MrLordLeon/TNCMCU/README.md

# Project 2: TNCMCU

**Project Members:**
- David C.
- Kobe K.
- Kaleb L.

**Project Mentors:**
- Nolan E.
- Rizwan M.
- Nick P.
- James P.

## Project Description
Current implementations of the Terminal Node Controller use a telephone FSK modem to transmit binary  data via the APRS system. These FSK modems are outdated, unavailable, and obsolete. The signals are transmitted at 1200 baud using audio signals of 1200 and 2200 Hz.

## Project Challenge
Design, implement, build, and test aTNCwith an STM32 or similar microcontroller. The system must accept a string via UART or a similar interface and generate the necessary APRS and HDLC headers/packet data and then produce the correct audio waveform. This audio waveform will then be fed to a speaker, handheld radio, HAM radio set, or dedicated FM modulator (design team not responsible for this portion, only the audio waveform generation).The system must also accept an audio waveform input from a microphone, handheld radio, HAM radio set, or dedicated FM receiver (design team not responsible for this portion, only the audio waveform interpretation) and be able to translate this audio into APRS/HDLC, and transmit a fully translated message to the controlling device via UART or a similar interface.The  initial implementation should use COTS development kits as a proof of concept. Once the software and design have been verified and validated, the hardware shall be implemented into a standalone PCB with connections for a PC, Raspberry PI, Arduino, and standard handheld radio.

###### The team will have to familiarize themselves with the following:
- microcontroller C programming and hardware including:
	- timers
	- interrupts
	- ADC 
	- DAC
	- various comms interfaces
	
- schematic design and PCB layout
- analog circuitry design
- APRS, HDLC, and other packet radio standards
- responsible software development using thorough verification/validation techniques including:
	- flowcharting
	- failure analysis
	- unit testing
	- etc.

Ideally, this team would be composed of 2 students able to put at least 8 hours per week on this project. I have already done some proof of concept work on the frequency detection and sine waveform generation, and both features work to my satisfaction.

## Repo notes
*Not a permanent structures, very flexible!*

**Design Deliverables -** Generally anything we need for assignments or papers can be put here

**Hardware Specs -** Documentation for any hardware used in the project. Renaming the file to something interpretable is preferred, I.E. don't download from mouser and have the file named file001.pdf.

**Presentations -** This is where we'll keep presentations for mentors or Dr. Darby. Please preceed file name with date of presentation.

**Protocol Documentation -** This is where any relevant information about AX.25/KISS/HDLC/etc... can go. Same process with the hardware specs, useful naming means useful people.

**Schematics -** This is where we put our schematics for our external circuits.

**Software -** This is where all of our main code and testing software is stored.

**Subsystem Documentation -** This is where we store our information on CRC calculation.
