MrLordLeon/TNCMCU/Presentations/11_2_20 EECE-443-Design-I-Team2- TNC-MCU-Design-Deliverable 5 Presentation.pptx

## MCU TNC Deliverable 5

David Cain, Kobe Keopraseuth, and Kaleb Leon

## Testing Tree Progress

## Hardware

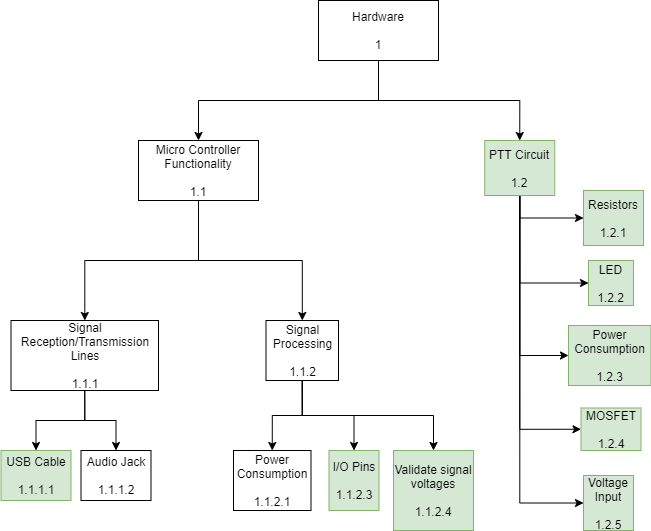
[picture p1: figure]

## Software

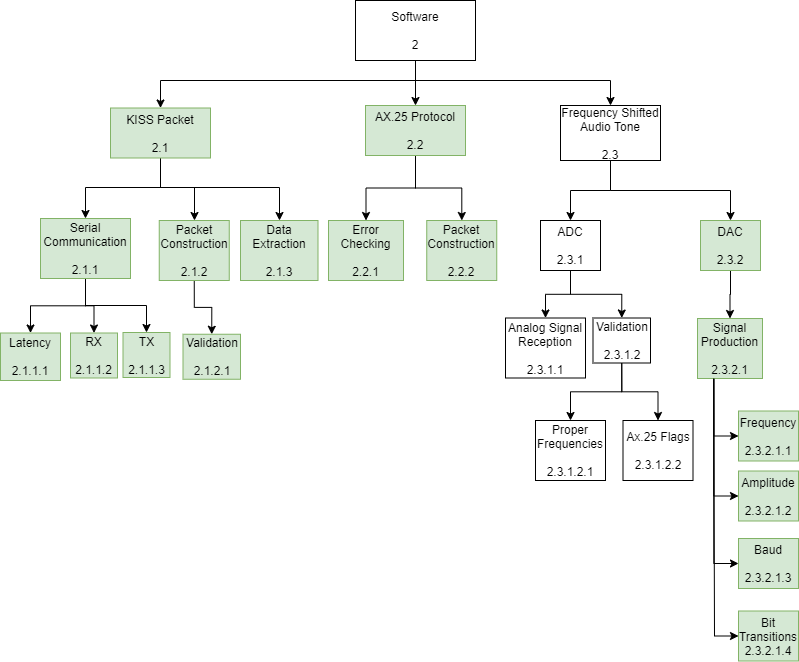
[picture p2: figure]

## Testing Forms

## Slide 6

## Slide 7

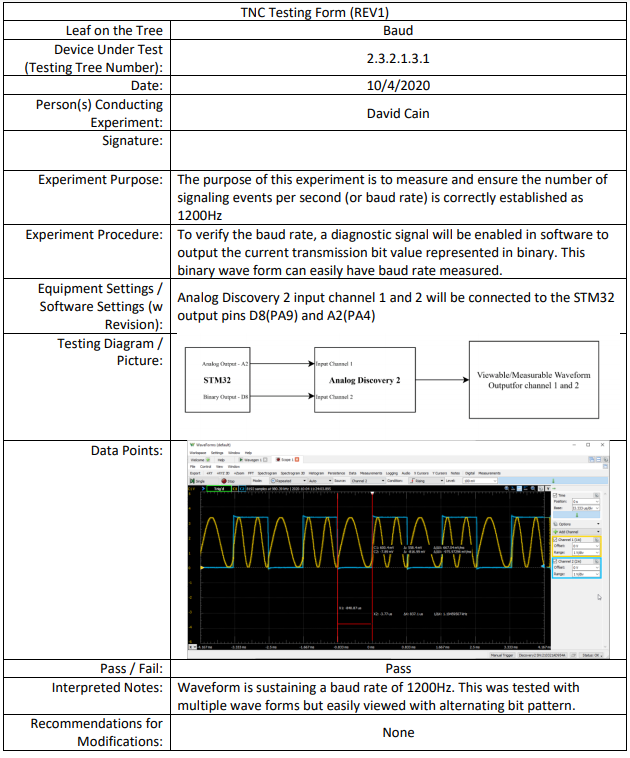
[picture p3: figure]

## Slide 8

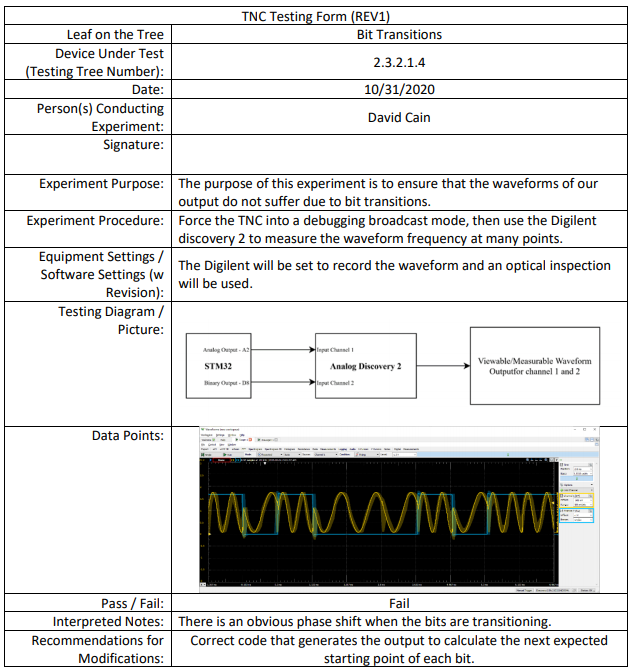
[picture p4: figure]

## Slide 9

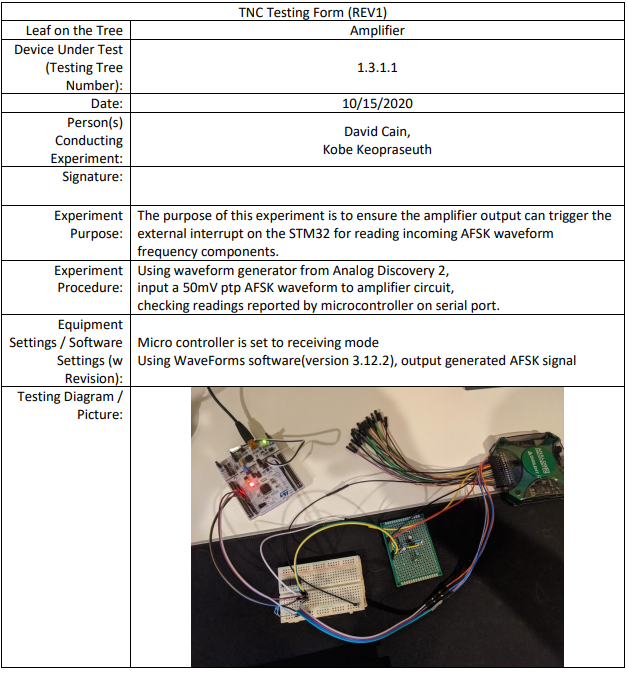
[picture p5: figure]
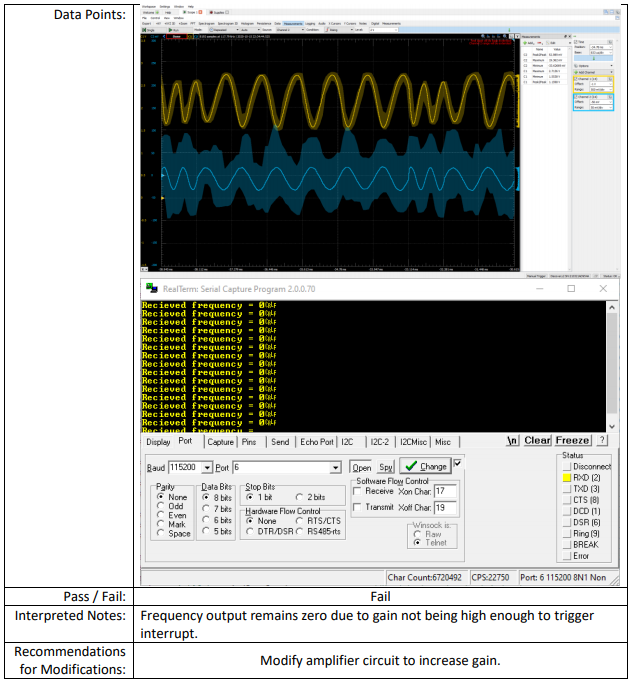
[picture p6: figure]

## Slide 10

## Changes Made to Testing Plan

- Removing Audio Input Circuit (1.3)
  - Amplifier (1.3.1) also removed
  - LP Filter (1.3.2) also removed
- Testing clock recovery and data decoding with new board provided by the mentors
- Removed RS232 Jack (1.1.1.3)
- Removed Validation (2.2.2.1) under packet construction because it was redundant

## Change Order Forms

## Slide 13

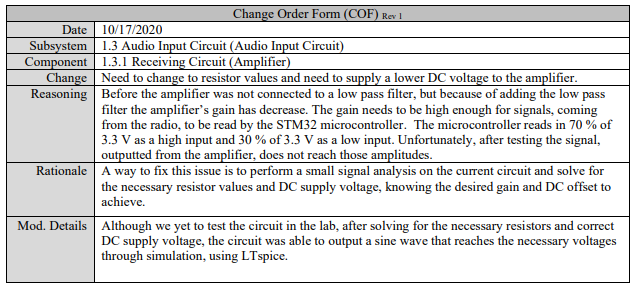
[picture p7: figure]

## Slide 14

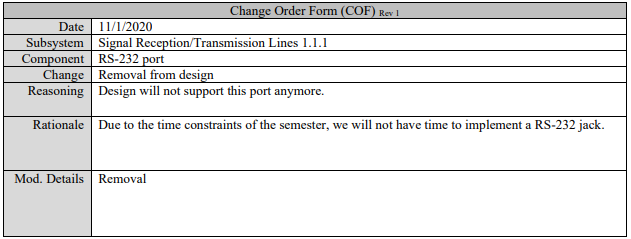
[picture p8: figure]

## Slide 15

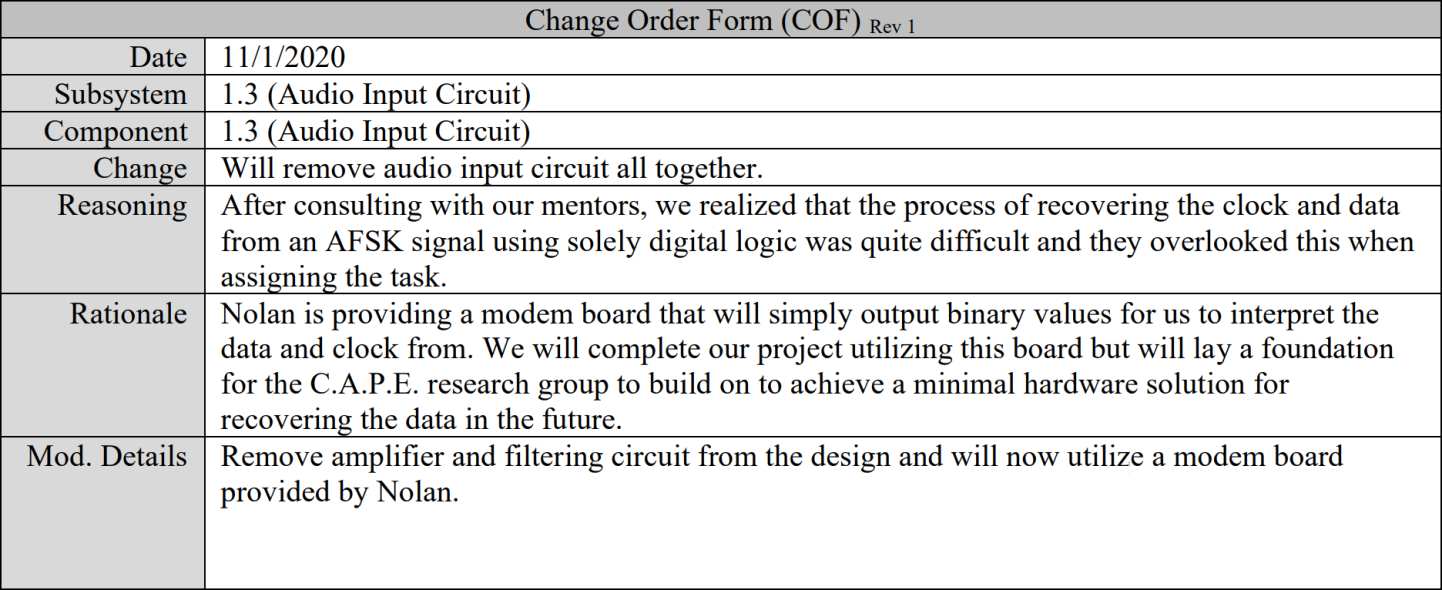
[picture p9: figure]

## Tests to be done by Project End

- Analog to Digital Conversion aka Receiving
  - Needs additional tweaking to have initial functionality
- Audio tone RX and TX full subsystem test
- Full software test
- Micro Controller functionality testing
  - Power Consumption (1.1.2.1) in Signal Processing
  - Audio Jack (1.1.1.2) in transmission lines
- Full Final Design Testing Coming soon

## Questions?
