MrLordLeon/TNCMCU/Design Deliverables (Paper Revisions)/Deliverable 5/11_2_20 EECE-443-Design2-Team2- TNC-MCU-Design-Deliverable 5 Presentation.pptx

## MCU TNC Deliverable 5

David Cain, Kobe Keopraseuth, and Kaleb Leon

## Testing Tree Progress

## Hardware


## Software


## Testing Forms

## Slide 6

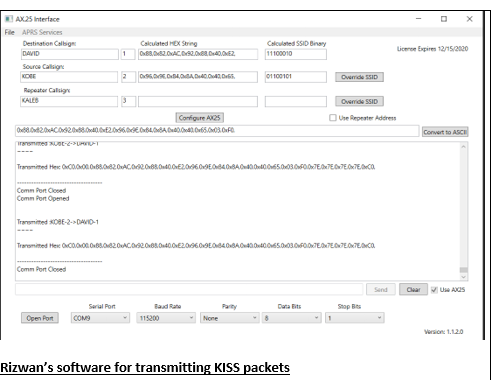
[picture p10: figure]
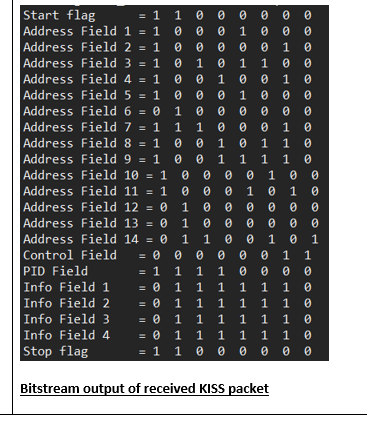
[picture p11: figure]

## Slide 7

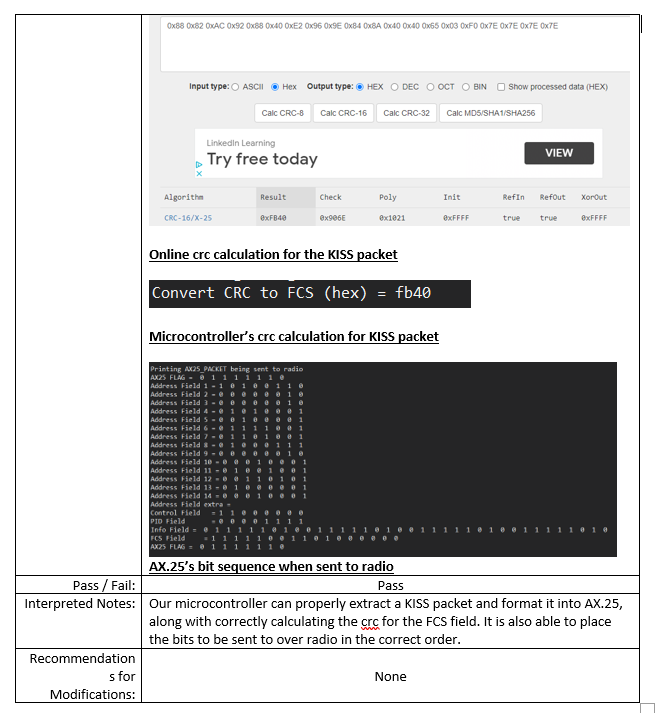
[picture p12: figure]

## Slide 8


## Slide 9


## Slide 10


## Slide 11

## Changes Made to Testing Plan

- Removing Audio Input Circuit (1.3)
  - Amplifier (1.3.1) also removed
  - LP Filter (1.3.2) also removed
- Testing clock recovery and data decoding with new board provided by the mentors
- Removed RS232 Jack (1.1.1.3)
- Removed Validation (2.2.2.1) under packet construction because it was redundant

## Change Order Forms

## Slide 14


## Slide 15


## Slide 16


## Tests to be done by Project End

- Analog to Digital Conversion aka Receiving
  - Needs additional tweaking to have initial functionality
- Audio tone RX and TX full subsystem test
- Full software test
- Micro Controller functionality testing
  - Power Consumption (1.1.2.1) in Signal Processing
  - Audio Jack (1.1.1.2) in transmission lines
- Full Final Design Testing Coming soon

## Questions?
