MrLordLeon/TNCMCU/Design Deliverables (Paper Revisions)/Weekly Status Report/Kobe/Design 1 Status Report 2.docx

Weekly Status Report

Report 1

TNC MCU Project Design

Kobe Keopraseuth

C00092349

Tuesday, March 3, 2020

Work and accomplishments this week

- Research Digipeaters and Bit stuffing for AX.25 protocol.
- Make flow chart of design to give to mentors for confirmation
- Make poster of project
- Peer Review of Group 1

Planned Activities for Next Week

- Make edits to our Assignment 1
- Meet with mentors

Time Sheet

Item | Date/Time | Description | Hours
1 | 2/20/2020 5:00pm-7pm | Make Poster of project | 2
2 | 2/26/2020 1:00pm-7pm | Flow Chart for Mentors | 6
3 | 2/25/2020 11am-3pm | Research Digipeaters and Bit stuffing for AX.25 protocol. | 4
4 | 3/1/2020 5:00pm-7pm | Peer Review Team 1
| | Total:

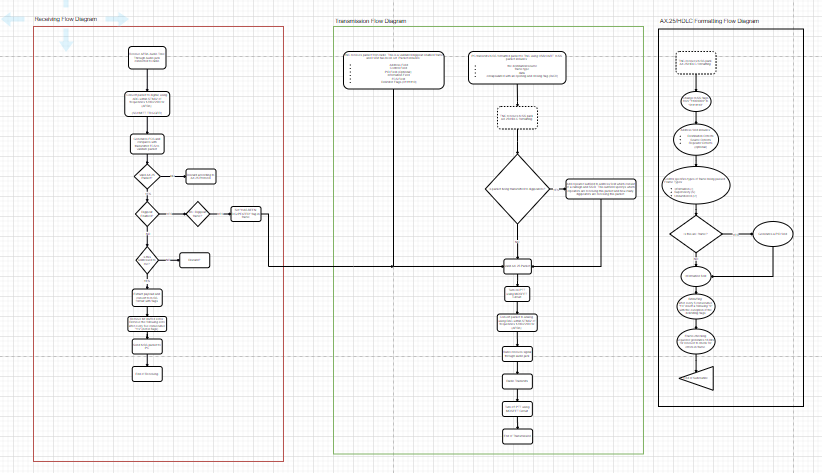
[picture p34: figure]
