MrLordLeon/TNCMCU/Design Deliverables (Paper Revisions)/Weekly Status Report/Kobe/Design 1 Status Report 3.docx

Weekly Status Report

Report 3

EECE 444

TNC MCU Project Design

Kobe Keopraseuth

C00092349

Tuesday, March 10, 2020

Work and accomplishments this week

- Assignment 1B
- Assignment 1C
- Meet with mentors
- Mandatory Cape Meeting
- Start using stm32 microcontroller

Planned Activities for Next Week

- Make edits to our Assignment 2
- Meet with mentors
- Getting more used to using the stm32 microcontroller

Time Sheet

Item | Date/Time | Description | Hours
1 | 3/3/2020 4:00pm-5pm | Meet with Mentors | 1
2 | 3/3/2020 6pm-7pm | Mandatory Cape Meeting | 1
3 | 3/7/2020 11am-6pm | Start using stm32 microcontroller | 7
4 | 3/9/2020 7:pm-10pm | Assignment 1B | 2.5
5 | 3/9/2020 10:pm-12pm | Assignment 1C | 2.5
| | Total: | 14

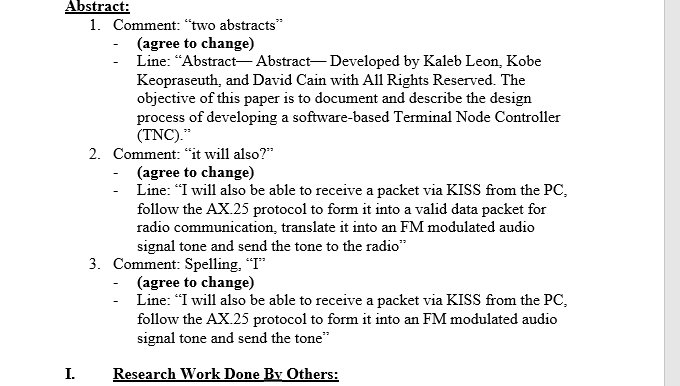
[picture p35: figure]
