MrLordLeon/TNCMCU/Design Deliverables (Paper Revisions)/Weekly Status Report/Kobe/Design 2 Status Report 1.docx

Weekly Status Report

Report 1

EECE 460

TNC MCU Project

Kobe Keopraseuth

C00092349

Monday, September 20, 2020

Work and accomplishments this week

- Deliverable 3:
- Diagram and Explanation of the tree
- Testing Tree
- CRC generation code:
- Value created based on input bit values
- Ltspice schematic of receiving circuit:
- Low Pass Filer
- Amplifier circuit

Planned Activities for Next Week

- Appendix F
- Test receiving circuit

Time Sheet

Item | Date/Time | Description | Hours
1 | 9/20/2020 5pm-9:30pm | Deliverable 3 | 4.5
2 | 9/19/2020 2pm-7pm | CRC code | 5
3 | 9/17/2020 | Rx circuit schematic | 4.5
| | Total: | 14

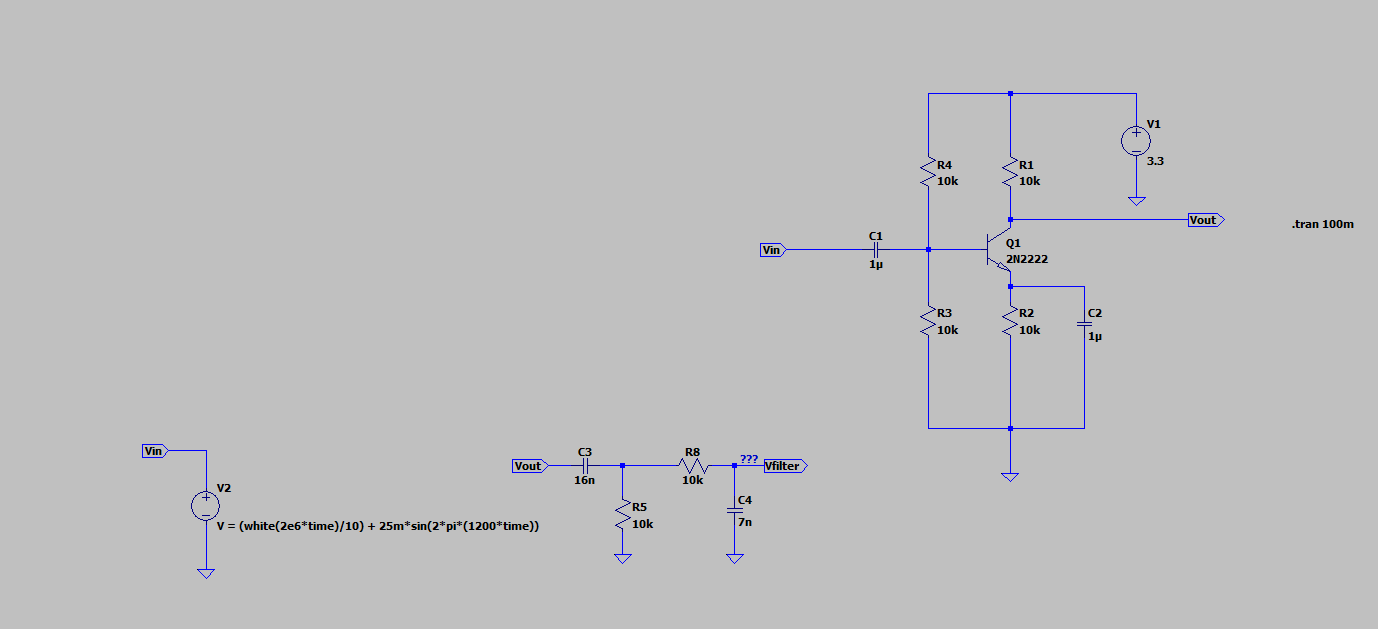
[picture p36: figure]
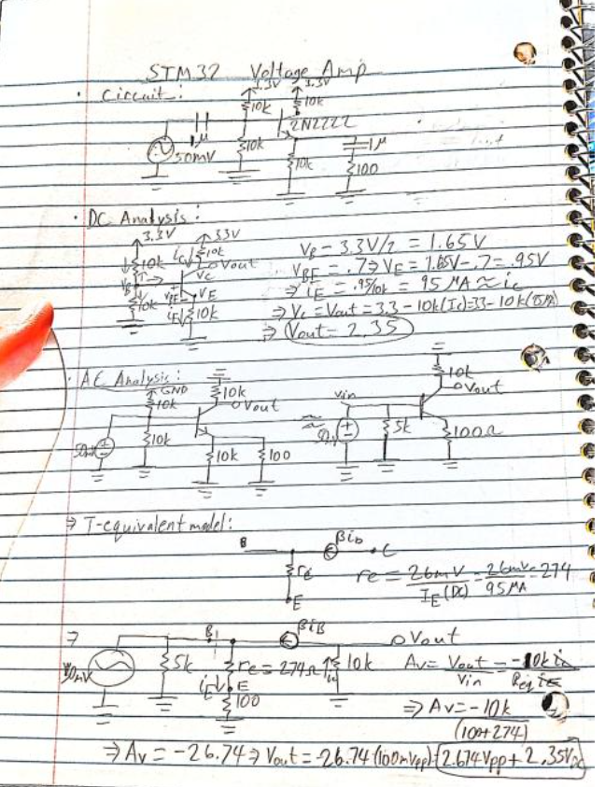
[picture p37: figure]
