MrLordLeon/TNCMCU/Design Deliverables (Paper Revisions)/Weekly Status Report/Kobe/Design 2 Status Report 3.docx

Weekly Status Report

Report 3

EECE 460

TNC MCU Project

Kobe Keopraseuth

C00092349

Monday, October 5, 2020

Work and accomplishments this week

- Code for comparing FCS field with crc generation:
- Created a function to generate a crc value with the incoming packet and compare with the packet’s FCS field to compare if they are equal, then it is a good packet.
- Solder PTT circuit

Planned Activities for Next Week

- Appendix F
- Test noisy signals received
- Prepare midterm

Time Sheet

Item | Date/Time | Description | Hours
1 | 10/3/2020 5pm-10pm | Code for CRC generatio | 5
2 | 10/4/2020 1pm – 6pm | Solder PTT | 5
| | Total: | 10

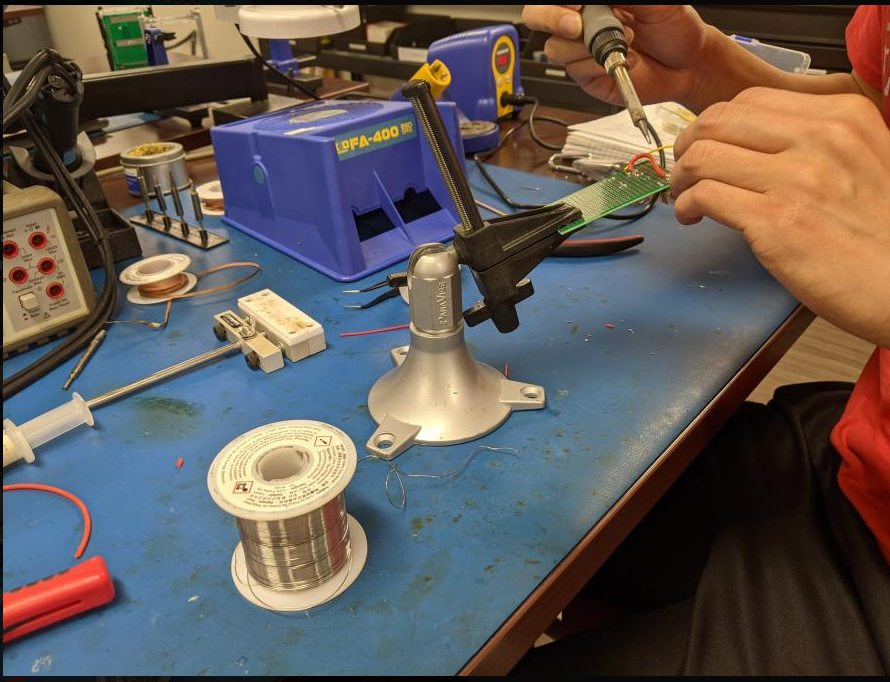
[picture p39: figure]
