MrLordLeon/TNCMCU/Design Deliverables (Paper Revisions)/Testing Documents/Complete Tests/Hardware/1.1.2.4.docx

TNC Testing Form (REV1)
Leaf on the Tree | Validate Signal Voltages
Device Under Test (Testing Tree Number): | 1.1.2.4
Date: | 11/1/20
Person(s) Conducting Experiment: | Kobe Keopraseuth, Kaleb Leon, David Cain
Signature:
Experiment Purpose: | The purpose of this experiment is to test to make sure the voltages are accurate for our analog signal on the microcontroller.
Experiment Procedure: | We will send a square wave analog signal from the Nucleo, that is generated by waiting a number of milliseconds and change the GPIO pin to output a 0 or 1. We set the amplitude to a specific value to be measured in our scope analog discovery.
Equipment Settings / Software Settings (w Revision): | We use the nucleo board with the code shown below to produce the signal. Then we read the signal using our analog discovery shown on channel 2 in the data points.

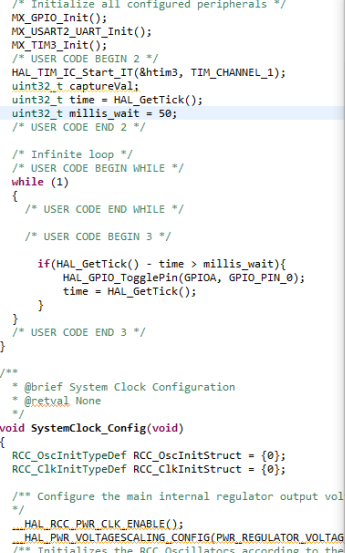
[picture p43: figure]

Testing Diagram / Picture:

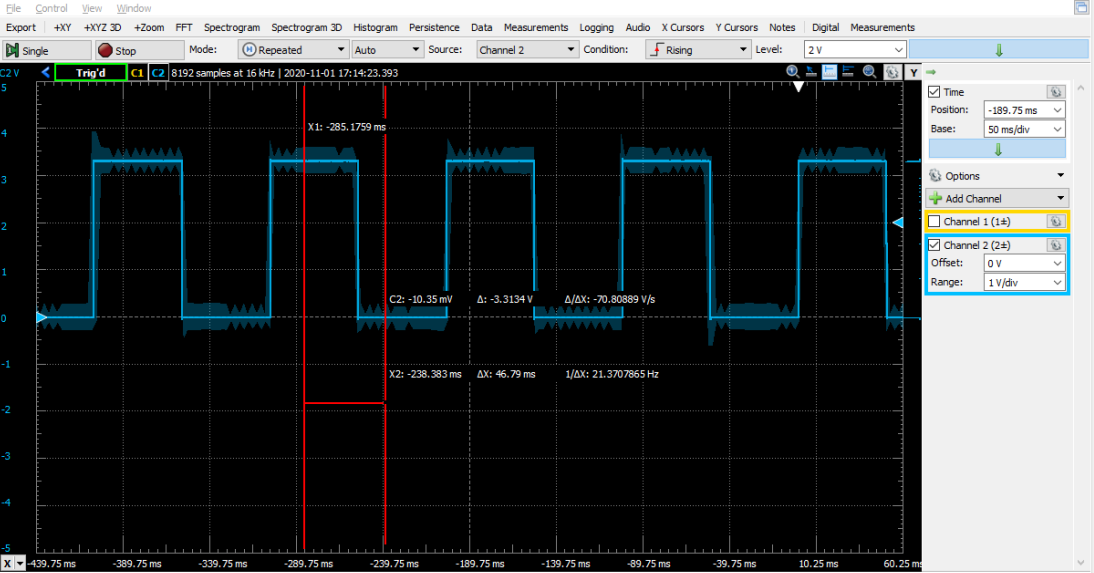
[picture p44: figure]

Data Points:
Pass / Fail: | Pass
Interpreted Notes: | The signal being displayed is correct because the amplitude of the wave meets the input set in the Nucleo code.
Recommendations for Modifications: | N/A
