MrLordLeon/TNCMCU/Presentations/10_19_20 Deliverable 4 Presentation.pptx

## MCU TNC Deliverable 4

David Cain, Kobe Keopraseuth, and Kaleb Leon

## Project Introduction

What is a TNC
A modem for connecting a computer with a HAM radio
KISS
AX.25
Why are we designing a TNC
Our design is a starting point for further development to be completed by the C.A.P.E. program
Thorough documentation

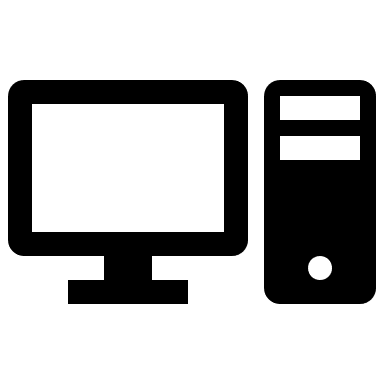
[picture p70: figure]
Computer

TNC

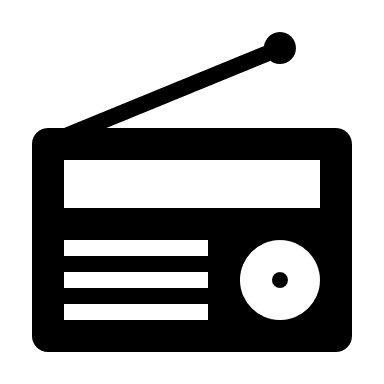
[picture p71: figure]
Radio

TNC

Diagram of TNC use

## Technical Details

KISS
Packet structure used to get information from computer into TNC
AX.25
Packet structure used when output audio waveform for radio to transmit
AFSK
Frequency encoding scheme used to represent data bitstream
Bi-modal frequency representation

AX.25 Packet Structure

## Current Progress

Code
Transmission
    - Using onboard DAC, an AFSK waveform is output
    - Baud rate is controlled by a timer interrupt for high precision
Receiving
    - Default mode until signaled to transmit
    - Count frequencies coming from radio by using external interrupt
Hardware
Transmission
    - MOSFET controls PTT line from radio
    - LED indicate transmission status
Receiving
    - BJT voltage amplifier circuit tuned to trigger hardware interrupt on controller
    - Output is filter with Low-Pass Filter
    - LED indicates Receiving status

## Remaining Effort

• Finish receiving logic
  - CRC calculation
  - Add more packet fault detection
  - NRZI Encoding detection
• Finish transmission logic
  - AFSK waveform currently has voltage blips from software
  - Add hardware for scaling down a 3.3V ptp AFSK signal
  - NRZI Encoding
