MrLordLeon/TNCMCU/Presentations/4_2_20 Assignment 2C Presentation.pptx

## Assignment 2C Presentation EECE 443 Team 2: MCU TNC Design Kaleb Leon – C00094357 Kobe Keopraseuth – C00092349 David Cain – C00043561 April 2nd, 2020

## MCU TNC Assignment 2C

David Cain, Kobe Keopraseuth, and Kaleb Leon

## Adjustments

Added Safety requirements to Preliminary Design. Considered specified needs with consideration of public health, safety, and welfare, as well as global, cultural, social, environmental, and economic factors.
Made and Added OSI layered communication model to Appendix D
Made flowchart easier to read as well as fixed some connections
Corrected any Grammatical and Formatting Errors needed

## Receiving Flowchart

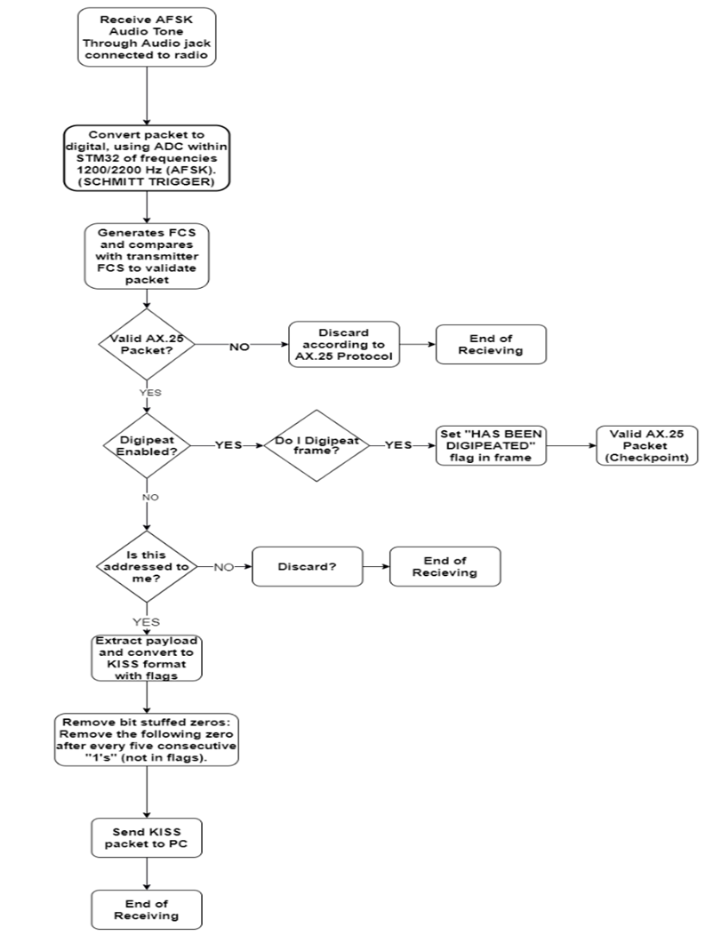
[picture p77: figure]

## Transmitting Flowchart

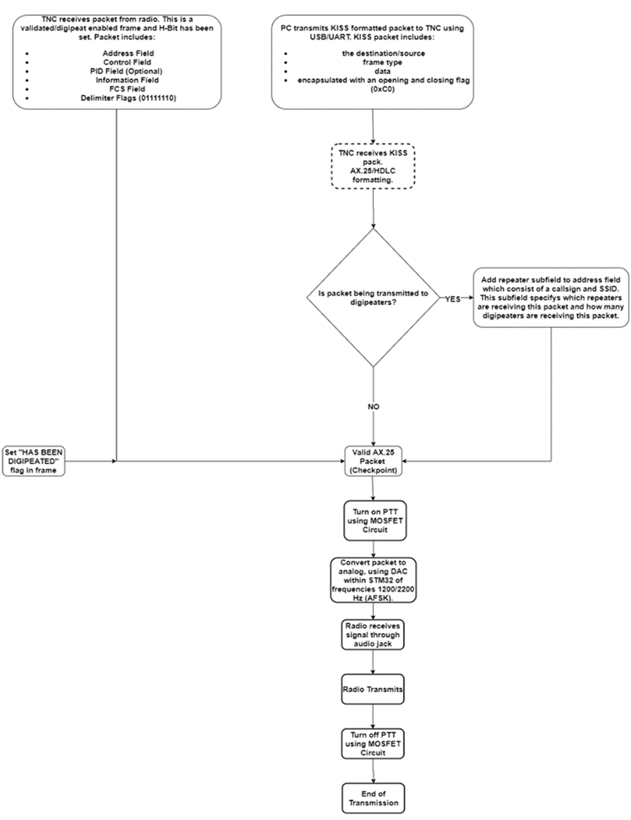
[picture p78: figure]

## Formatting Flowchart

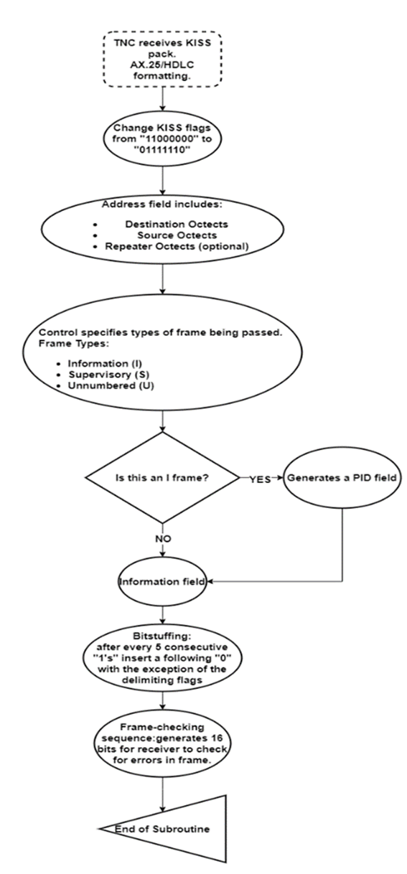
[picture p79: figure]

## OSI Layer Communications Model

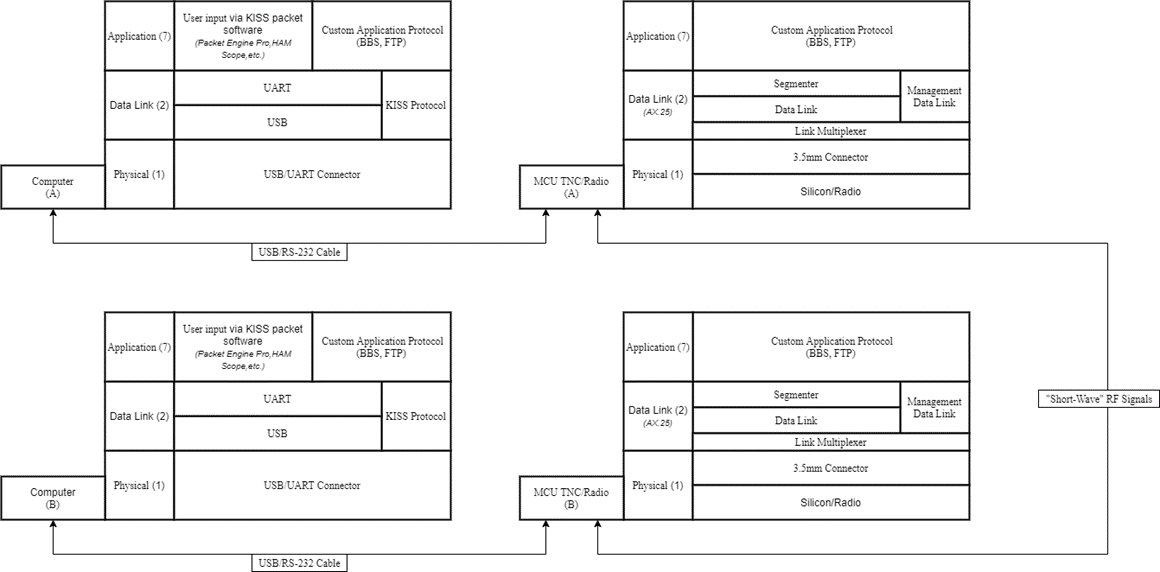
[picture p80: figure]
