MrLordLeon/TNCMCU/Presentations/3_20_20 Assignment 2 Presentation.pptx

## Assignment 2 Presentation EECE 443 Team 2: MCU TNC Design Kaleb Leon – C00094357 Kobe Keopraseuth – C00092349 David Cain – C00043561 March 20th, 2020

## MCU TNC Assignment 2

David Cain, Kobe Keopraseuth, and Kaleb Leon

## Preliminary Design

Simulations
BJT PNP Circuit - http://tinyurl.com/uvuus54
Voltage Divider - http://tinyurl.com/tjcqvlk
Calculations
Drawings
Bill of Materials
Instructions of Assembly
Failure Mode Effects Analysis
Level 0/Level 1 Diagram

## Calculations

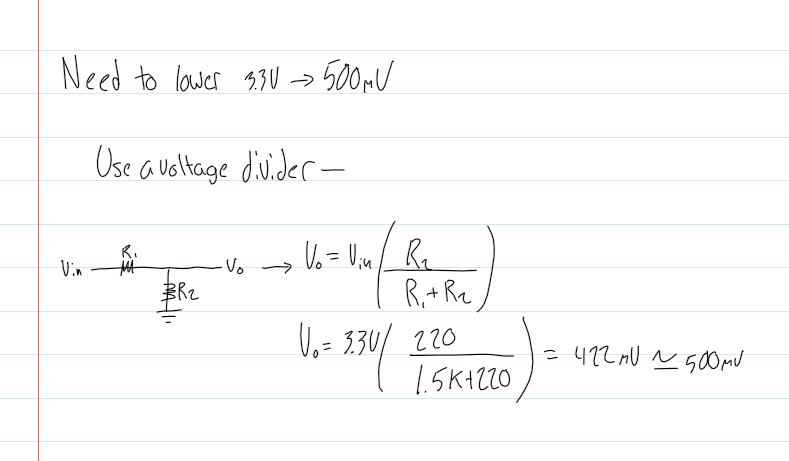
[picture p81: figure]

Voltage Divider Calculations

## Drawings

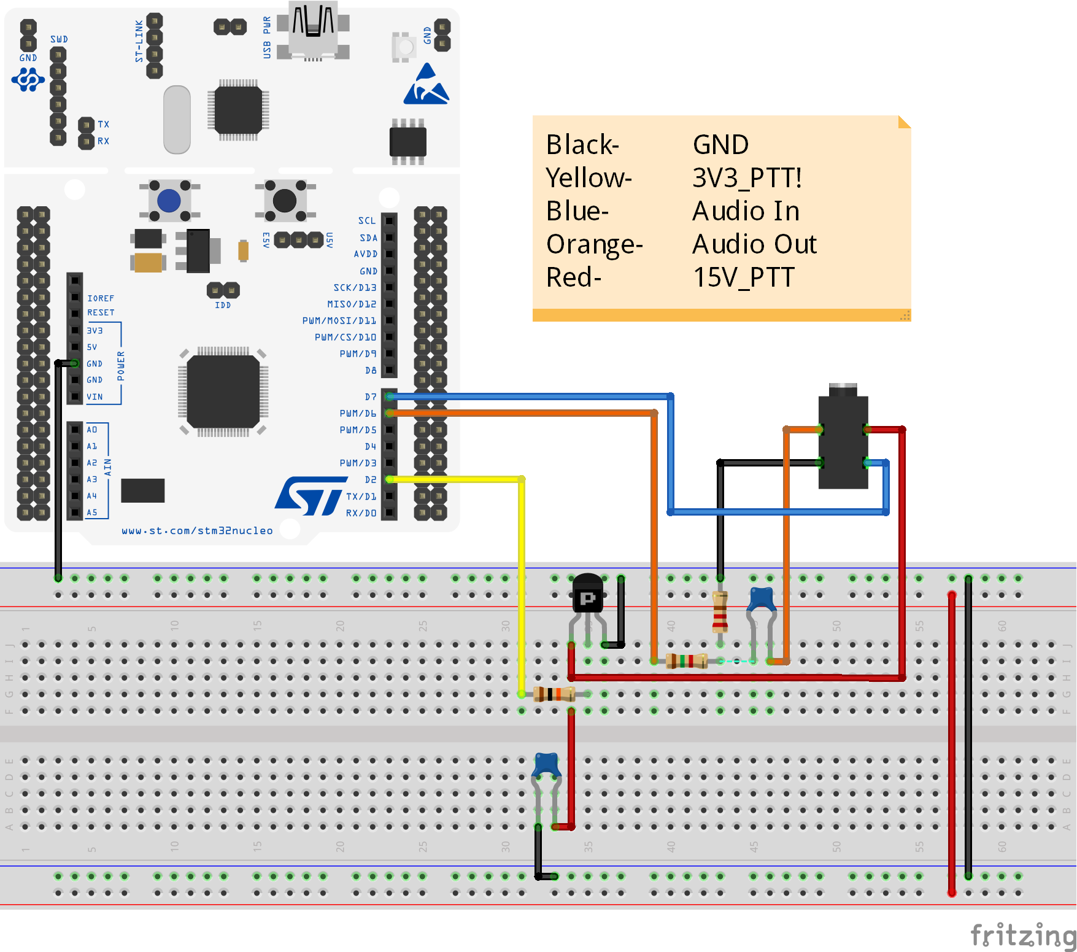
[picture p82: figure]
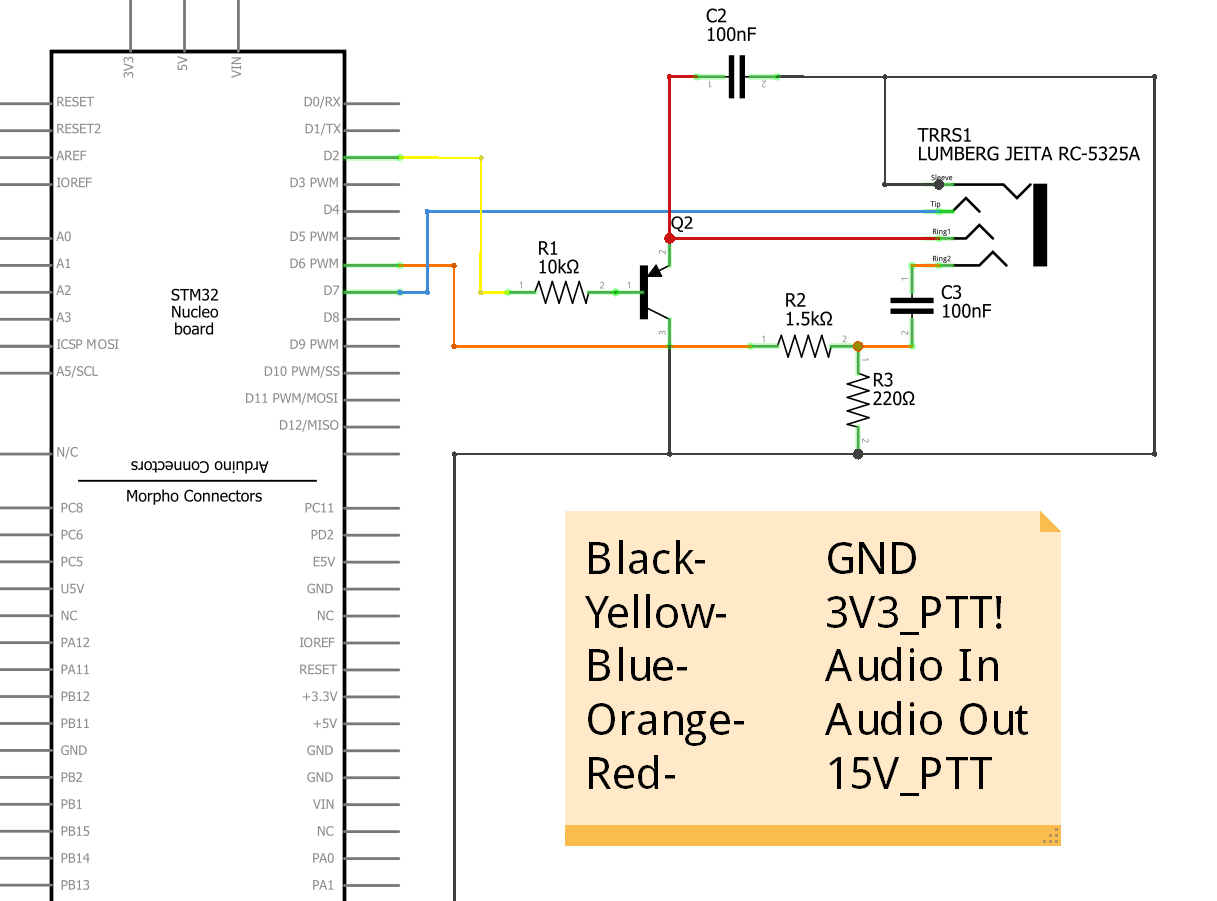
[picture p83: figure]

Breadboard Layout

Schematic Layout

## Bill of Materials

Bill of Materials Sent to Mentors

## Failure Mode Effects Analysis

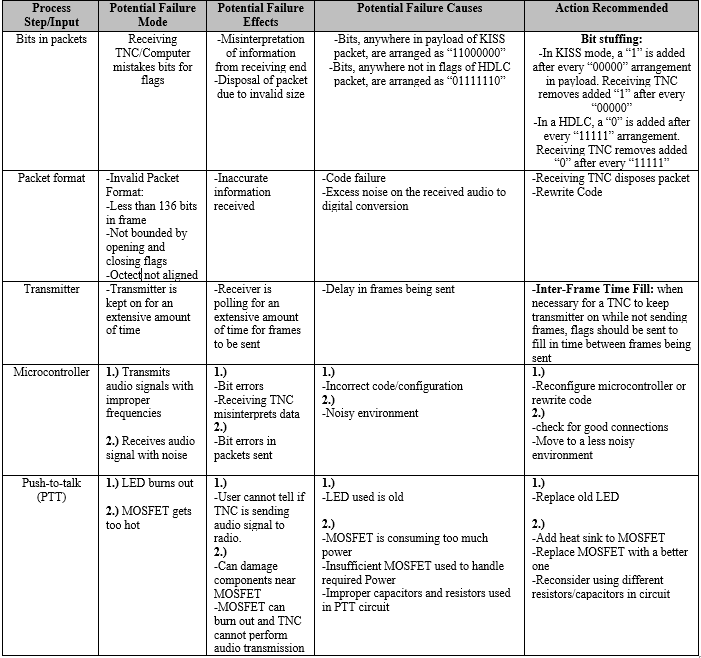
[picture p84: figure]

Failure Mode Effects Analysis

## Level 0/Level 1 Diagrams

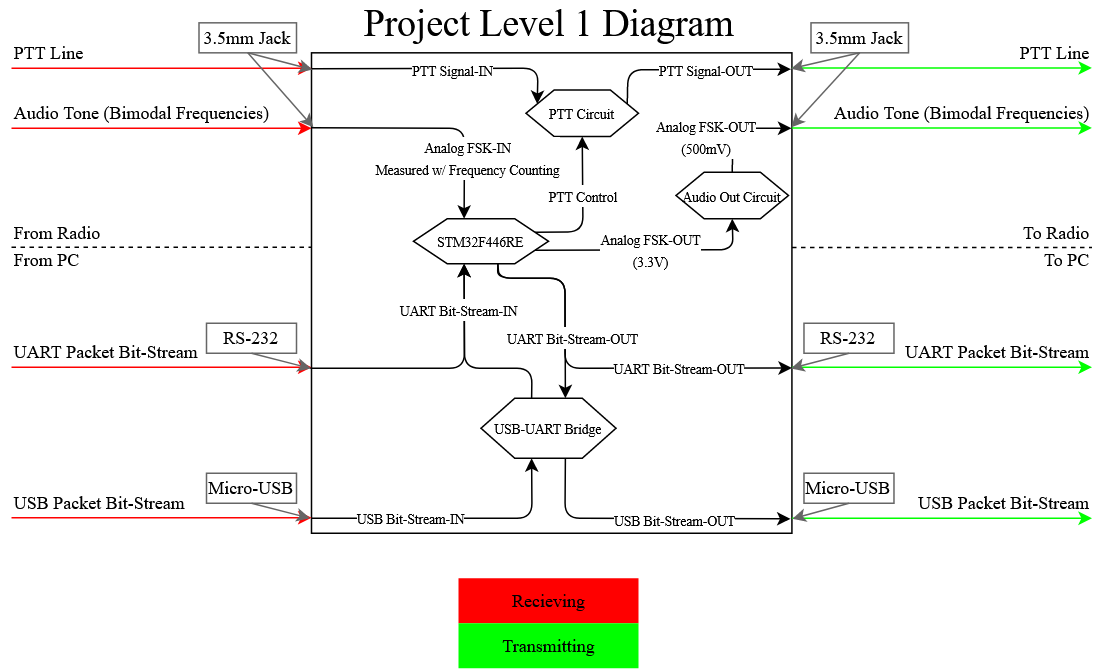
[picture p85: figure]
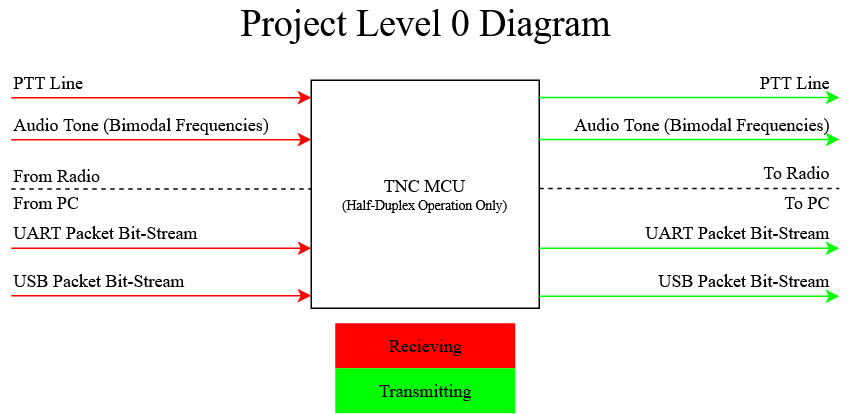
[picture p86: figure]

Level 0 Diagram

Level 1 Diagram
