MrLordLeon/TNCMCU/Hardware Specs/graph.pdf

Date/Time run: 02/14/20 00:00:46

* C:\Users\Kaleb\Desktop\Schematic1.sch Temperature: 27.0

Date: February 14, 2020 | Page 1 | Time: 00:34:12
(A) Schematic1.dat (active)

Time

0s | 2ns | 4ns | 6ns | 8ns | 10ns | 12ns
V2(R2)

-2.0V

0V

2.0V

4.0V

6.0V
