MrLordLeon/TNCMCU/Design Deliverables (Paper Revisions)/Assignment 3/EECE443 Design 1 Final Presentation - Team 2 MCU TNC Design.pdf

# MCU TNC Design

Kaleb Leon, Kobe Keopraseuth, David Cain Design 1
FINAL PRESENTATION

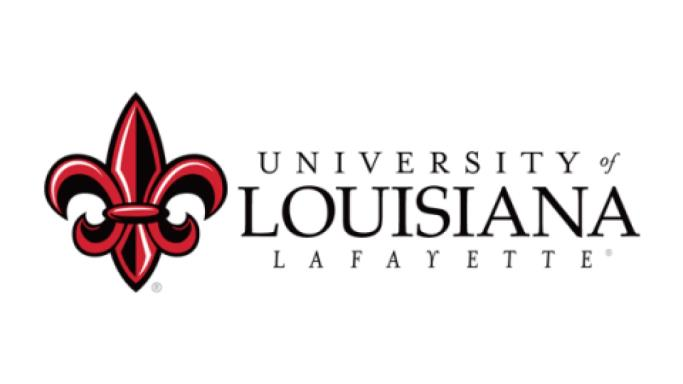
[picture p129: figure]

## Project Overview

Design a compact efficient Terminal Node Controller using the STM32 platform

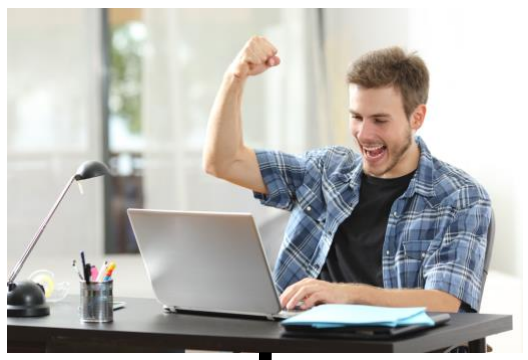
[picture p130: figure]
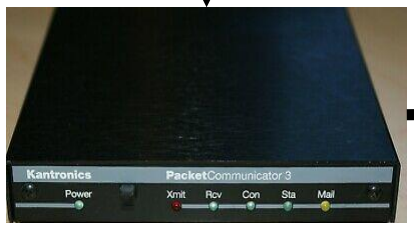
[picture p131: figure]

Radio | Radio

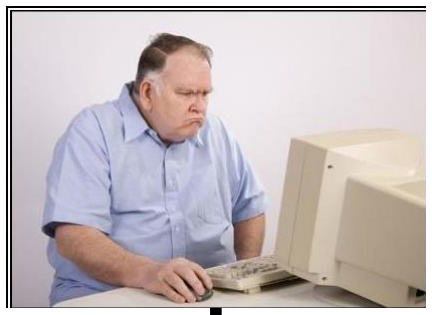
[picture p132: figure]

STM32 TNC | TAPR TNC-1

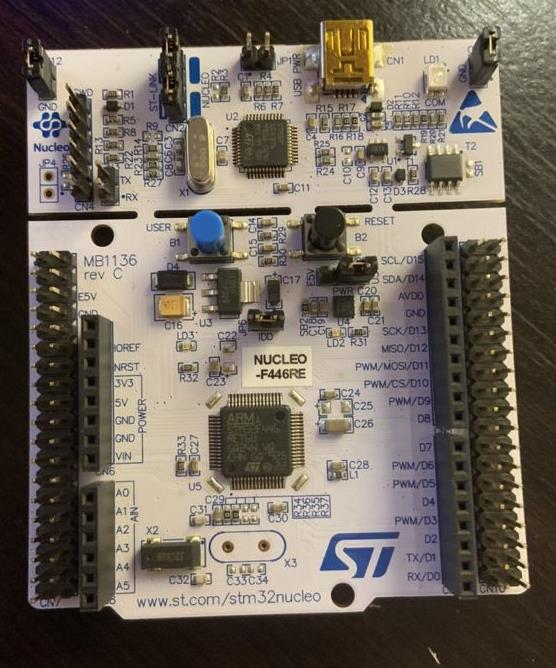
[picture p133: figure]

Size: 2’’x2’’
Logic:
Coded in C without much external hardware of chips
Hardware:
Nucleo STM32 Board
Documentation:
- Easier to document code ( also easier to find and reuse)
- Nucleo Board is proprietary hardware and well documented and tested

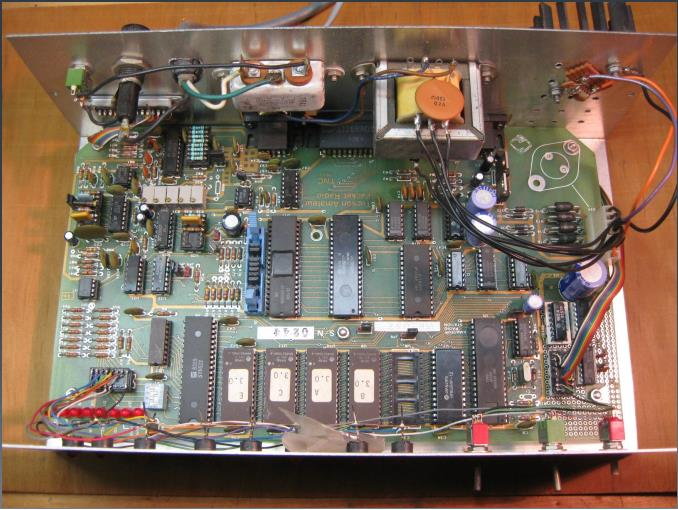
[picture p134: figure]

Size: 1’x6’’
Logic:
Data formatted mostly by analog logic chips Hardware:
Many circuits in addition to many integrated chips Documentation:
- Not well documented
- hard to find info to repair if something is wrong
- many different designs so only people who make these know how to fix them

VS.

Full Setup:
$53

Full Setup:
~ $140

# Design Process

## Scope of Work & Functional Block Diagram

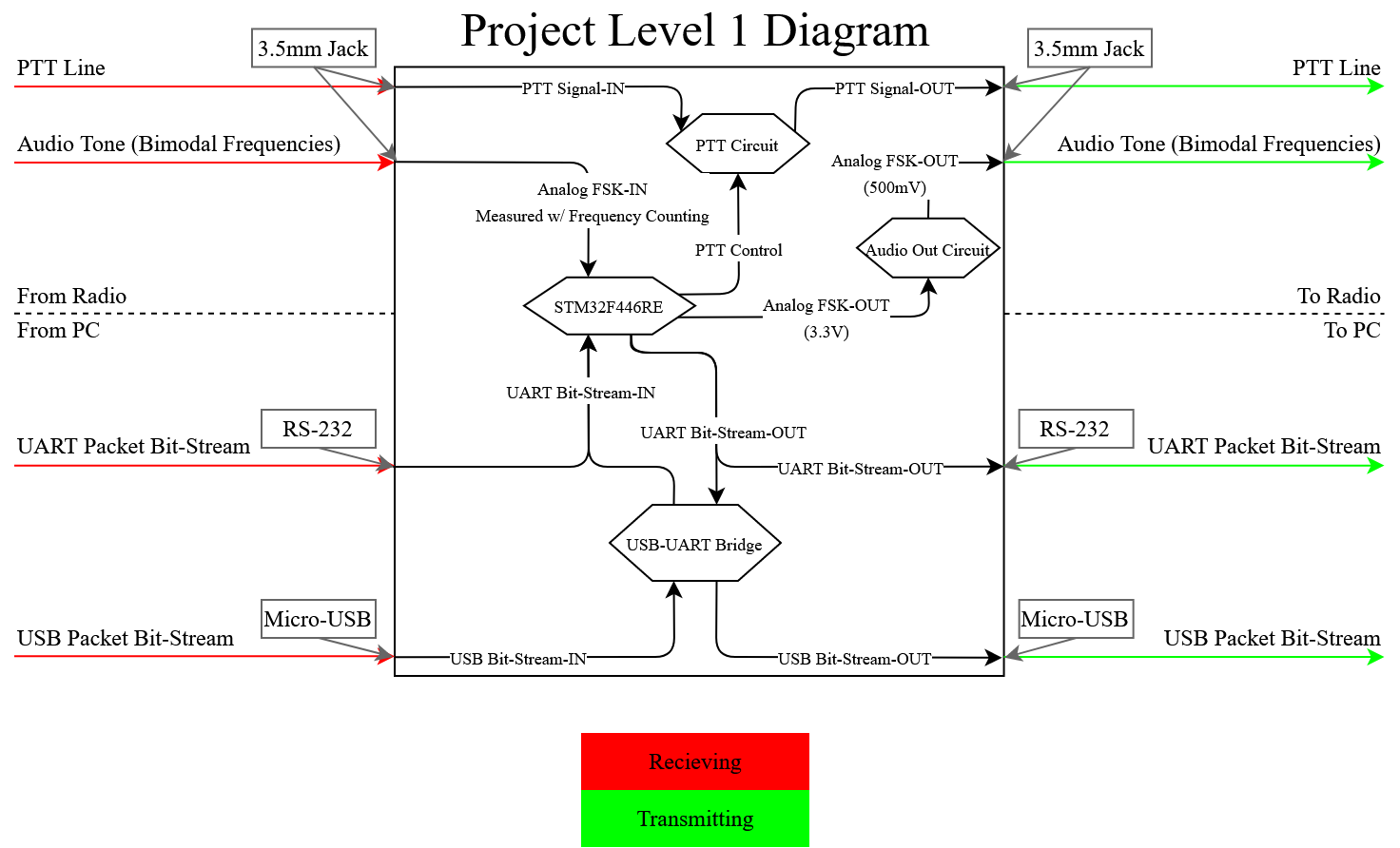
[picture p135: figure]

To Implement and
design a Terminal node
Controller using the
STM32 platform that is
capable receiving and
transmitting data
packets, serving as a
modem between a PC
and a radio.

## Alternatives and Tradeoffs

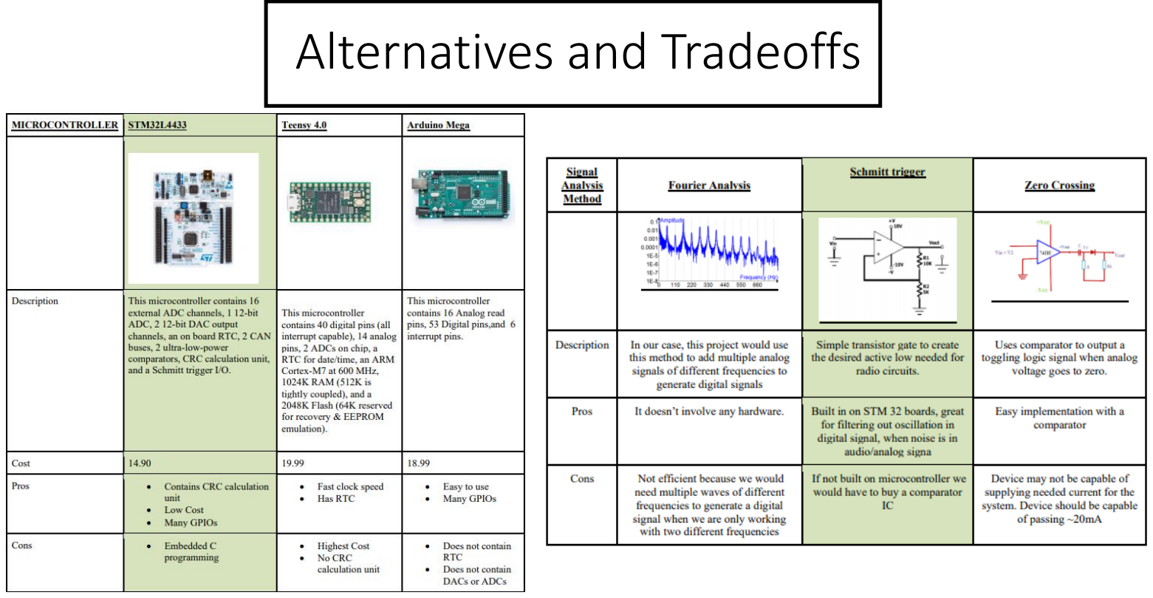
[picture p136: page 6]

## Alternatives and Tradeoffs

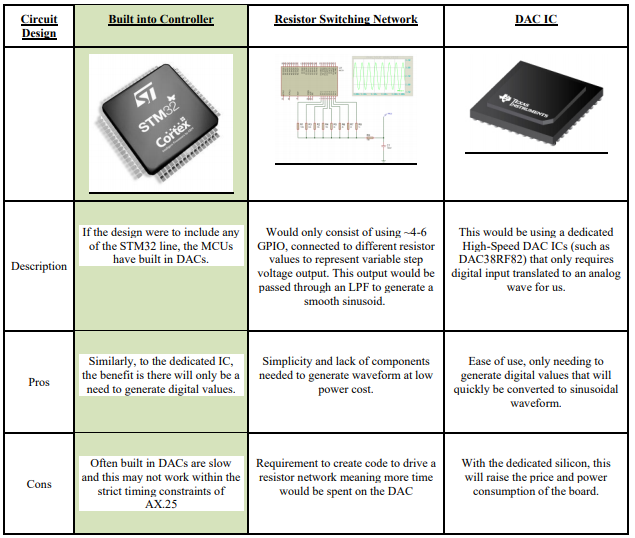
[picture p137: figure]

## Feasibility Analysis

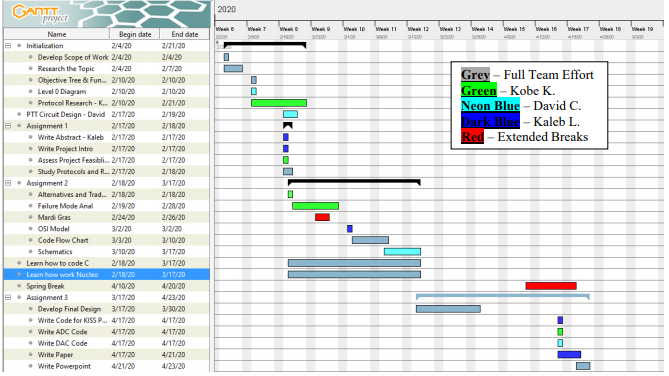
[picture p138: figure]

## Feasibility Analysis

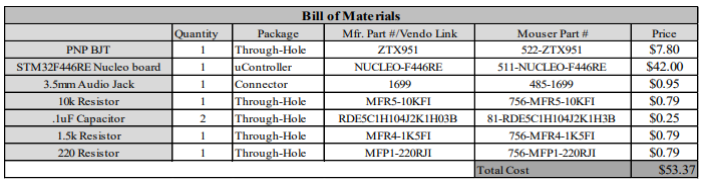
[picture p139: figure]

## Software Flow Breakdown

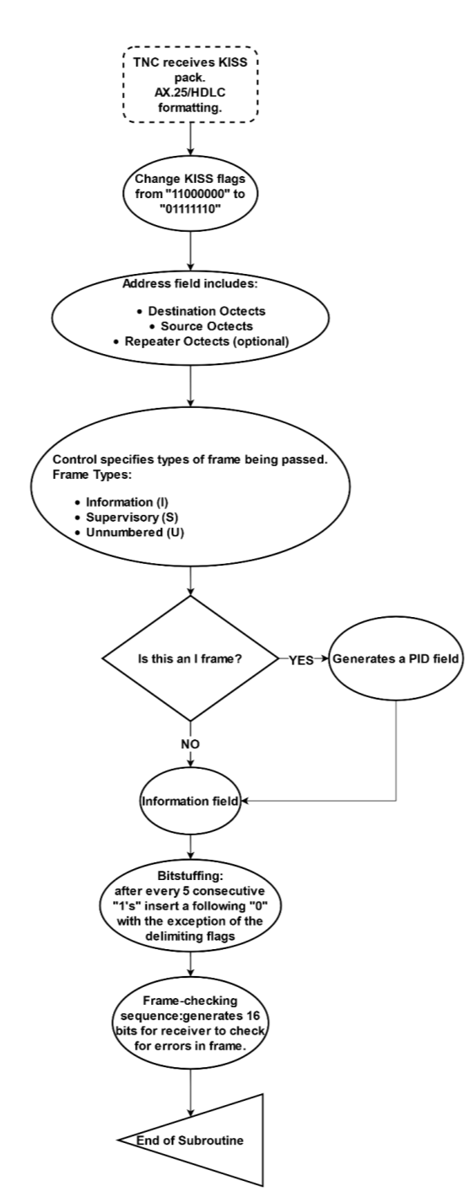
[picture p140: figure]

VALIDATION/TESTING:
Create our own packets of which we know what the data section says (example in HEX “Hello world”). This HEX packet is sent to the TNC over the USB. It is then picked apart for its data section. This data section is then translated back into HEX then Ascii and outputted to serial. We monitor this serial to see if it is outputting the correct data.

## KISS Packet to AX.25

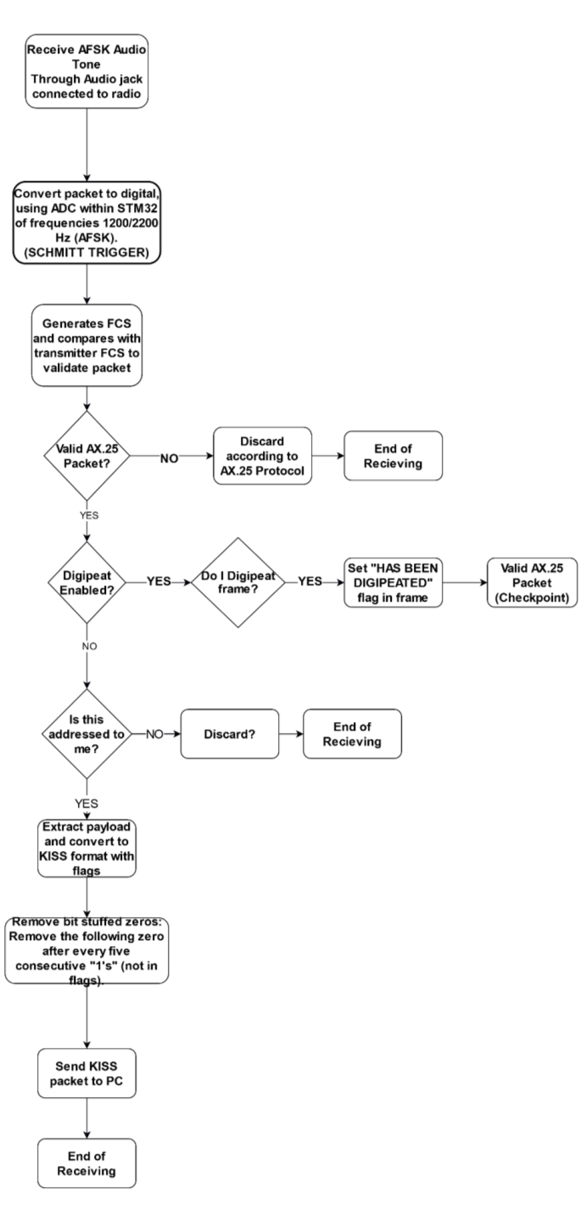
[picture p141: figure]

- In this mode the TNC will be receiving and measuring the frequency of the audio tones from the radio.
- If a tone matches 2200/1200 Hz (5% tolerance) then a 1/0 will be stored in an array, respectively.
- Once the conversion is finished, the STM32 will generate a CRC value to compare with FCS section of packet. If it does not match, then discard packet.
- If it does match, check if digipeat is enabled. If so, turn on PTT and got into transmitting mode.
- If digipeat is not enabled, then check if packet’s address matches the TNC’s address, if not discard.
- Convert packet stored in array to KISS format.
- Transmit packet to PC through USB or UART.

## Receiving Mode

Analog to Digital

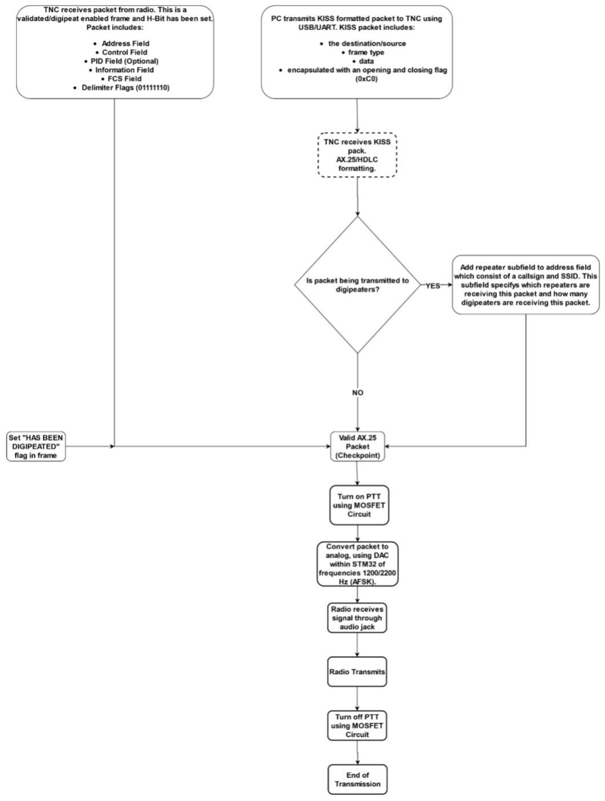
[picture p142: figure]

## Transmitting Mode

Digital to Analog

- In this mode the TNC will be producing audio tones to be received by the radio.
- The audio output will be a binary AFSK representation of the packet being sent
- The waveform values for 1200Hz/2200Hz are stored as an array to be converted using the onboard DAC.
- Before audio is being produced, the TNC will pull the PTT line low, indicating to the radio to begin receiving.
- Once the AFSK waveform has been sent to the radio, the PTT line will be released, putting the TNC back in to receiving mode.

## Modulation and Demodulation Validation

1. A short binary bitstream is hardcoded to be sent to the DAC
2. The microcontroller saves this bit stream to a memory location that is reference and then parsed through as it is sent to the DAC
3. The DAC creates an audio signal that is sent over wire back into the TNC where it is demodulated at the ADC code block
4. If the data returns the same as what was sent out the process is valid.

## OSI Layered Communication Model

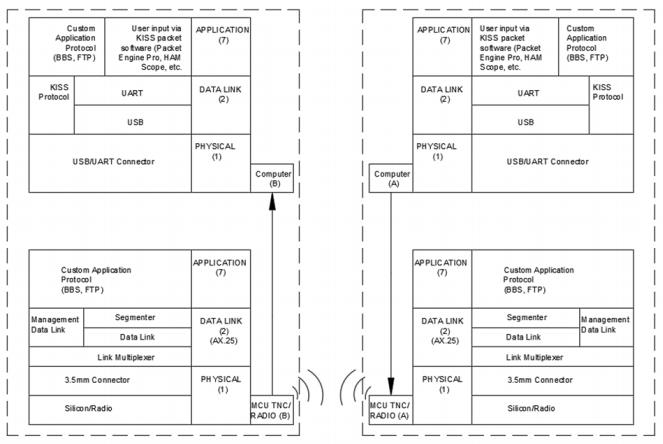
[picture p143: figure]

## Hardware Validation and Simulation

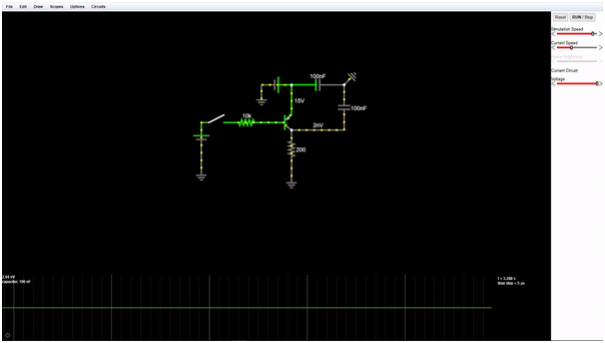
[picture p144: figure]

BJT Push to Talk Circuit

## Hardware Validation and Simulation

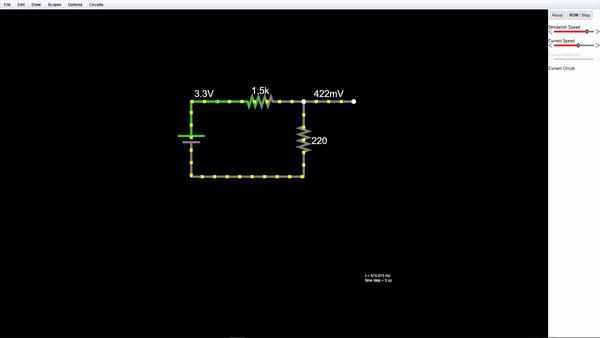
[picture p145: figure]

Voltage Divider to Control Voltage Output

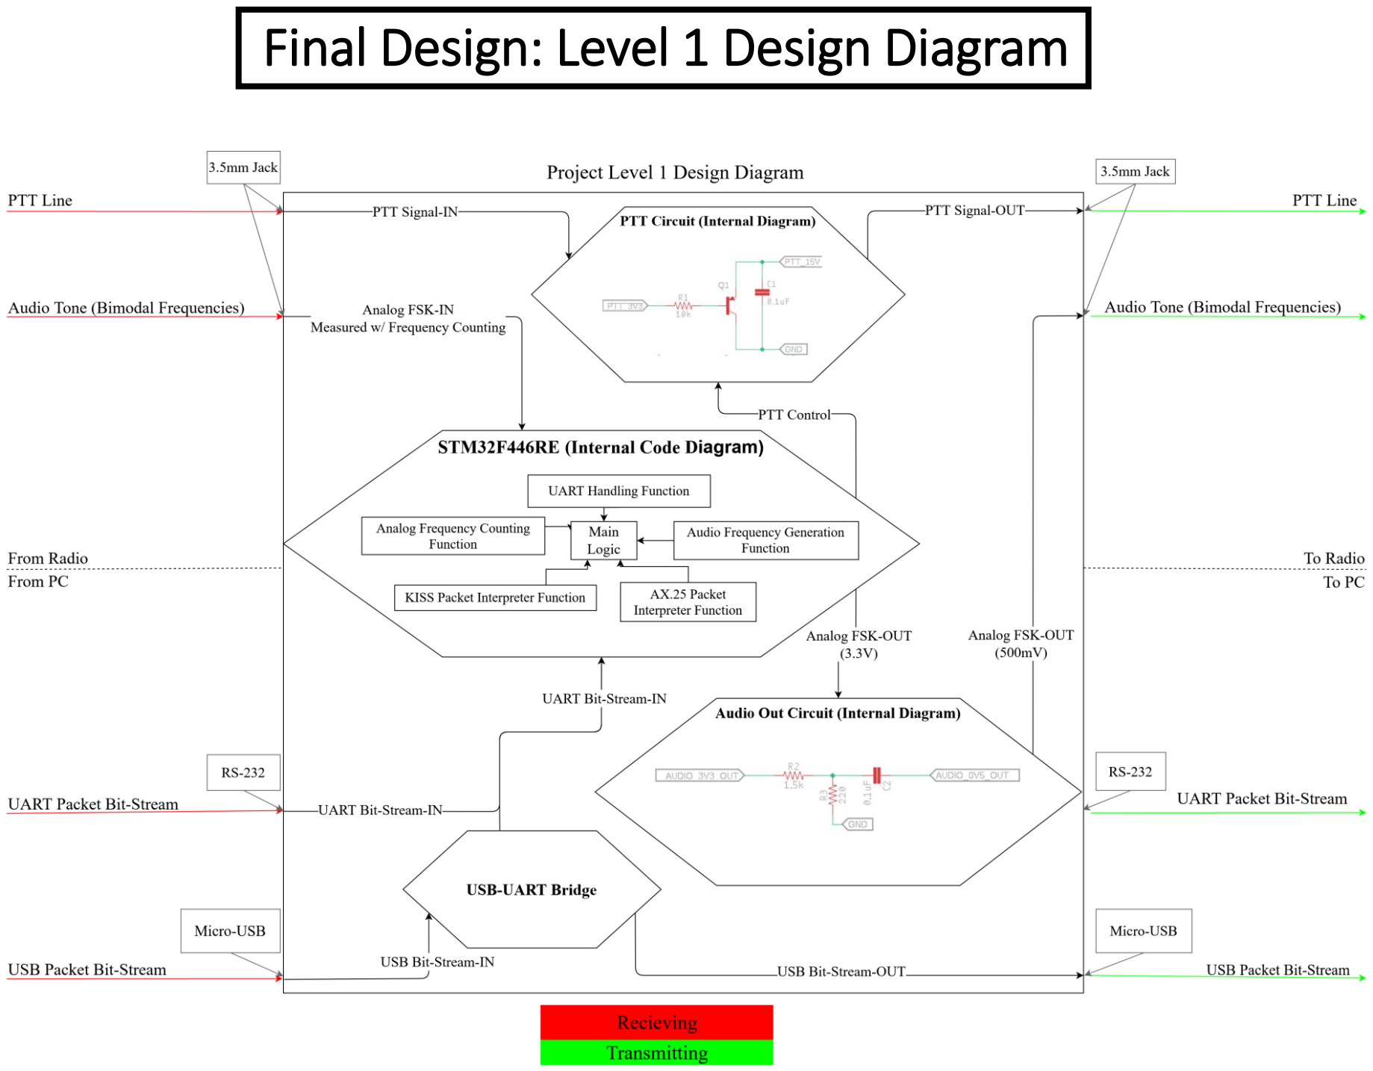
[picture p146: page 18]

Final Design: Level 1 Design Diagram

## Modular Wring Schematic

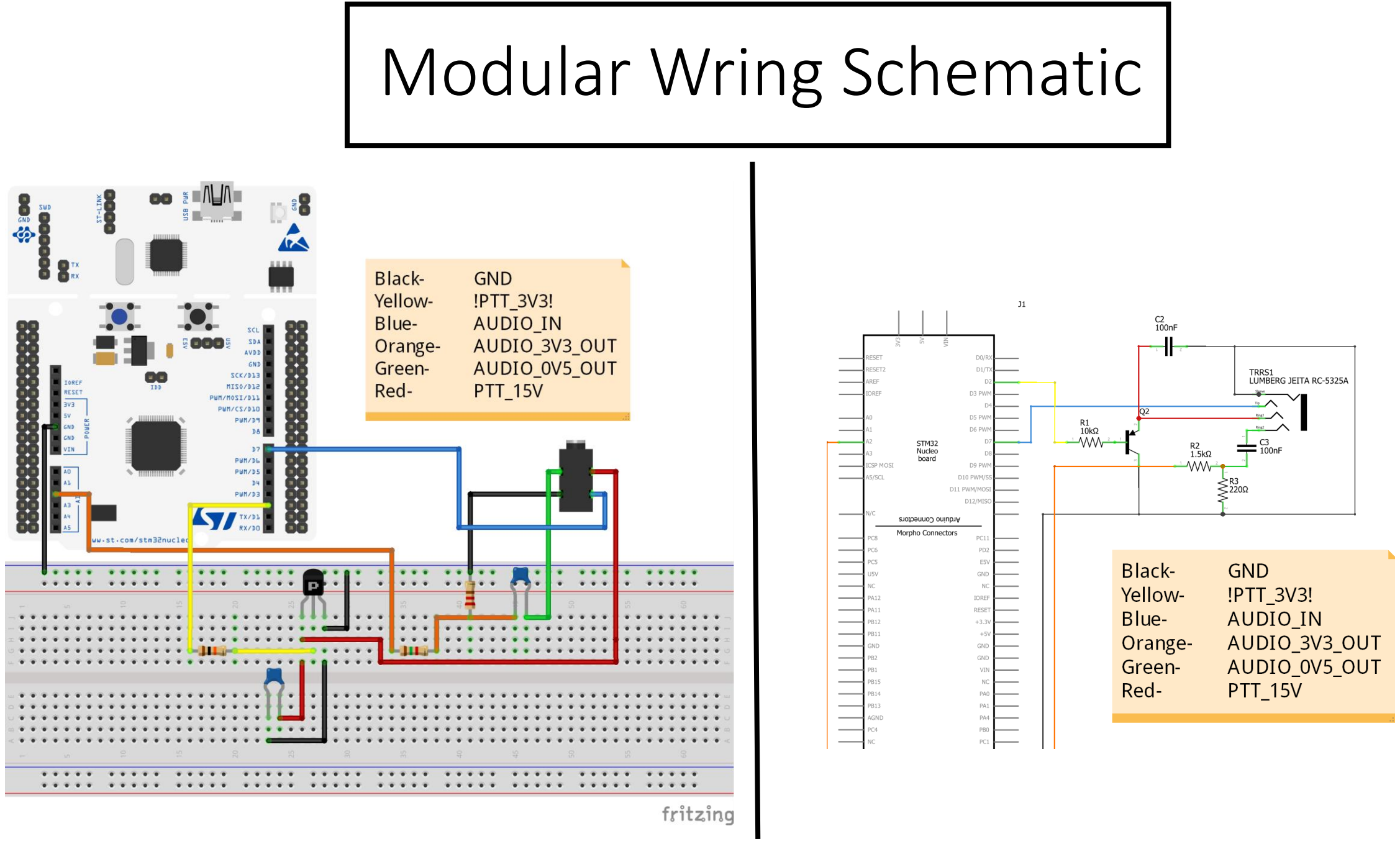
[picture p147: page 19]

## Acknowledgements

Project Mentors:
Mr. Nolan Edwards
Mr. Rizwan Merchant
Mr. Nick Pugh
Mr. James Palmer

Special Thanks:
CAPE Team
Pelican Engineering

## Future Plans

- Design PCB board for layout, for efficiency in space and power distribution.
- Possibly wireless communication to other radios.
- Design higher level software structures, such as APRS.
- Design casing to protect components.

## Lessons Learned

- How to write a scholarly paper.
- How to write in an embedded C environment.
- A successful design requires considerations of extreme operation conditions.

## Questions?
