MrLordLeon/TNCMCU/Design Deliverables (Paper Revisions)/Weekly Status Report/Kobe/EECE 443 Weekly Status Report-Week-6-Kobe Keopraseuth C00092349.pdf

Weekly Status Report
Report 6

EECE 444
TNC MCU Project Design

Kobe Keopraseuth
C00092349

Thursday, April 2, 2020

Work and accomplishments this week

- Assignment 2B
- Assignment 2C
- Fixing Flowchart
- Programming STM32 to read frequency inputs

Planned Activities for Next Week

- Assignment 3
- Meet with mentors
- Getting more used to using the stm32 microcontroller

Time Sheet

Item | Date/Time | Description | Hours
1 3/29/2020 | 1:00pm-5pm | Programming STM32 to read frequency inputs | 4
2 3/31/2020 | 6pm-7pm | Fixing Flowchart | 1
3 3/31/2020 | 3pm-6pm 4/1/2020 5pm-7pm | Assignment 2B | 5
4 3/31/2020 | 7:pm-10pm 4/1/2020 7pm-10pm | Assignment 2C | 6
Total: | | | 16

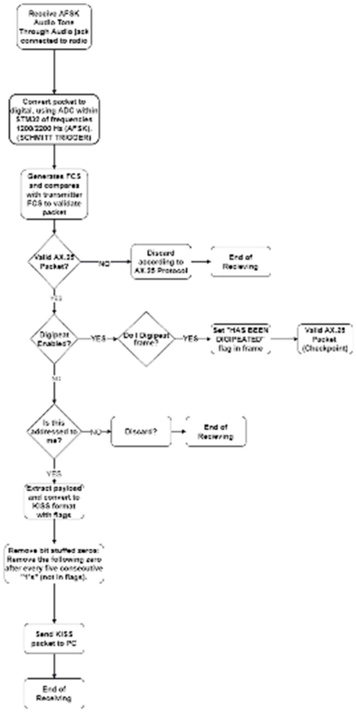
[picture p166: figure]
