MrLordLeon/TNCMCU/Design Deliverables (Paper Revisions)/Weekly Status Report/David/Design 1/Weekly Status Report 2.pdf

# Weekly Status Report

# Week 2

### EECE 443

### MCU TNC Design

### David Cain

C00043561

### Submittal Date: March 3

rd
, 2020

Accomplished tasks for this week:
- Review information about the AX.25 Protocol
- Review information about the KISS Protocol
- Create BOM of parts needed to submit to mentors
- Create PowerPoint for Assignment 1A
- Aid team in creating flow diagram for transmission and receiving of packets using the AX.25 protocol

Planned tasks for next week:
- Since the mentors have our BOM we should receive the dev boards to begin coding
- Review the flow chart with mentors to ensure we are accurately describing the flow of data for XMSN
- Review STM32 tutorials available on CAPE4 GitHub repo

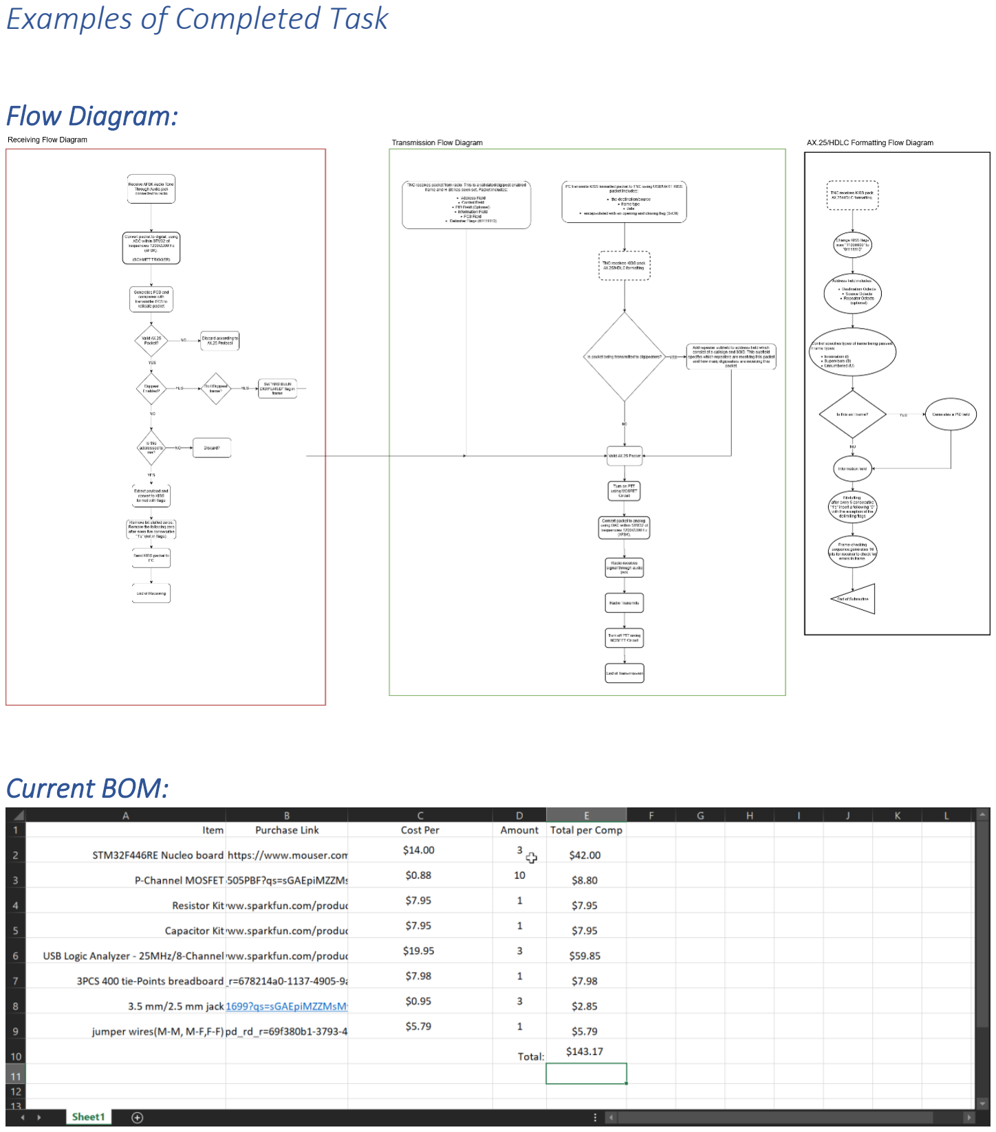
[picture p170: page 3]

Examples of Completed Task

Flow Diagram:

Current BOM:

Time Sheet

Item | Date/Time | Description | Hours
1 | 2/24/2020 10am-1:30pm | Beginning to put together a data flow chart for the AX.25/KISS protocol | 3.5
2 | 2/26/2020 8pm-9:30pm | Finish flow chart with Kaleb | 1.5
3 | 3/3/2020 6am-7am | Create BOM to present to mentors to get ahold of components | 1
Total: | | | 6
