MrLordLeon/TNCMCU/Design Deliverables (Paper Revisions)/Weekly Status Report/David/Design 1/Weekly Status Report 8.pdf

# Weekly Status Report

# Week 8

### EECE 443

### MCU TNC Design

### David Cain

C00043561

### Submittal Date: April 23rd

, 2020

Accomplished tasks for this week:
- Corrected Appendix F for schematic issues.
- Created Level 1 Design Diagram to further display the internal schematics for out design.
- Got DAC code to generate 2 audio frequencies.
- Structured GitHub for more software development moving forward.

Planned tasks for next week:
- Get fully functioning code to read a bitstream array and generate the corresponding audio.
- Begin working on code to interpret KISS packets and setting associated flags for transmission.

Examples of Completed Task

Sample of DAC Code:

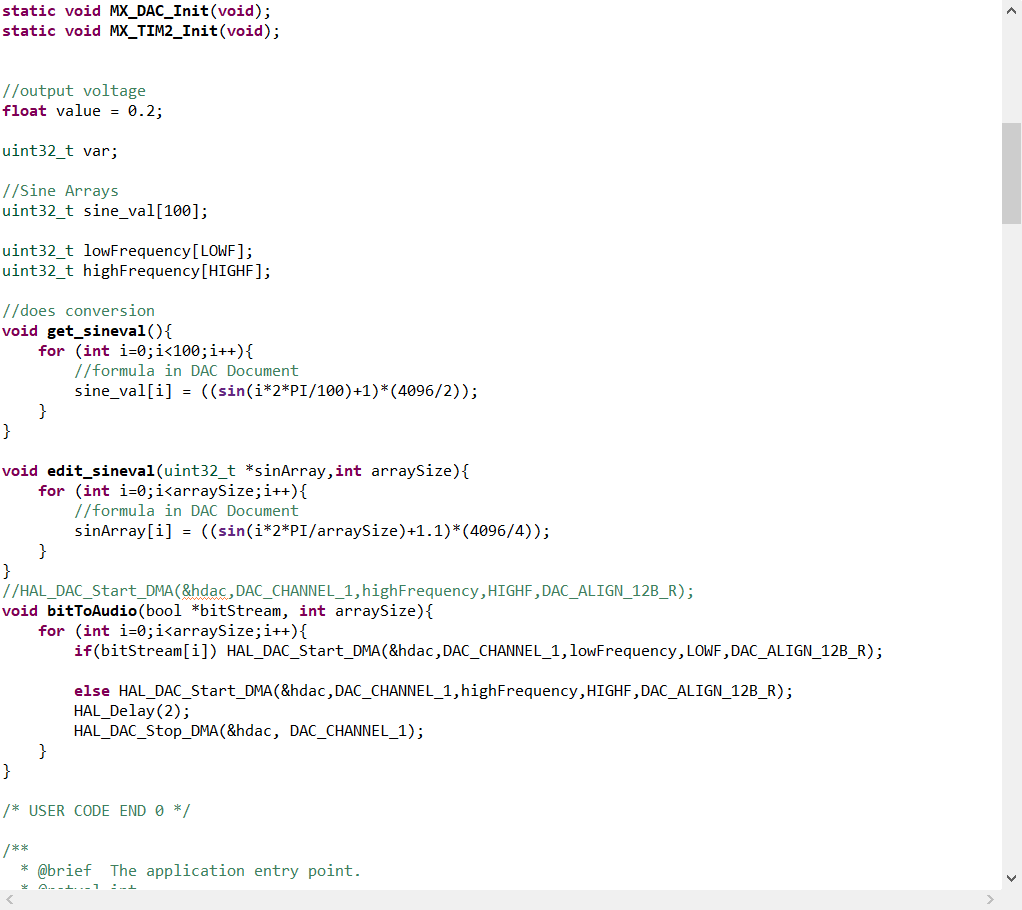
[picture p175: figure]

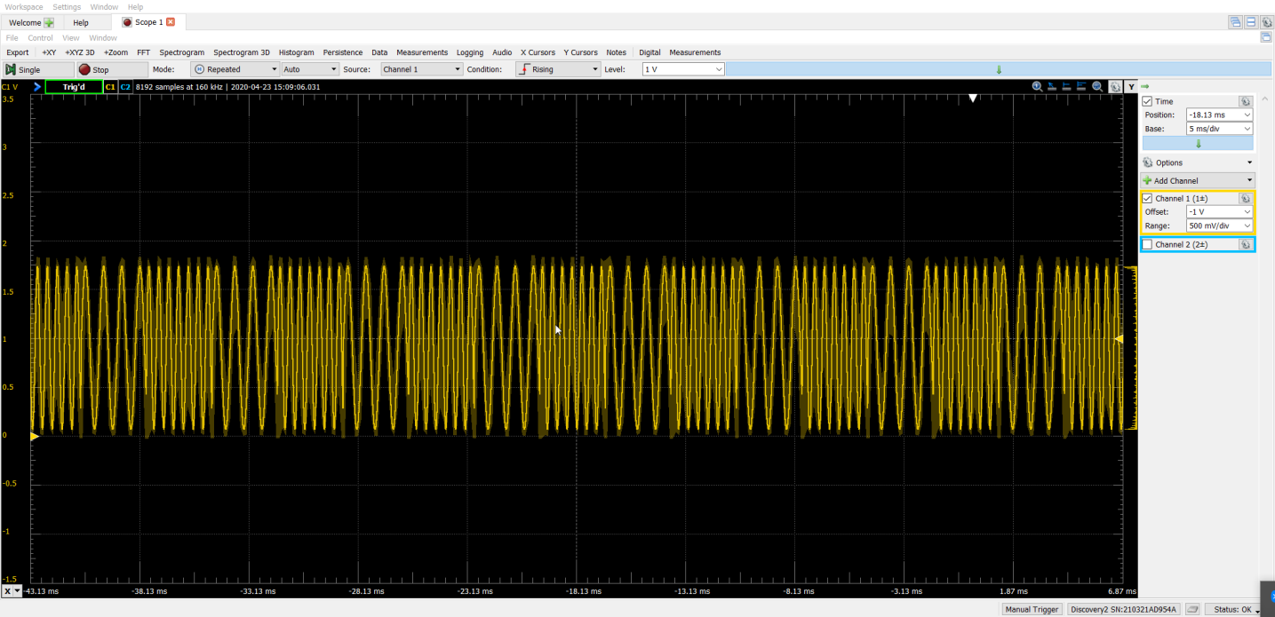
[picture p176: figure]

AFSK Output of {1,0,1,0….1,0}:

Time Sheet

Item | Date/Time | Description | Hours
1 | 4/18/2020 6:16pm-12:44am | Spent a while getting the DAC code written. Was struggling with pointer arrays within C. Created a formula for generating a sine wave based on variable sample rates. | 5.88
2 | 4/19/2020 10:50 pm-12:32am | Wrote appendix sections for assignment 3 and created the design 1 diagram. | 1.70
3 | 4/21/2020 6:10pm-11:32pm | Worked on assignment 3 with team member then began the presentations to be submitted on Sunday. | 5.36
Total: | | | 12.94
