MrLordLeon/TNCMCU/Design Deliverables (Paper Revisions)/Weekly Status Report/David/Design 2/Weekly Status Report 1.pdf

# Weekly Status Report

# Week 1

### EECE 443

### MCU TNC Design

### David Cain

C00043561

### Submittal Date: September 21st

, 2020

Accomplished tasks for this week:
- Create reference experiment document
- Create code to read bits from incoming bitstream of data
- Create code to receive packets of AX.25 and store them into a buffer
- Create code to generate and output an AFSK signal by incrementing through a Boolean array
- Ordered prototyping boards for creating our circuits to connect to the TNC

Planned tasks for next week:
- Fix the AFSK generation code due to phase errors in wave shape
- Run thorough testing on code subsystems and record results with the newly created experimenting sheet
- Flesh out more of the AX.25 protocol interpretation
- Pass Kobe some of the perfboards so he can build the input circuit and PTT circuit

Examples of Completed Task
Example of some code to read in bitstreams:

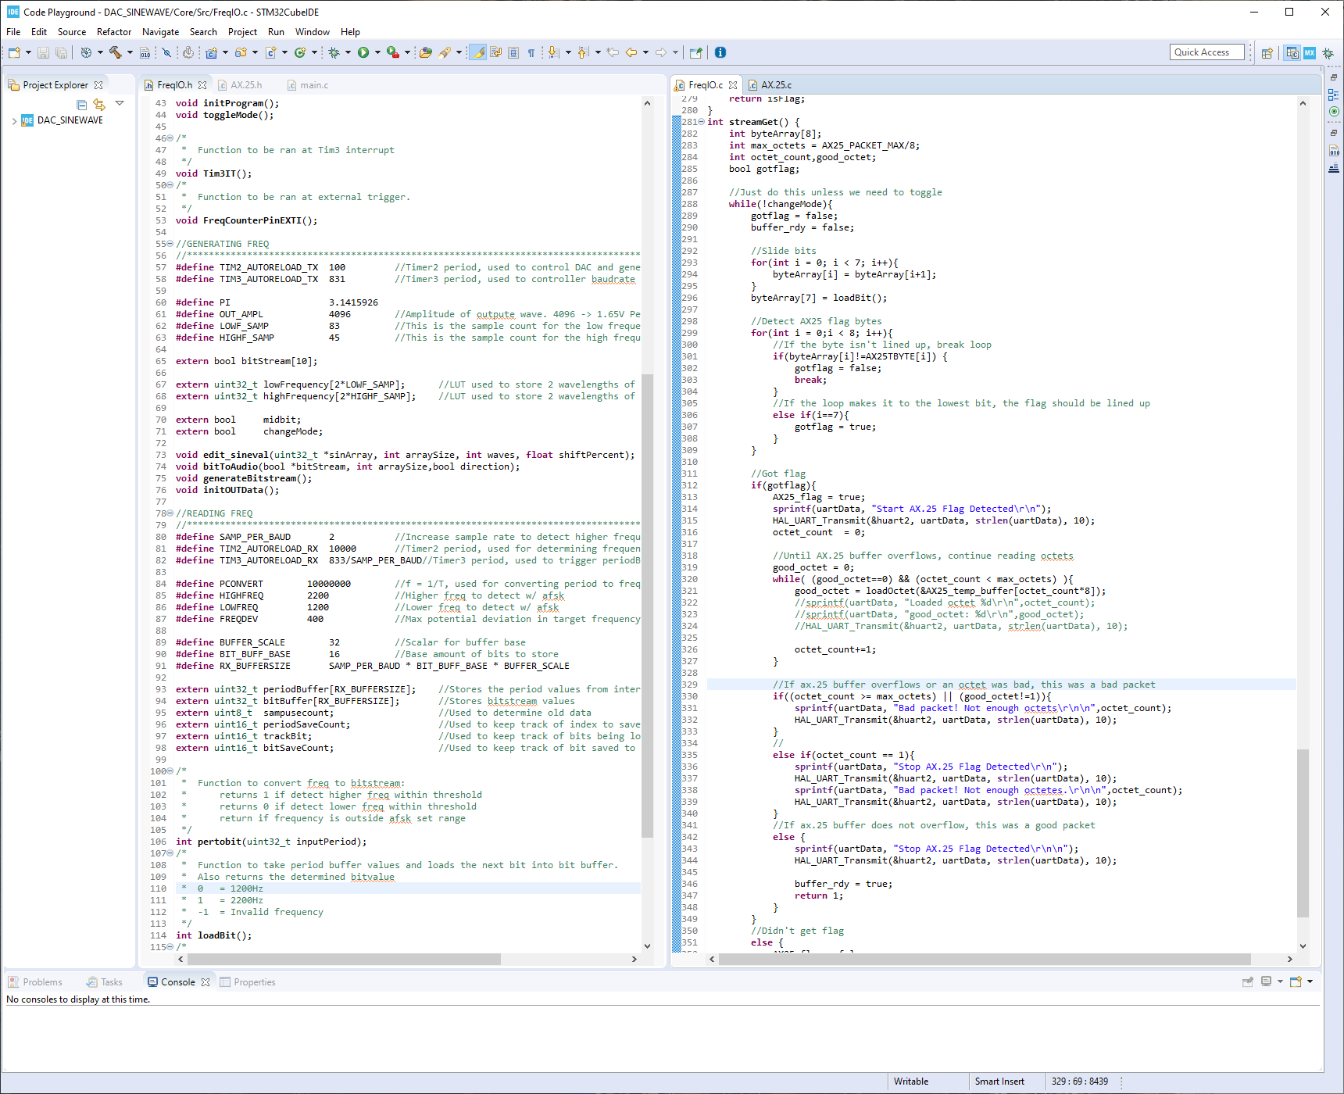
[picture p177: figure]

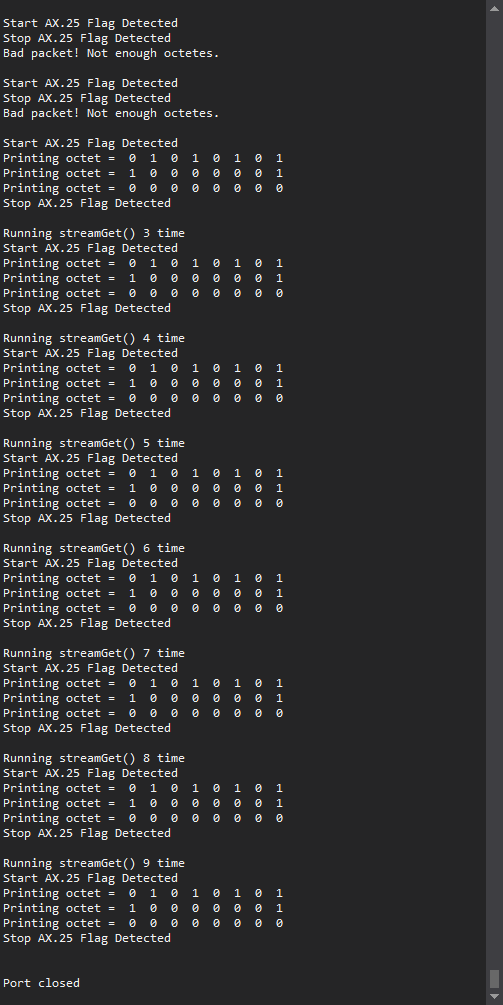
[picture p178: figure]

Serial Output from controller reading an incoming bitstream:

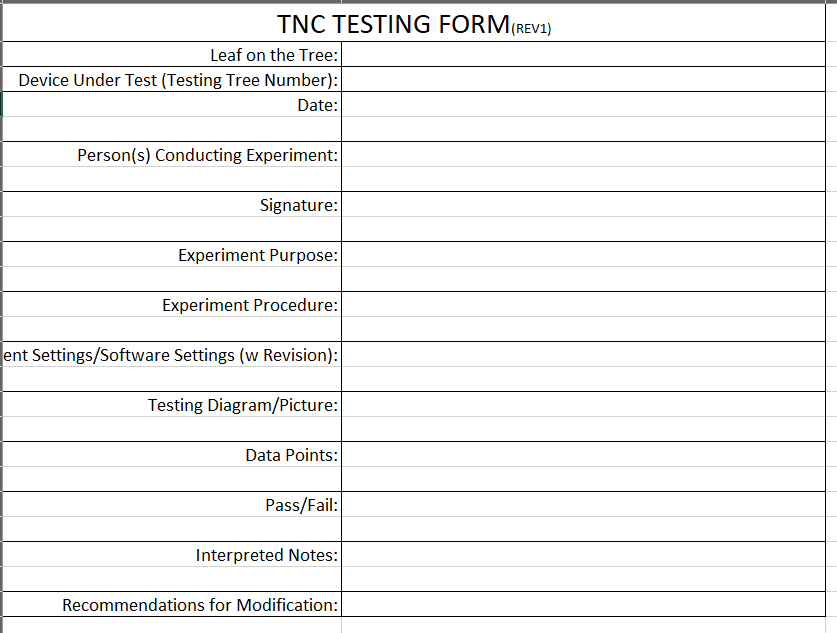
[picture p179: figure]

Experiment Sheet:

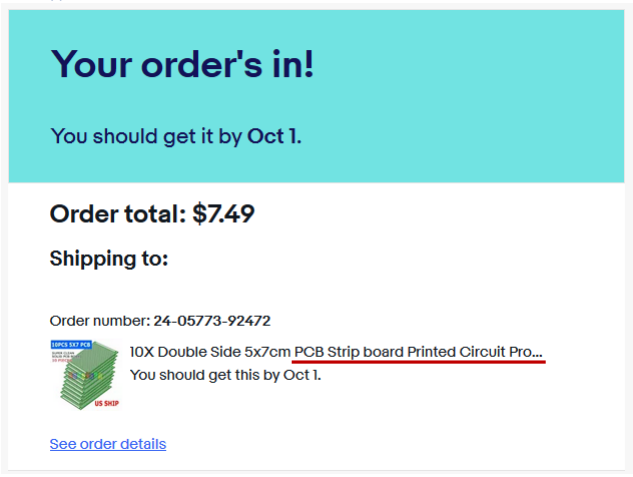
[picture p180: figure]

Prototype Board Order Form:

Time Sheet

Item | Date/Time | Description | Hours
1 | 9/14/2020 5:30pm-7pm | Begin creating experiment sheet by overlooking sheet provided by Dr. Darby. | 1.5
2 | 9/14/2020 3:30pm-6pm | Use pre-written bitLoading operation to create function for converting an AFSK digital bitstream based on AX.25 flag detection. | 2.5
3 | 9/16/2020 5:30-7pm | Using the previous digital bitstream conversion software, implement functional logic to create an AX.25 packet. | 1.5
4 | 2/16/2020 12pm-3pm | Create software to output an AFSK bitstream. This was done by storing the bitstream as an array of Booleans and instruct the DAC to output a sine. | 3
5 | 2/17/2020 12pm-1pm | Spend a bit of time looking for good prototyping boards to assemble the circuits on and connect to our microcontroller. | 1
Total: | | | 8.5
