MrLordLeon/TNCMCU/Design Deliverables (Paper Revisions)/Weekly Status Report/David/Design 2/Weekly Status Report 2.pdf

# Weekly Status Report

# Week 2

### EECE 460

### MCU TNC Design

### David Cain

C00043561

### Submittal Date: September 28

th
, 2020

Accomplished tasks for this week:
- Sent BOM to mentors for parts needed to complete prototype board
- Received perfboards
- Scheduled time to pick up components from mentors
- Created more AX.25 handling functions in the code base
- Specifically spent some time removing global variables and implementing structs to hold data that we need to access

Planned tasks for next week:
- Fix the AFSK generation code due to phase errors in wave shape
- Flesh out more of the AX.25 protocol interpretation
- Run experimentation on lower level code to help with documentation
- Flesh out more of the AX.25 protocol interpretation

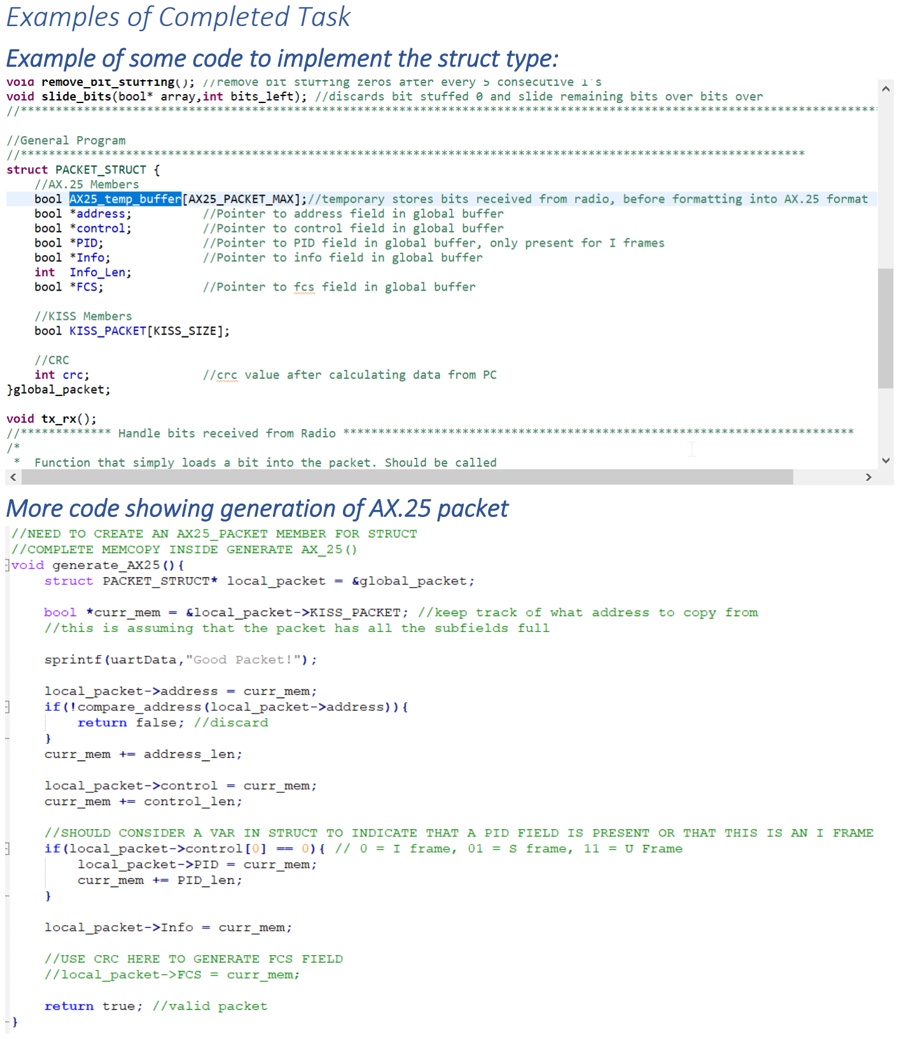
[picture p181: page 3]

Examples of Completed Task
Example of some code to implement the struct type:

More code showing generation of AX.25 packet

Experiment Sheet:

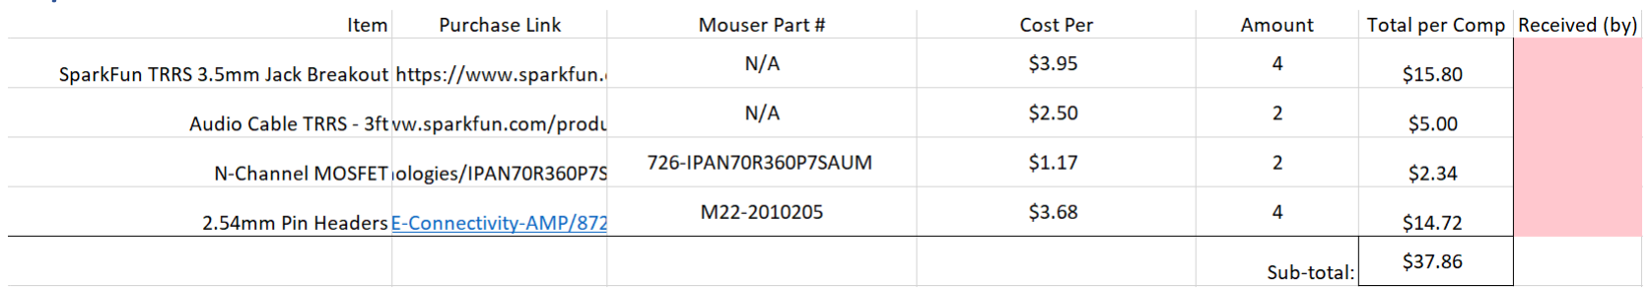
[picture p182: figure]

Prototype Board Order Form:

Time Sheet

Item | Date/Time | Description | Hours
1 | 9/21/2020 5:30pm-7pm | Create BOM for prototyping components with Kobe and then send to Nolan | 1.5
2 | 9/22/2020 3:30pm-6pm | Worked on AX.25 handling code, implementing struct | 2.5
3 | 9/23/2020 5:30-7pm | Worked on AX.25 handling code, added some packet logic based on frame received types | 1.5
5 | 2/25/2020 12pm-12:30pm | Retrieved perfboard from campus | 0.5
Total: | | | 6
