MrLordLeon/TNCMCU/Design Deliverables (Paper Revisions)/Weekly Status Report/David/Design 2/Weekly Status Report 3.pdf

# Weekly Status Report

# Week 3

## EECE 460

## MCU TNC Design

## David Cain

C00043561

## Submittal Date: October 5th

, 2020

## Accomplished tasks for this week:

### - Completed testing of baud rate on the testing tree - Completed testing of amplitude on the testing tree - Helped Kobe with assembling the prototyping boards

## Planned tasks for next week:

### - Finish the rest of the prototyping board - Add more packet functionality to the code - Complete more of the testing tree - Analyze waveform output of the newly assembled prototype boards

## Examples of Completed Task

### Testing tree form for amplitude:

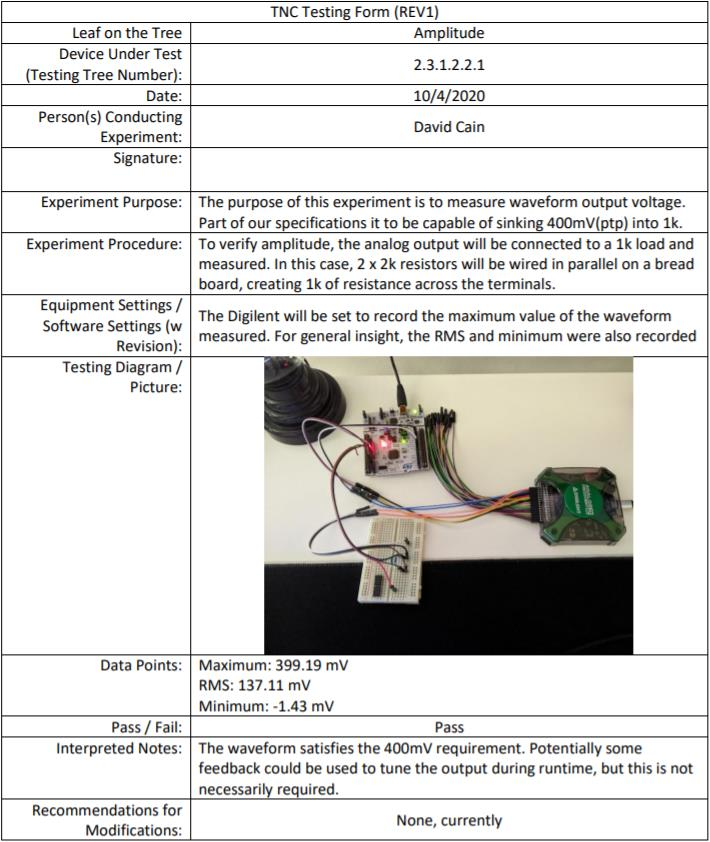
[picture p183: figure]

### Testing Tree for baud rate:

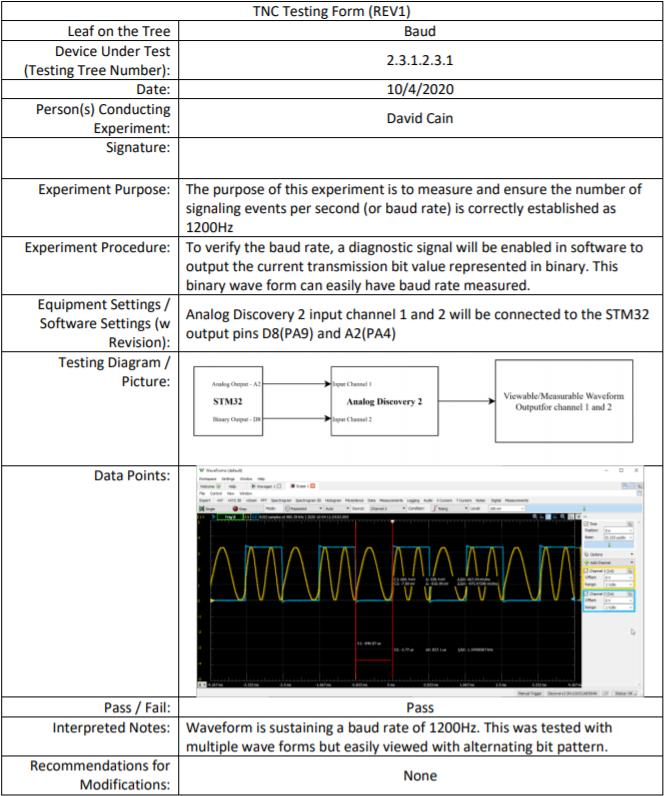
[picture p184: figure]

### Example code with more pointer structure:

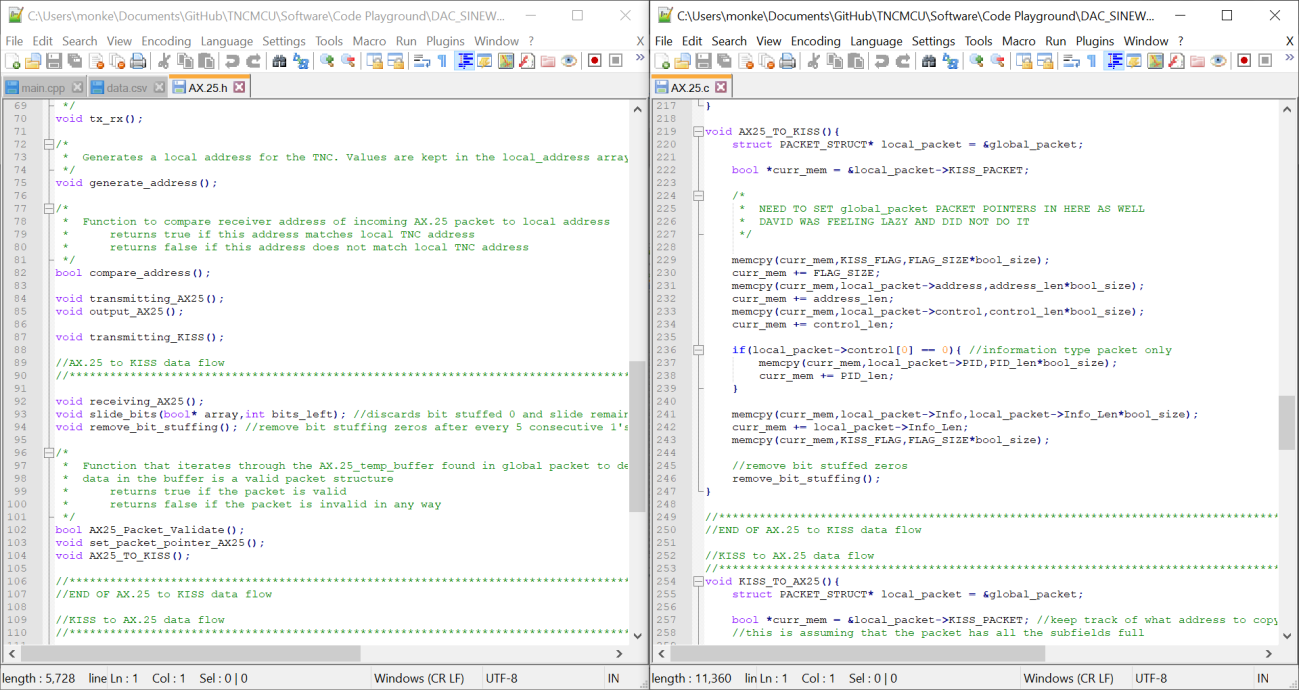
[picture p185: figure]

### Prototype Assembly with Kobe:

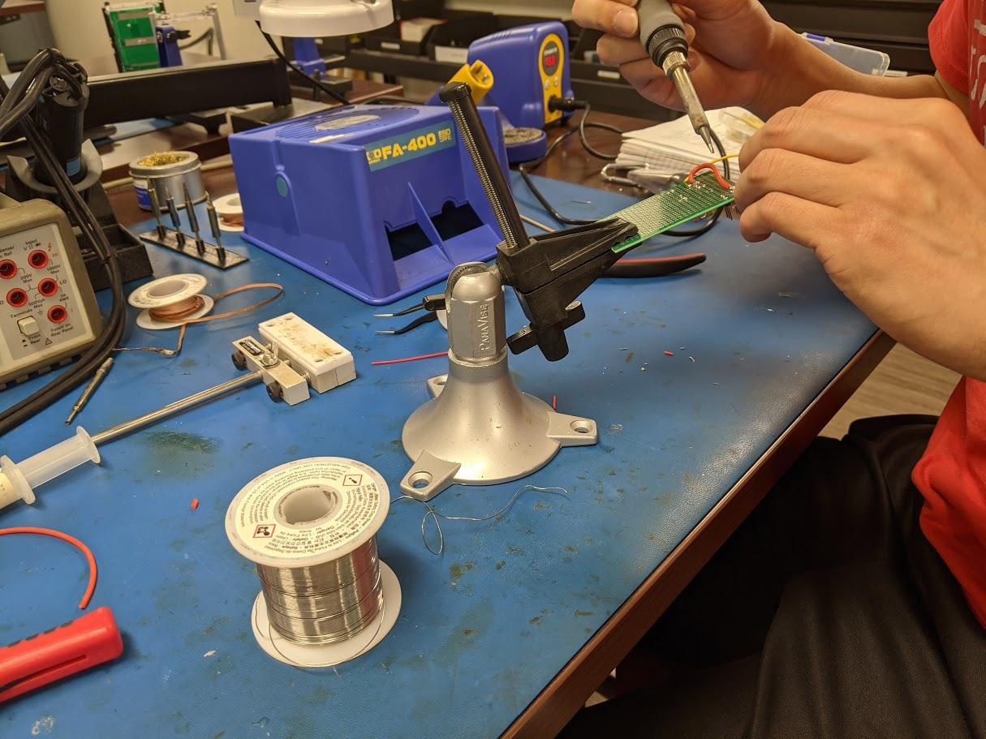
[picture p186: figure]

## Time Sheet

Item | Date/Time | Description | Hours
1 | 9/28/2020 5:30pm-6pm | Edited our old testing sheet to new be in word format. The previous version was okay but did not integrate into papers well. | 0.5
2 | 9/30/2020 3:30pm-6pm | Completed testing for amplitude output of TNC. Needed to test the output with a load of 1k so I needed a simple resistor circuit. | 2.5
3 | 10/1/2020 5:30-7pm | Completed testing for the baud rate output of TNC. Used the Digilent to measure waveform. | 1.5
5 | 10/3/2020 12pm-6:30pm | Worked on packet structure code. | 6.5
Total: | | | 11
