MrLordLeon/TNCMCU/Design Deliverables (Paper Revisions)/Weekly Status Report/Kobe/Design 1 Status Report 7.docx

Weekly Status Report

Report 7

EECE 444

TNC MCU Project Design

Kobe Keopraseuth

C00092349

Thursday, April 9, 2020

Work and accomplishments this week

- Assignment 3
- Timeslots for presentation

Planned Activities for Next Week

- Assignment 3

Time Sheet

Item | Date/Time | Description | Hours
1 | 4/6/2020 3pm-8pm | Assignment 3 | 5
2 | 4/8/2020 2pm-2:30pm | Timeslots for presentations | .5
| | Total: | 5.5

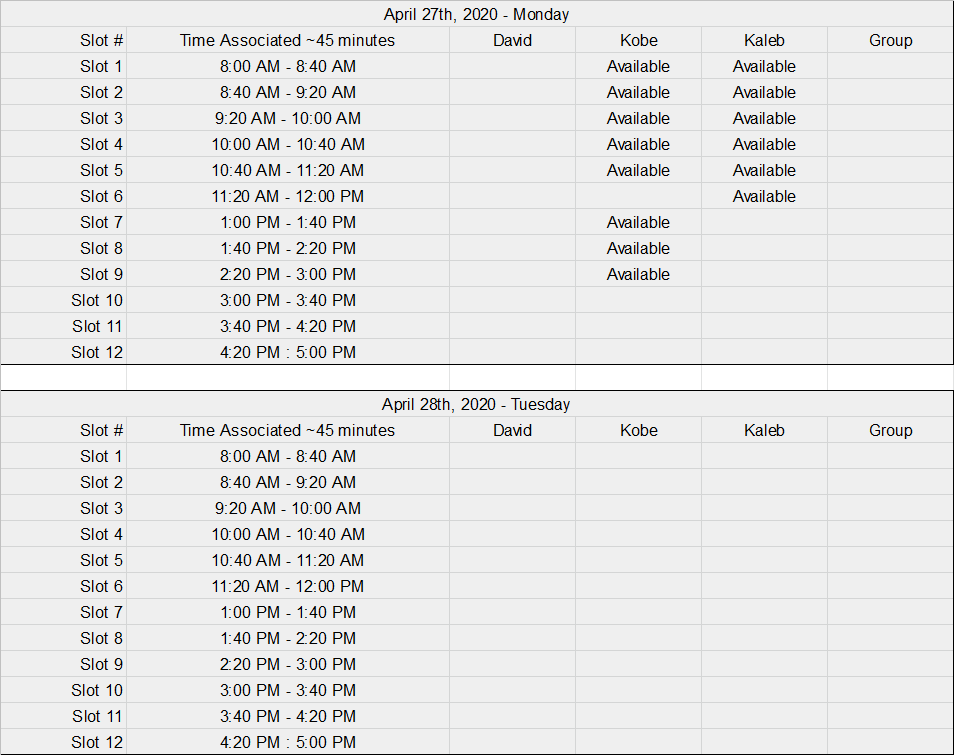
[picture p201: figure]
