MrLordLeon/TNCMCU/Presentations/9_28_20 Deliverable 3 Presentation.pptx

## MCU TNC Deliverable 3

David Cain, Kobe Keopraseuth, and Kaleb Leon

## Testing Tree at High Level

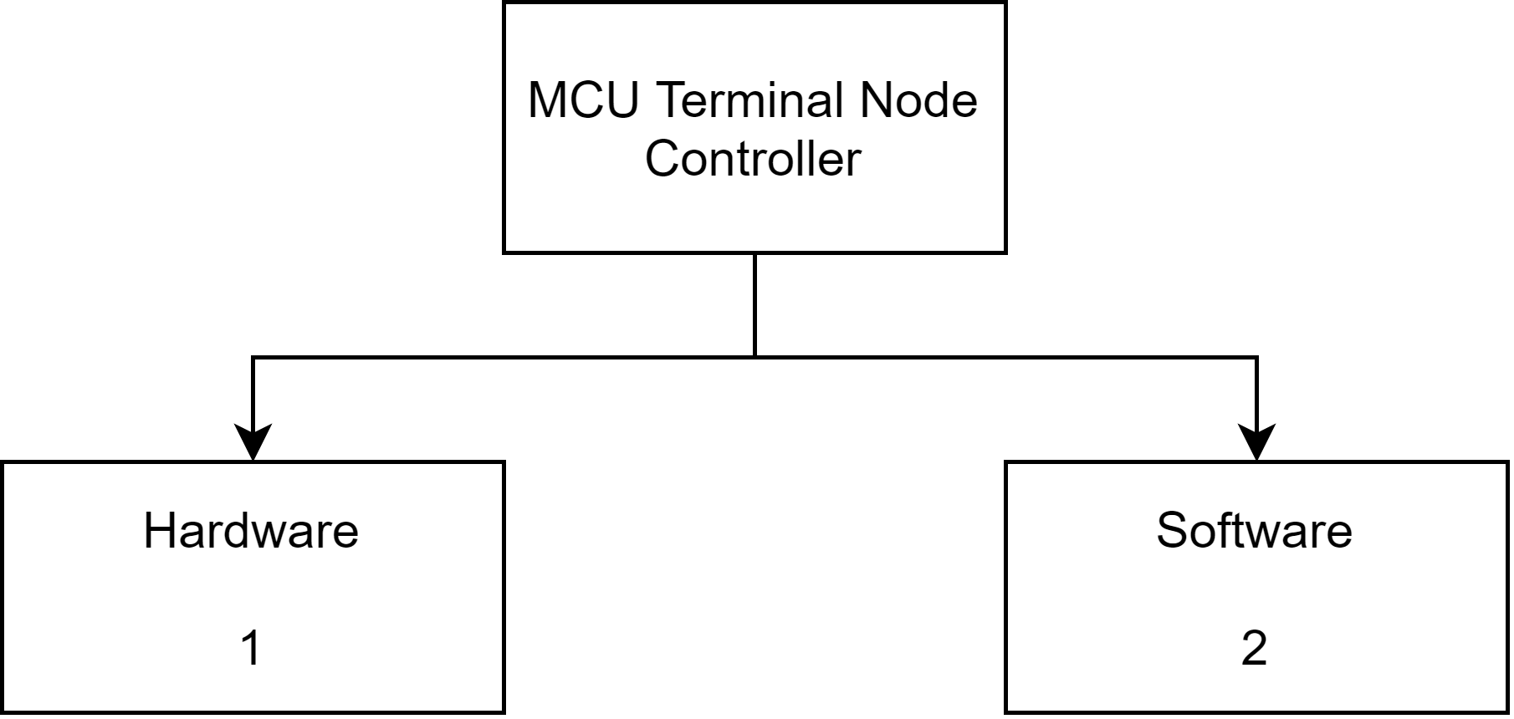
[picture p204: figure]

## Hardware Testing Tree

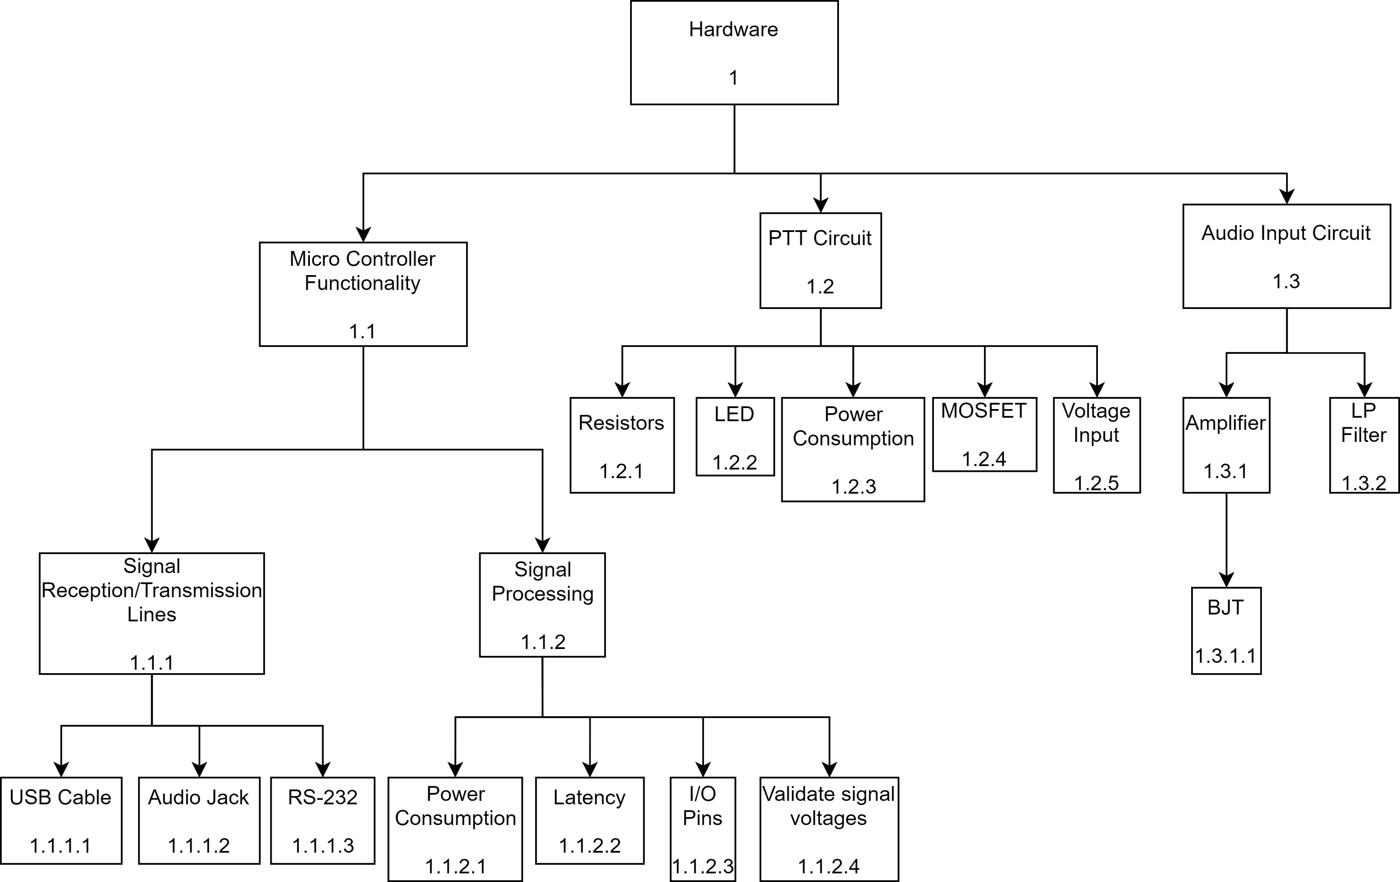
[picture p205: figure]

## Software Testing Tree

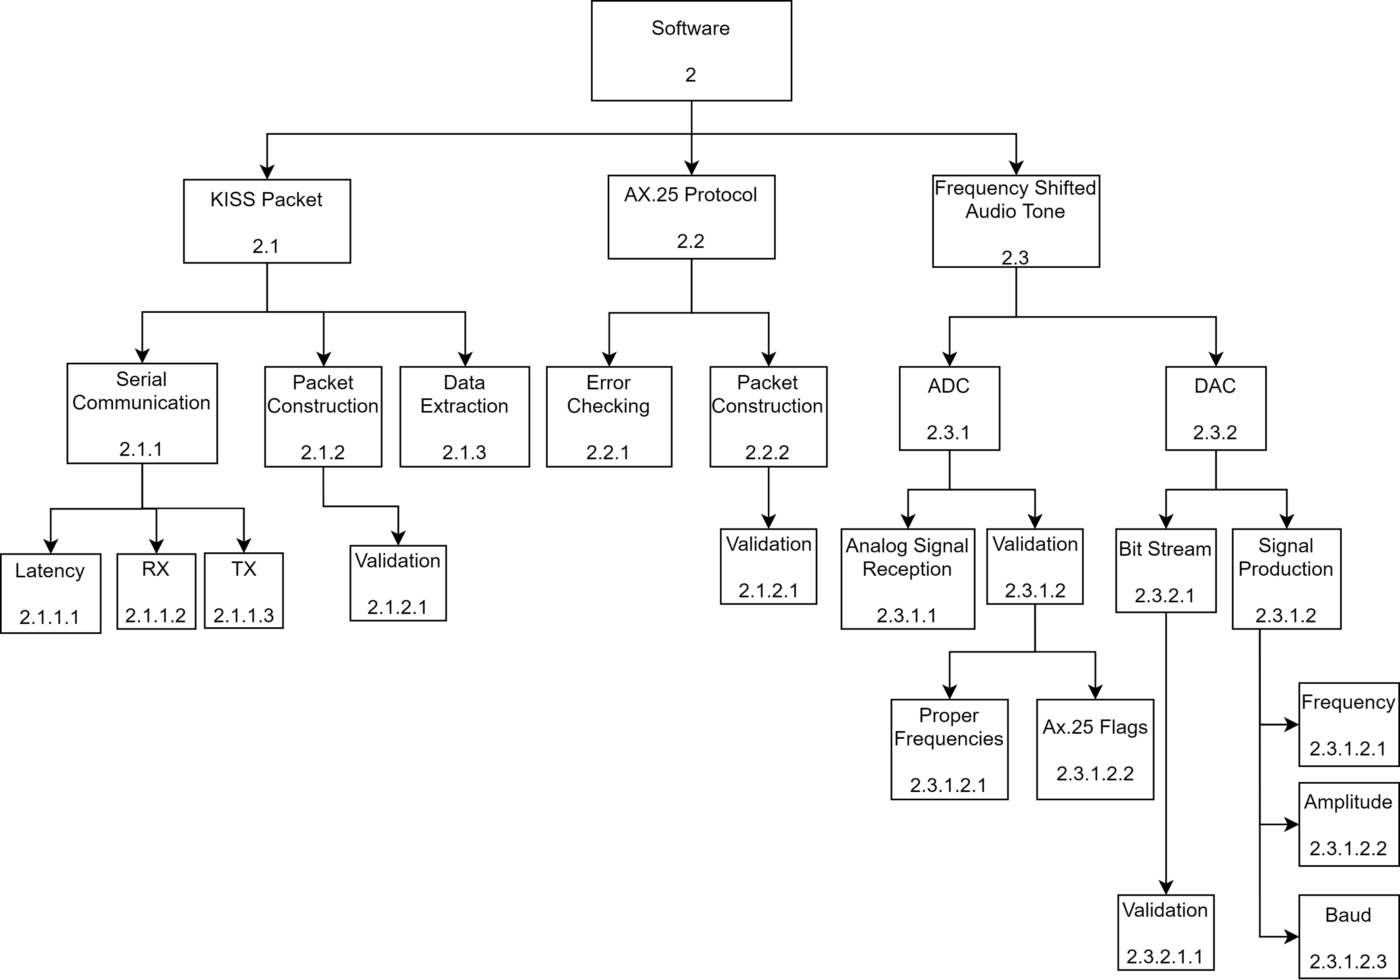
[picture p206: figure]
