MrLordLeon/TNCMCU/Presentations/EECE460 Design 2 Final Presentation - Team 2 - MCUTNC.pdf

# MCU TNC Design

David Cain, Kobe Keopraseuth, and Kaleb Leon Design 2 - Final Presentation

# Project Overview

- What is a TNC?
- A modem for connecting a computer with a HAM radio
- KISS
- AX.25

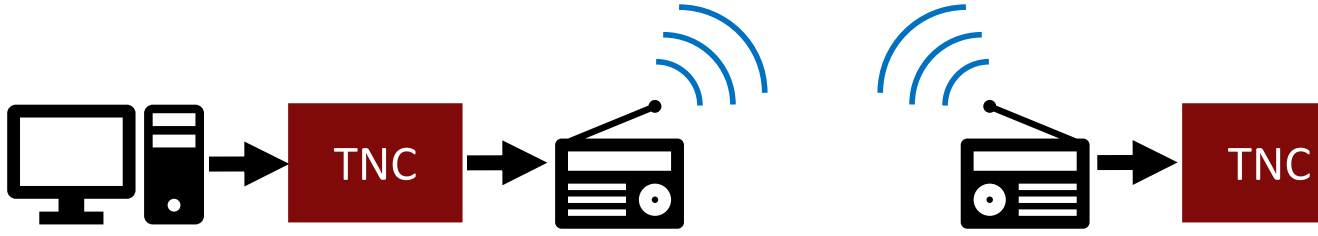
[picture p210: figure]
TNC
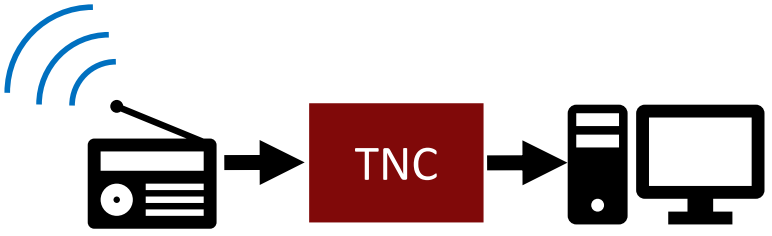
[picture p211: figure]

# Why every HAMer needs our TNC

VS

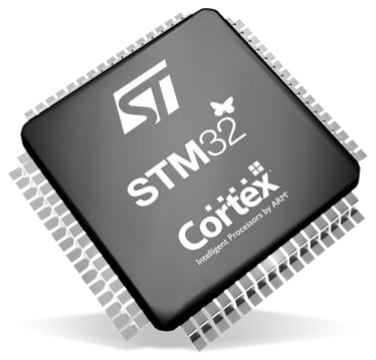
[picture p212: figure]

Our Solution

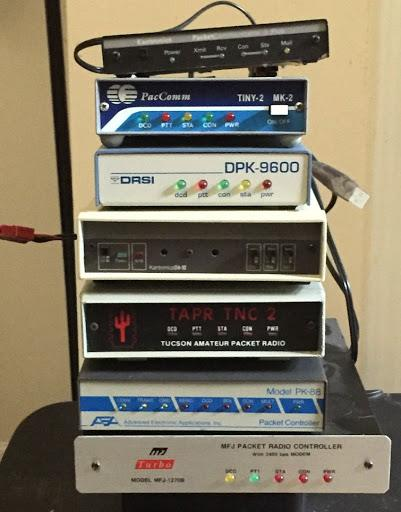
[picture p213: figure]

Commonly Used Hardware TNCs

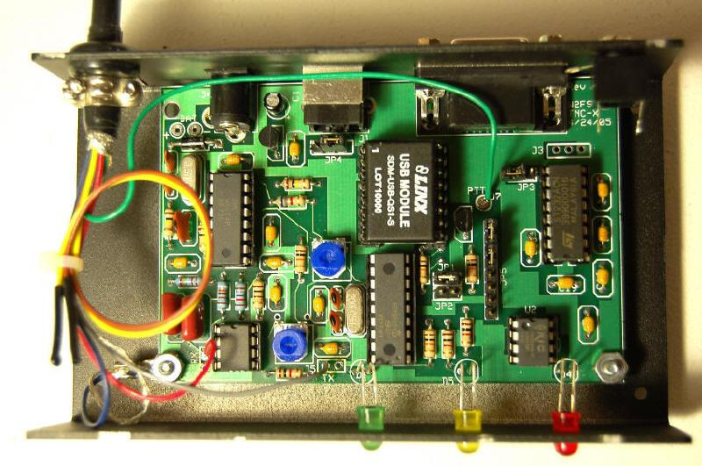
[picture p214: figure]

- Modular/Adaptable
- Open Source
- Easy to replicate
- Small form factor
- Well Documented
- Increase computational capability
- Cheap

## MCU TNC Benefits

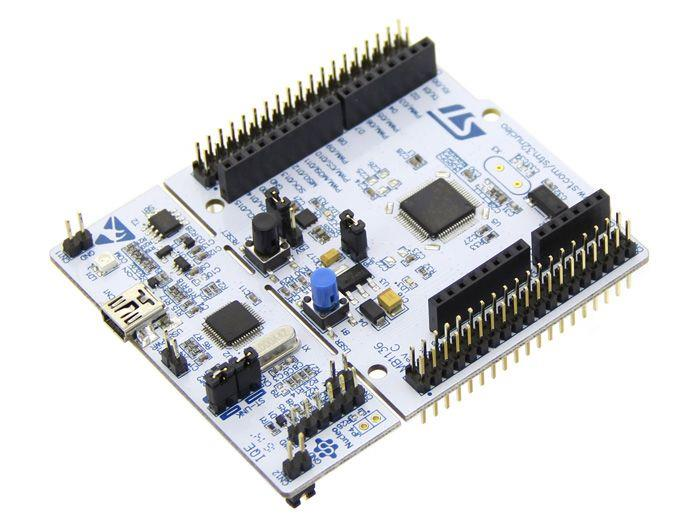
[picture p215: figure]

## Design Specifications

Scope of Work:
Design, implement, build, and test a TNC with an STM32 or similar microcontroller. The system must accept a string via UART or a similar interface and generate the necessary HDLC headers/packet data and then produce the correct audio waveform.

# Methodology

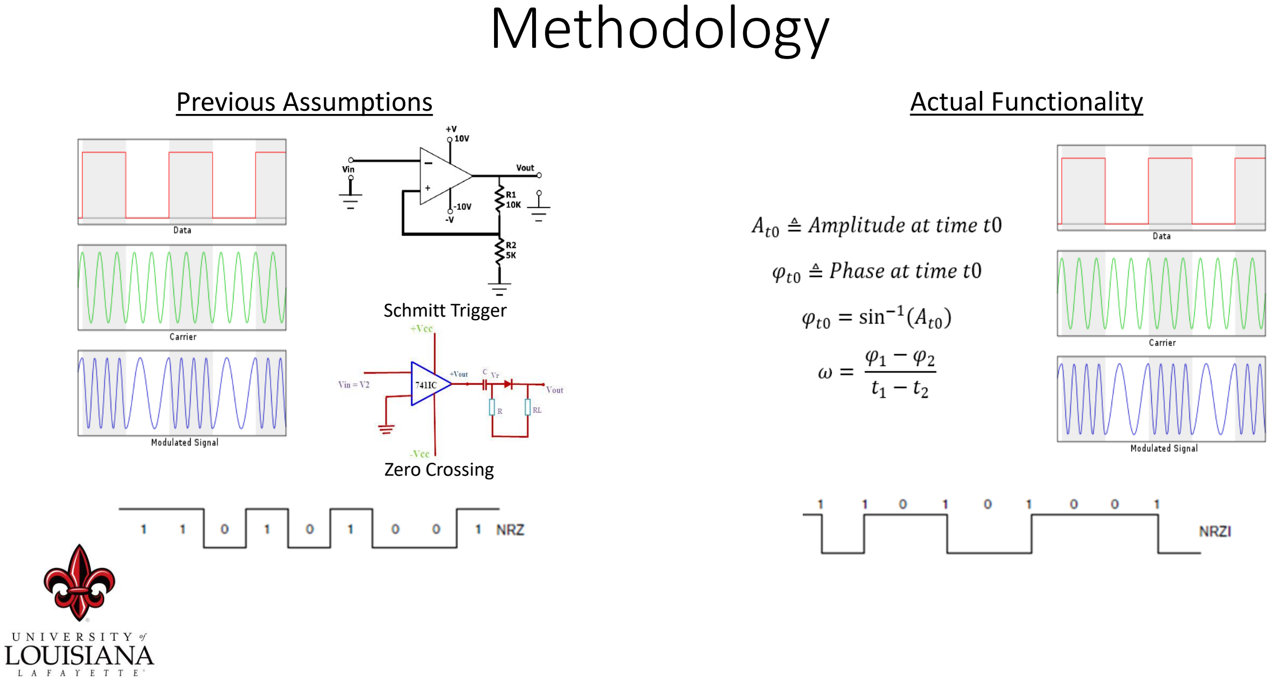
[picture p216: page 6]

Previous Assumptions | Actual Functionality

Schmitt Trigger

Zero Crossing

# Testing and Validation

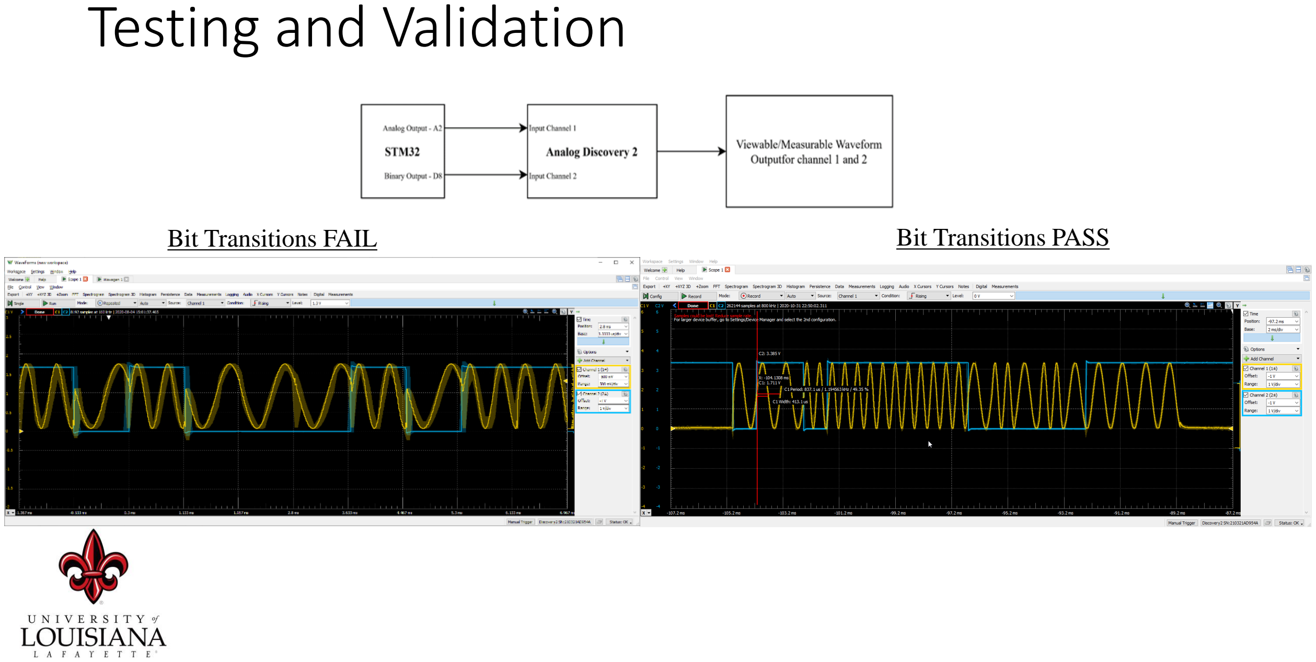
[picture p217: page 7]

Bit Transitions FAIL | Bit Transitions PASS

## Packet Generation

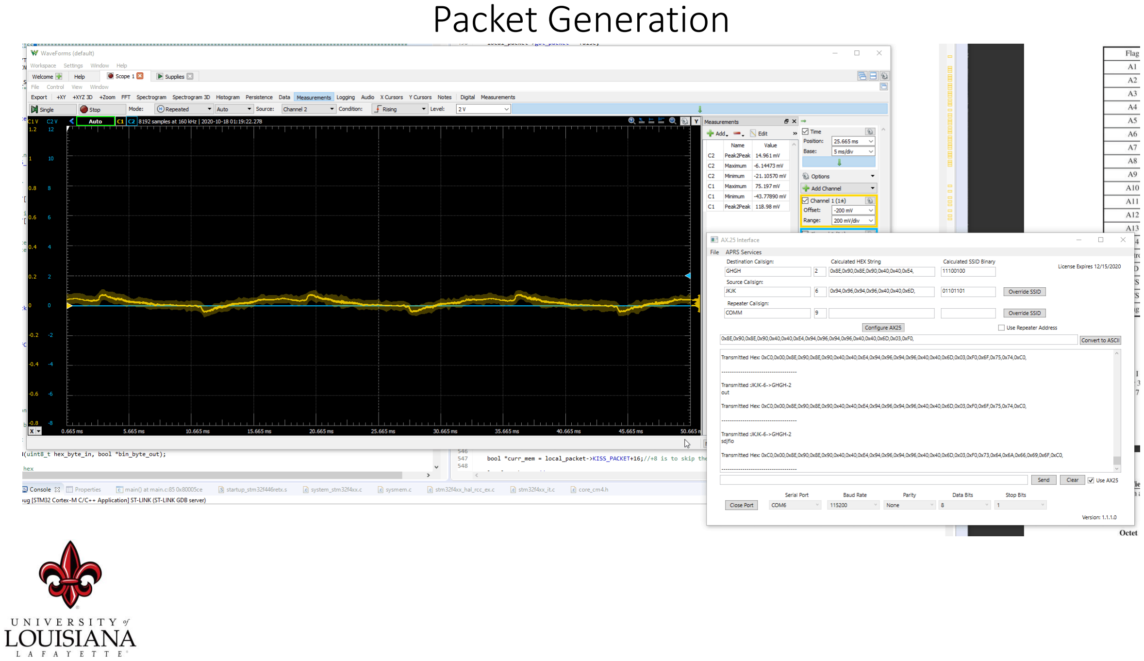
[picture p218: page 8]
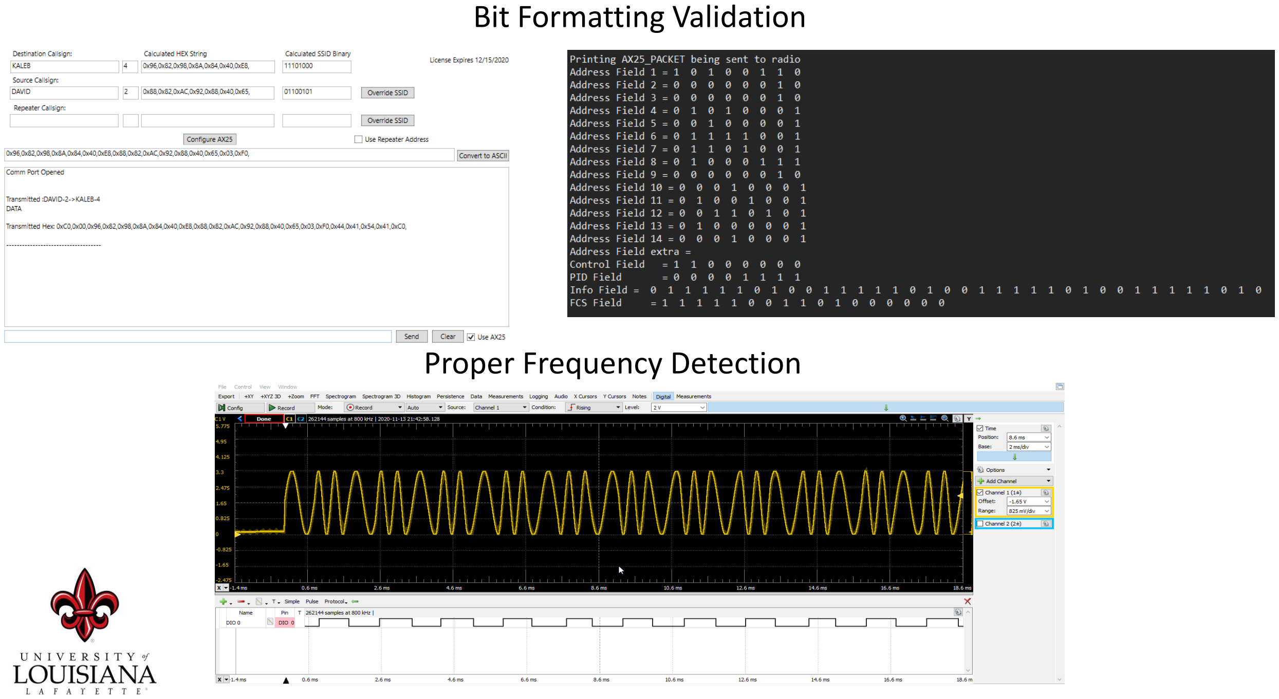
[picture p219: page 9]

Bit Formatting Validation

Proper Frequency Detection

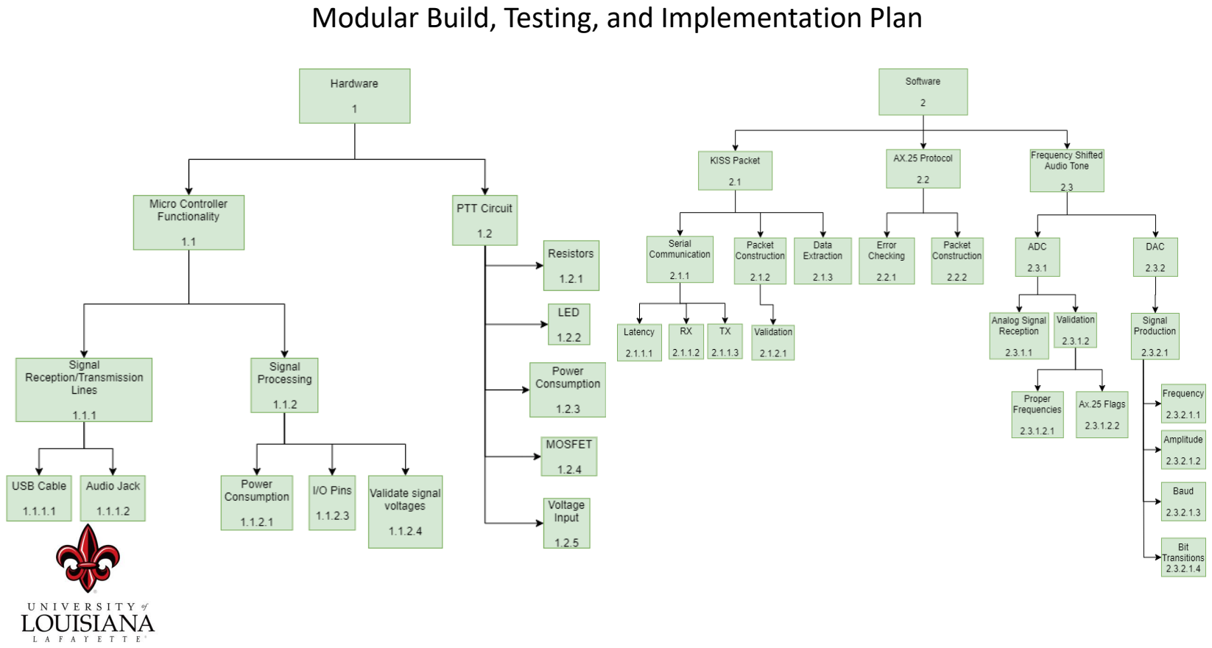
[picture p220: page 10]

Modular Build, Testing, and Implementation Plan

# Design Modifications

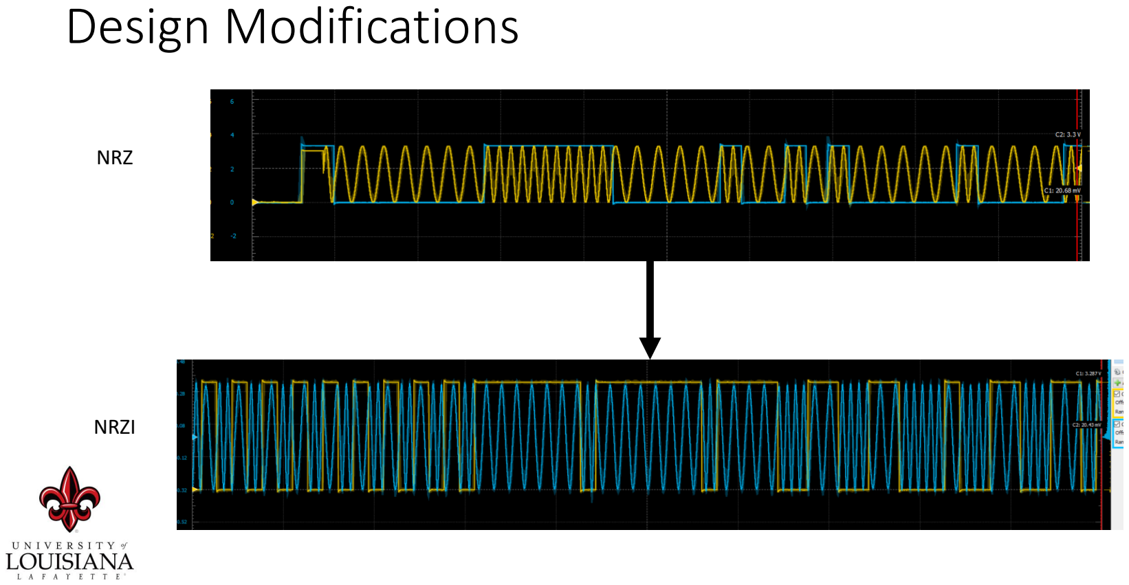
[picture p221: page 11]

NRZ

NRZI

# As Built Design

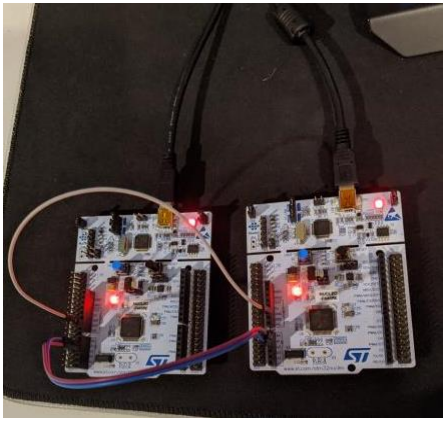
[picture p222: figure]

# Final Demo

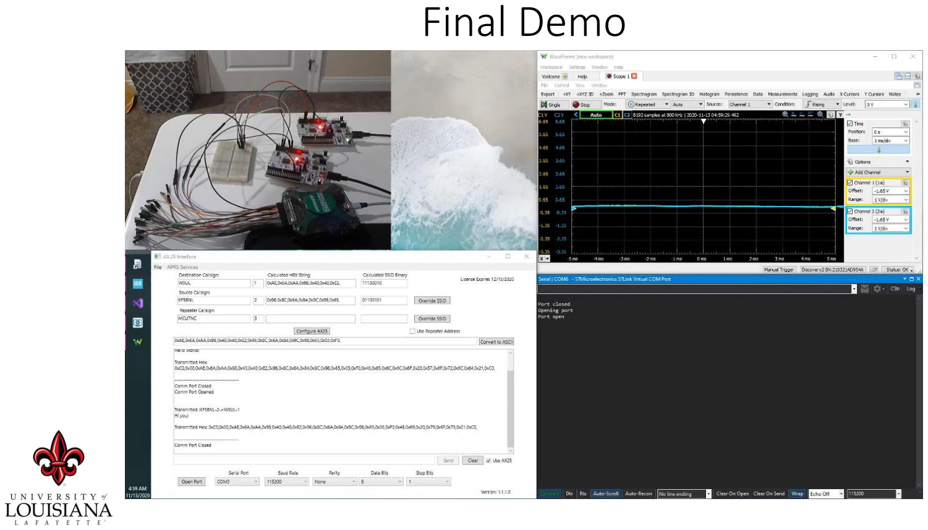
[picture p223: page 13]

# Significance

Future Work

- APRS - an amateur radio-based system for real time digital communications of information of immediate value in the local area. Data can include object Global Positioning System (GPS) coordinates, weather station telemetry, text messages, etc..
- Distinguish between different types of packets
- Sending and receiving signals over radio

Lessons Learned
- Document Thoroughly
- Cannot trust just one resource
- There is no easy way
- One change can cause many changes in your design
- Plan ahead for life inconveniences

# Acknowledgements

Project Mentors

Nolan Edwards
Rizwan Merchant
James Palmer
Nick Pugh

Special Thanks

Pelican Engineering

# Questions?

[1] What is the Baud Rate?
1200
[2] How are we detecting the frequencies?
Basing it off of change in phases over time where we can obtain the phases by performing inverse sine on amplitudes of the signal using the ADC.
[3] How would a normal user interface with your TNC?
Through a dumb terminal that sends KISS packets over UART.
[4] What does KISS stand for?
Keep It Simple, Stupid

# General Information

# Why is our project relevant?

- Cost affective
oBasic cost of a micro controller
- Modular
- Code is easily adaptable to add more functionality
- Easy to replicate and repair
oGrab code off the GitHub and upload to controller
- Well documented
oCompared to many other TNCs and info about them, ours is very open source
