MrLordLeon/TNCMCU/Design Deliverables (Paper Revisions)/Weekly Status Report/David/Design 1/Weekly Status Report 6.pdf

# Weekly Status Report

# Week 6

## EECE 443

## MCU TNC Design

## David Cain

C00043561

## Submittal Date: April 2

nd
, 2020

## Accomplished tasks for this week:

### - Created OSI Model for documentation - Found programs to generate KISS packets - Began writing software that intakes data via UART

## Planned tasks for next week:

### - Further develop software to begin receiving KISS packets - Become more comfortable with the development software involved

## Examples of Completed Task

### Screenshot of KISS Packet Program (Packet Engine Pro):

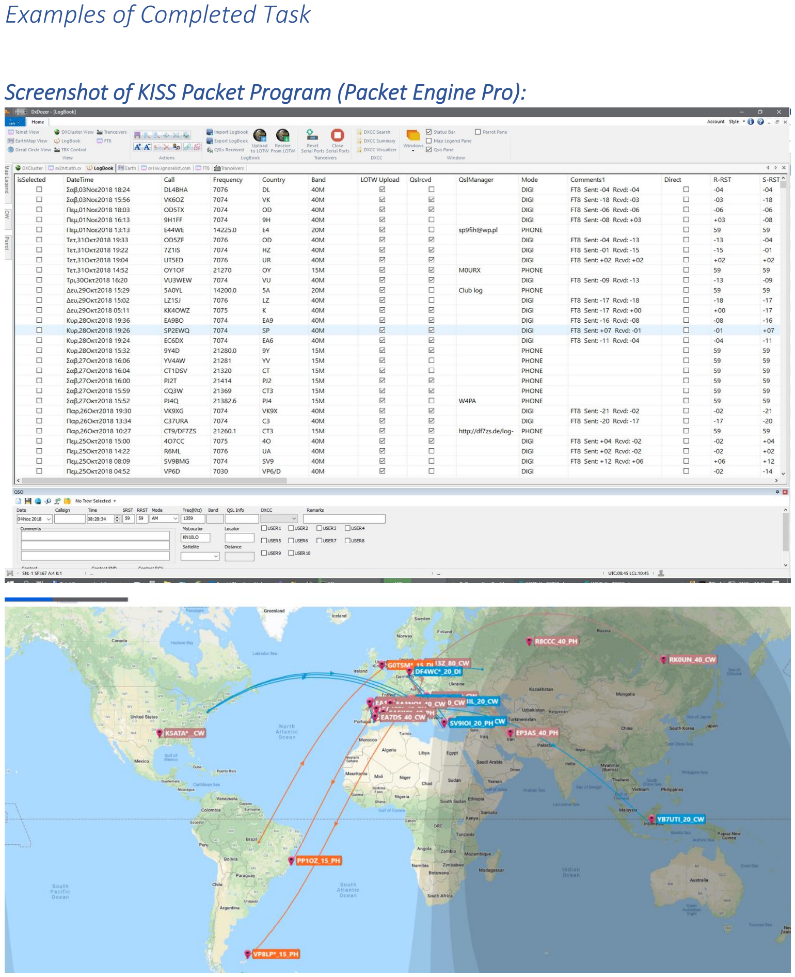
[picture p224: page 3]

## Time Sheet

Item | Date/Time | Description | Hours
1 | 3/28/2020 5pm-7pm | Spent some time trying to find a packet program. Ended up finding something called packet engine pro that should do the job for us. | 2
2 | 4/1/2020 6:57pm-9:50pm | Worked on assignment 2B/2C with group members. For this session, Kobe and I came up with the OSI model shown in our paper. We also put together the presentations | 2.88
Total: | | | 4.88
