MrLordLeon/TNCMCU/Schematic/EAGLE/MCUTNC/AUDIOCircuit.png

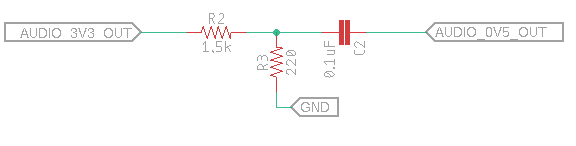
Schematic/EAGLE/MCUTNC/AUDIOCircuit.png
