MrLordLeon/TNCMCU/Schematic/EAGLE/MCUTNC/PTTCircuit.png

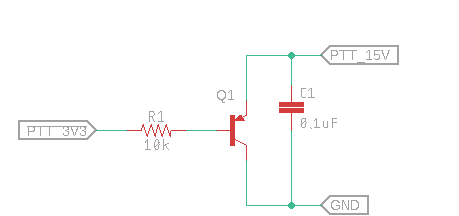
Schematic/EAGLE/MCUTNC/PTTCircuit.png
