MrLordLeon/TNCMCU/Schematic/EAGLE/MCUTNC/TNCMCU.png

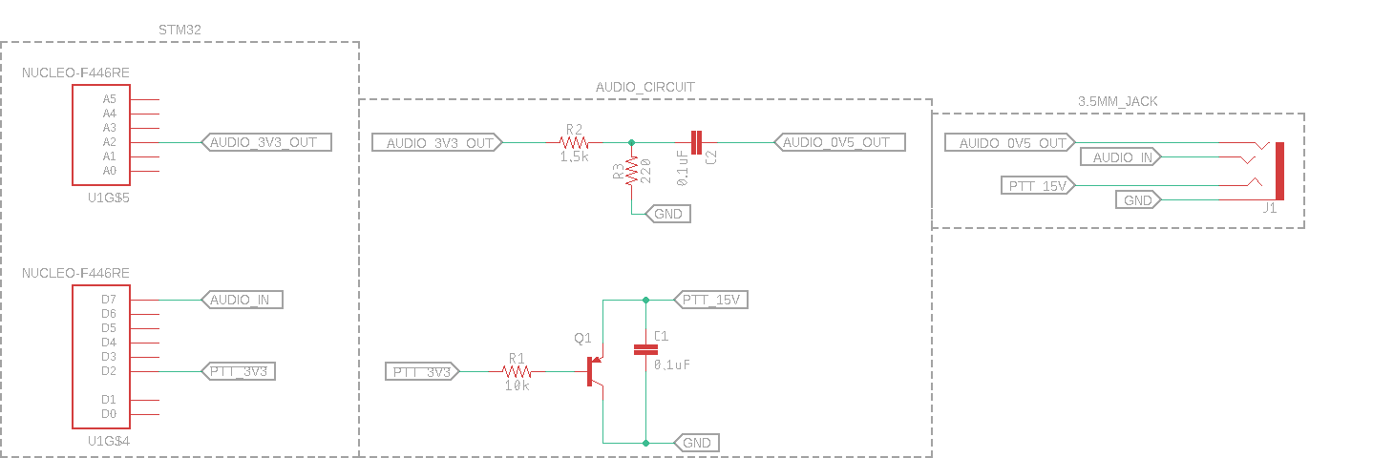
Schematic/EAGLE/MCUTNC/TNCMCU.png
