MrLordLeon/TNCMCU/Design Deliverables (Paper Revisions)/Bill of Materials/BOM 9_21_2020.xlsx

Item | Purchase Link | Mouser Part # | Cost Per | Amount | Total per Comp | Received (by)
SparkFun TRRS 3.5mm Jack Breakout | https://www.sparkfun.com/products/11570 | N/A | $3.95 | 4 | $15.80
Audio Cable TRRS - 3ft | https://www.sparkfun.com/products/14164 | N/A | $2.50 | 2 | $5.00
N-Channel MOSFET | https://www.mouser.com/ProductDetail/Infineon-Technologies/IPAN70R360P7SAUMA1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 | 726-IPAN70R360P7SAUM | $1.17 | 2 | $2.34
2.54mm Pin Headers | https://www.mouser.com/ProductDetail/TE-Connectivity-AMP/87220-8?qs=AplfTeSvkkBTrSXHcyuY1g%3D%3D | M22-2010205 | $3.68 | 4 | $14.72
 |  |  |  | Sub-total: | $37.86
