MrLordLeon/TNCMCU/Design Deliverables (Paper Revisions)/Bill of Materials/Eagle_BOM.xlsx

5 sets unit price |  |  | Type | Quantity | Package(Imperial/Metric) | Ref. Des | Datasheet | Mfr. Part #/Vendo Link | Mouser Part # | Digi-Key Part #
$1.995 | 5-7work days | PNP BJT |  | 1 | Through-Hole |  | https://www.mouser.com/datasheet/2/115/ZTX951-94165.pdf | ZTX951 | 522-ZTX951 | N/A
$1.995 | 5-7work days | STM32F446RE Nucleo board |  | 1 | uController |  | https://www.mouser.com/ProductDetail/STMicroelectronics/NUCLEO-F446RE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 | NUCLEO-F446RE | 511-NUCLEO-F446RE | N/A
$1.995 | 5-7work days | 3.5mm Audio Jack |  | 1 | Connector |  |  | 1699 | 485-1699 | N/A
$1.995 | 5-7work days | 10k Resistor |  | 1 | Through-Hole |  | https://www.mouser.com/datasheet/2/414/MFR-1528371.pdf | MFR5-10KFI | 756-MFR5-10KFI | N/A
$1.995 | 5-7work days | .1uF Capacitor |  | 2 | Through-Hole |  | https://www.mouser.com/datasheet/2/281/RDE_C0G_50V-100V_E-1670911.pdf | RDE5C1H104J2K1H03B | 81-RDE5C1H104J2K1H3B | N/A
$1.995 | 5-7work days | 1.5k Resistor |  | 1 | Through-Hole |  | https://www.mouser.com/datasheet/2/414/MFR-1528371.pdf | MFR4-1K5FI | 756-MFR4-1K5FI | N/A
 |  | 220 Resistor |  | 1 | Through-Hole |  | https://www.mouser.com/datasheet/2/414/MFP-1528234.pdf | MFP1-220RJI | 756-MFP1-220RJI | N/A
