MrLordLeon/TNCMCU/Design Deliverables (Paper Revisions)/Assignment 2/Preliminary Design/BOM 3_3_2020.xlsx

Item | Purchase Link | Cost Per | Amount | Total per Comp
STM32F446RE Nucleo board | https://www.mouser.com/ProductDetail/STMicroelectronics/NUCLEO-F446RE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 | $14.00 | 3 | $42.00
P-Channel MOSFET | https://www.mouser.com/ProductDetail/Infineon-IR/IRFU5505PBF | $0.88 | 10 | $8.80
Resistor Kit | https://www.sparkfun.com/products/10969 | $7.95 | 1 | $7.95
Capacitor Kit | https://www.sparkfun.com/products/13698 | $7.95 | 1 | $7.95
Analog Discovery 2 | https://store.digilentinc.com/analog-discovery-2-100msps-usb-oscilloscope-logic-analyzer-and-variable-power-supply/ | $279.00 | 1 | $279.00
3PCS 400 tie-Points breadboard | https://www.amazon.com/ELEGOO-tie-points-breadboard-Arduino-Jumper/dp/B01EV640I6 | $7.98 | 1 | $7.98
3.5 mm/2.5 mm jack | https://www.mouser.com/ProductDetail/Adafruit/1699 | $0.95 | 10 | $9.50
jumper wires(M-M, M-F,F-F) | https://www.amazon.com/EDGELEC-Breadboard-Optional-Assorted-Multicolored/dp/B07GD2BWPY | $5.79 | 3 | $17.37
 |  |  | Total: | $380.55
