MrLordLeon/TNCMCU/Software/Nolan Stuff/Nucleo-AX-Interface/CAPE-Nucleo_Interface_PCB/Release/Gerber Files/REQ-CAPE-001.xlsx

Sheet: Purchase Req.
Material Requisition Approval Form
Customer: |  | PE (CAPE) |  |  | Req # (filename) | REQ-CAPE-001
Project: |  |  |  |  | Rebilled to Customer (y/n)
PO # : |  |  |  |  | Markup %
Total : |  | $54.00 |  |  |  |  |  |  |  | Procurement
Item # | Qty | Unit(ea, ft, bag, etc) | Mfg Part# | Mfg Name | Description | Source/ Vendor (Link) | Ship Via(use drop down list) | Cost ea. | Cost ext. | Ordered | Received | Comments
1 | 1 | 10 | GERB-PCB-CAPE_Nucleo_Interface_V1R0 | PCBWay | CAPE AX5043 Nucleo Interface PCB V1R0 | https://www.pcbway.com/orderonline.aspx | Best Way | $54.00 | $54.00 |  |  | does not include shipping; no stencil required.
2 |  |  |  |  |  |  |  |  | $0.00
3 |  |  |  |  |  |  |  |  | $0.00
4 |  |  |  |  |  |  |  |  | $0.00
5 |  |  |  |  |  |  |  |  | $0.00
6 |  |  |  |  |  |  |  |  | $0.00
7 |  |  |  |  |  |  |  |  | $0.00
8 |  |  |  |  |  |  |  |  | $0.00
9 |  |  |  |  |  |  |  |  | $0.00
10 |  |  |  |  |  |  |  |  | $0.00
11 |  |  |  |  |  |  |  |  | $0.00
12 |  |  |  |  |  |  |  |  | $0.00
13 |  |  |  |  |  |  |  |  | $0.00
14 |  |  |  |  |  |  |  |  | $0.00
15 |  |  |  |  |  |  |  |  | $0.00
16 |  |  |  |  |  |  |  |  | $0.00
17 |  |  |  |  |  |  |  |  | $0.00
18 |  |  |  |  |  |  |  |  | $0.00
19 |  |  |  |  |  |  |  |  | $0.00
20 |  |  |  |  |  |  |  |  | $0.00
21 |  |  |  |  |  |  |  |  | $0.00
22 |  |  |  |  |  |  |  |  | $0.00
23 |  |  |  |  |  |  |  |  | $0.00
24 |  |  |  |  |  |  |  |  | $0.00
25 |  |  |  |  |  |  |  |  | $0.00
Date: |  |  | 2019-09-07 |  |  | Requisitioned By: |  | Nolan Edwards
Date: |  |  |  |  |  | Manager Approval:
PE-QF-190-03 Materials Requisition Template

Sheet: Instructions
1 | Fill out all fields of form
2 | Cart hyperlinks may be added in the source/vendor link field. (only one link per cart)
 | Other parts in that cart reference line item with the cart link
3 | Save Req as file in Dropbox under the appropriate customer service folder
4 | Create card in Trello to notify management of Req to approve, put link in Trello card

Sheet: Form Revision
REV. | SECTION | PARA. | DATE | CHANGE MADE | REVIEWED BY | AUTHORIZED BY
1 | All | All |  | Initial Release | Unknown | Unknown
2 | n/a | n/a | 43220 | Added revision tracking | James Palmer | James Palmer
3 | n/a | n/a | 43220 | Added ordered and comments column | James Palmer | James Palmer
4 |  |  | 2018-05-01 | added req# field and rebilled field | James Palmer | James Palmer
5 | Req |  | 2018-05-01 | added form controls
6 | Req |  | 2018-05-17 | Temporarily removed form controls
7 | Req |  | 2018-06-01 | Added Markup field | James Palmer | James Palmer

Sheet: Lists
Purchase Card/Debit Card - prepay | Best Way | CapEx
Employee Expense Account | Ground | Inventory
Company Check - Operating Funds | 2nd Day | Materials
Company Check - CAPEX Funds | Overnight by COB | Product Sale
Net Terms | Overnight by AM | Rental
Wire | Bill 3rd Party
ACH
