MrLordLeon/TNCMCU/Design Deliverables (Paper Revisions)/Change Order Forms/Change Order Form.docx

Change Order Form (COF) Rev 1
Date
Subsystem
Component
Change
Reasoning
Rationale
Mod. Details
