MrLordLeon/TNCMCU/Design Deliverables (Paper Revisions)/Change Order Forms/Submitted CoF/RS-232.docx

Change Order Form (COF) Rev 1
Date | 11/1/2020
Subsystem | Signal Reception/Transmission Lines 1.1.1
Component | RS-232 port
Change | Removal from design
Reasoning | Design will not support this port anymore.
Rationale | Due to the time constraints of the semester, we will not have time to implement a RS-232 jack.
Mod. Details | Removal
