MrLordLeon/TNCMCU/Software/Nolan Stuff/Nucleo-AX-Interface/CAPE-Nucleo_Interface_PCB/Project Outputs for CAPE-Nucleo_Interface_PCB/CAPE-Nucleo_Interface_PCB.xls

Designator | Quantity | Manufacturer | Part Number | Package | Value
R26, R32, R33, R36, R38, R40, R41, R42, R43, R44, R45, R46, R47, R48, R49, R50, R51 | 17 | Yageo | RC1206FR-07100KL | 1206 | 100 KΩ
C1, C7, C8, C9, C10, C13, C14, C15, C16, C17, C19, C20, C21, C33 | 14 | Samsung | CL31B104KBCNNNC | 1206 | 0.1 µF
PA_Power, TNC_FSK_RX, TNC_FSK_TX, TNCi, TNCo, UHF_TRANS, UHFi, UHFo, Vbus, Vbus_f, VHF_TRANS, VHFi, VHFo | 13 | Keystone Electronics | 5019
DS4, DS5, DS6, DS7, TACT, TNC_EGY, TNC_PTT, UACT, UHF, VACT, VHF | 11 | Kingbright | APTD3216CGCK
R16, R17, R18, R19, R20, R21, R23, R24, R25 | 9 | Yageo | RC1206FR-07330RL | 1206 | 330 Ω
R27, R29, R30, R31, R35, R37, R39 | 7 | Yageo | RC1206FR-0710KL | 1206 | 10 KΩ
C26, C27, C30, C31, C32, C34 | 6 | Samsung | CL31B105KOFNNNE | 1206 | 1 µF
C2, C3, C4, C5, C6 | 5 | Wurth Electronics Inc. | 885012208101 | 1206 | 150 pF
R1, R2, R13, R14, R15 | 5 | Yageo | RC1206FR-072K2L | 1206 | 2.2 KΩ
R3, R5, R7, R9, R11 | 5 | Yageo | RC1206FR-0756RL | 1206 | 56 Ω
R4, R6, R8, R10, R12 | 5 | Yageo | RC1206FR-07160RL | 1206 | 160 Ω
C22, C23, C24, C25 | 4 | Samsung | CL31C330JBCNNNC | 1206 | 33 pF
C11, C29 | 2 | Samsung | CL31B103KBCNNNC | 1206 | 0.01 µF
R28, R34 | 2 | Yageo | RC1206FR-071KL | 1206 | 1 KΩ
UHFC, VHFC | 2 | Amphenol | 63453-118LF
C12 | 1 | Samsung | CL31C101JBCNNNC | 1206 | 100 pF
C28 | 1 | Samsung | CL31A475KPHNNNE | 1206 | 4.7 µF
D1 | 1 | On Semiconductor | MBRS340T3
DBG1 | 1 | Samtec | SSQ-116-02-T-D-RA
FB1 | 1 | Murata | BLM31PG121SN1L
R22 | 1 | Yageo | RC1206FR-074K7L | 1206 | 4.7 KΩ
U1 | 1 | Texas Instruments | SN74LVC2G125DCTR
U2 | 1 | Texas Instruments | SN74LVC2G04DBVT
U3 | 1 | Texas Instruments | PCA9554DWR
U4 | 1 | Maxim | DS2482S-100+
U5 | 1 | CML Microcircuits | MX614TN
U6 | 1 | Microchip | PIC16LF1847-I/SS
U7 | 1 | Microchip | MCP6023-I/SN
U8 | 1 | Microchip | 23K640-I/ST
U9 | 1 | Analog Devices | ADG2188BCPZ-REEL7
USB1 | 1 | TE Connectivity | 1-1734346-1
Y1 | 1 | Abracon | ABM3B-20.000MHZ-B2-T
Y2 | 1 | ECS | ECS-035-18-4X-DU
