MrLordLeon/TNCMCU/Design Deliverables (Paper Revisions)/Deliverable 5/EECE460 Design 2 Comprehensive Modular-Build and Testing plan -Team2-MCU TNC Design.docx

Deliverable 5

Design 2

Team 2

MCU TNC Design

Kaleb Leon – C00094357

Kobe Keopraseuth – C00092349

David Cain – C00043561

November 2nd, 2020

A. Current Comprehensive Testing Tree Progress

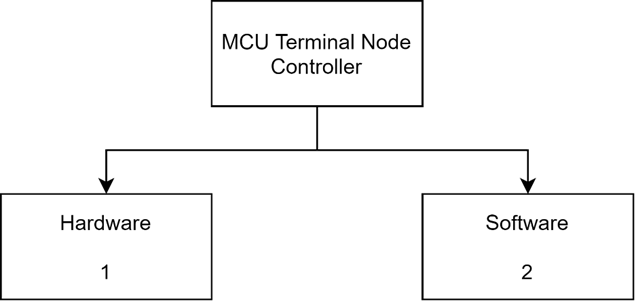
[picture p228: figure]

Figure F-1. High Level Comprehensive Testing Tree

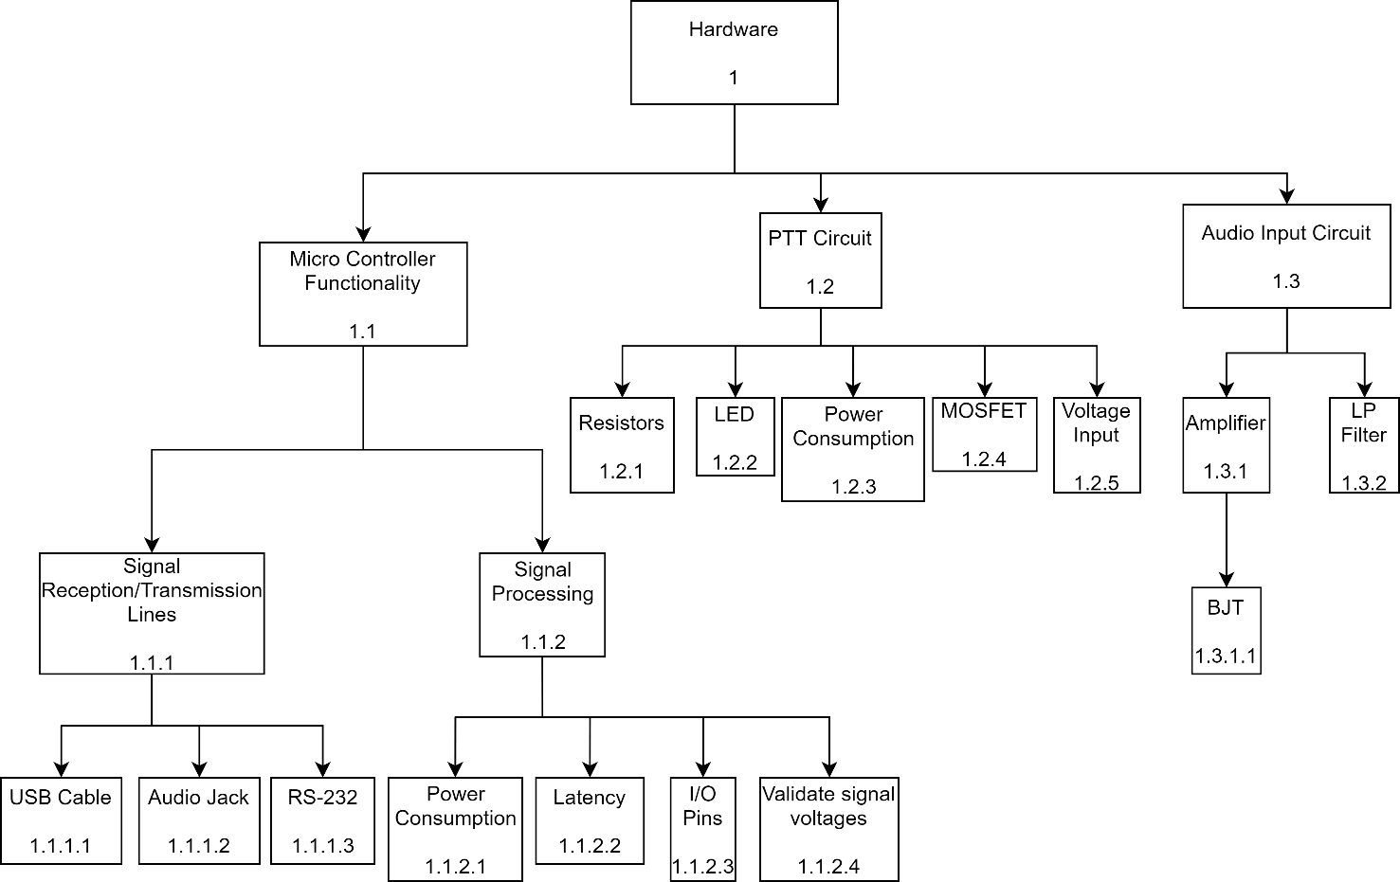
[picture p229: figure]

Figure F-2. Hardware Comprehensive Testing Tree

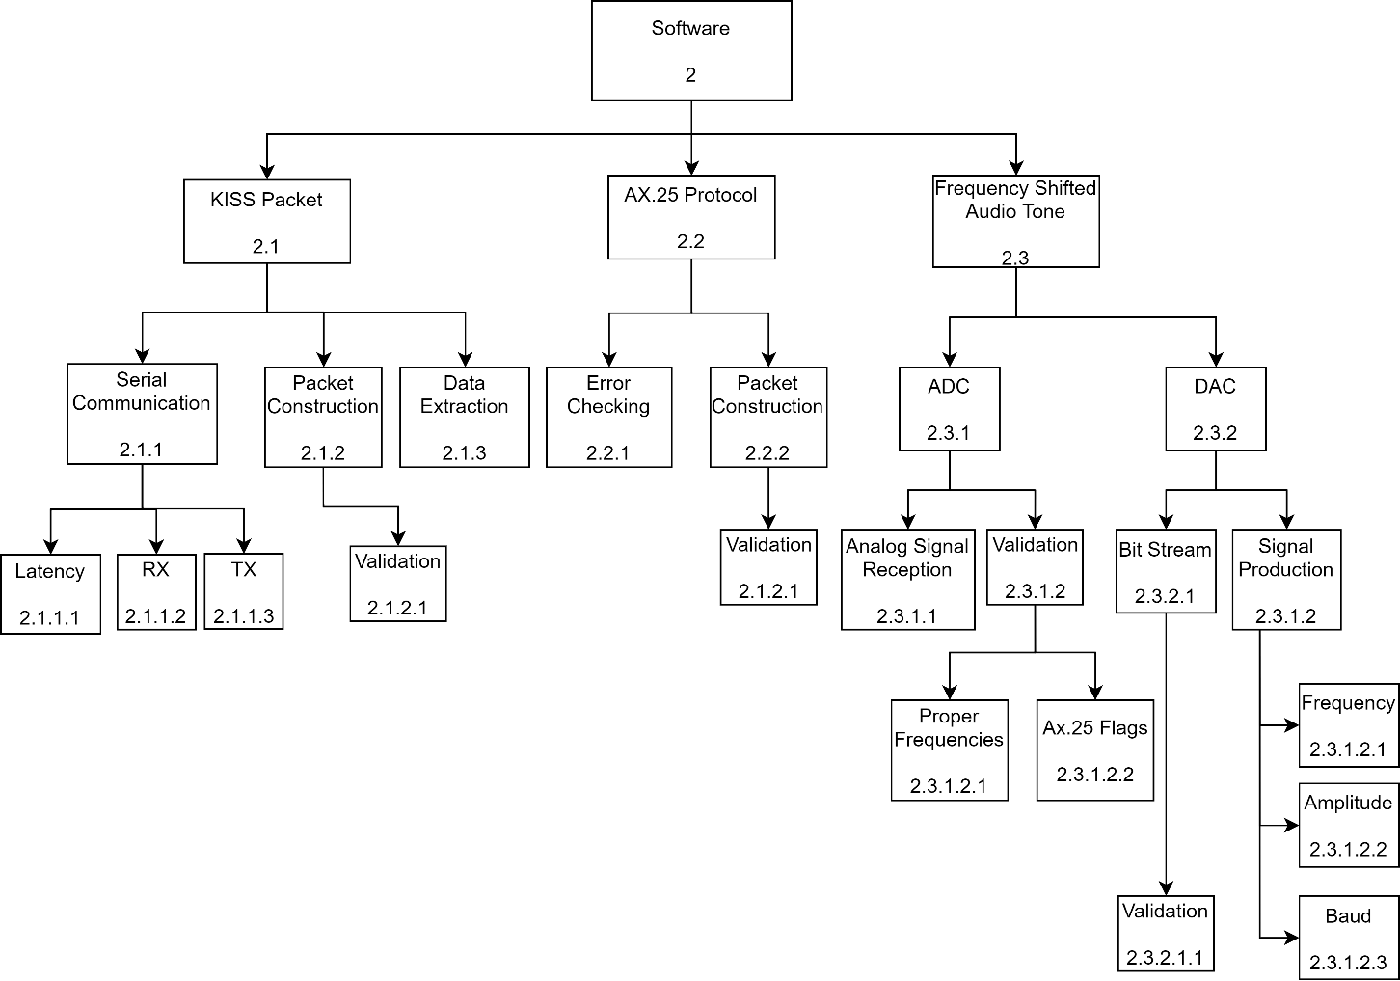
[picture p230: figure]

Figure F-3. Software Comprehensive Testing Tree

B. Completed Testing Forms
