MrLordLeon/TNCMCU/Design Deliverables (Paper Revisions)/Assignment 3/Wiring Assembly.docx

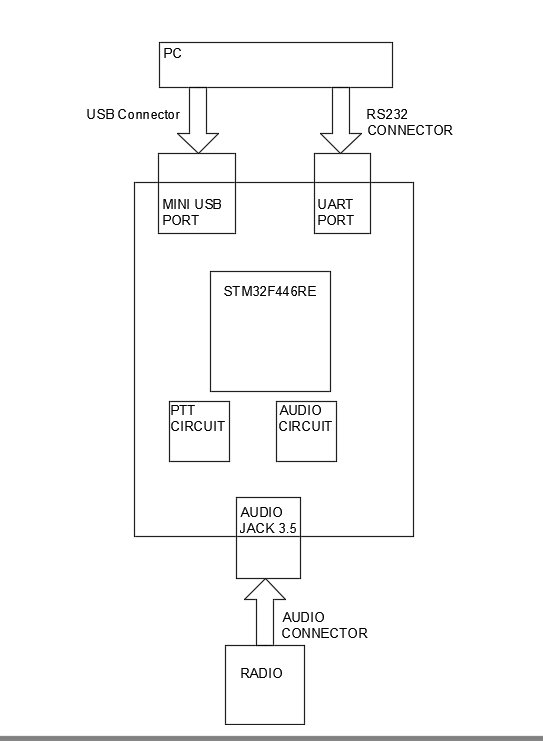
[picture p231: figure]
