MrLordLeon/TNCMCU/Design Deliverables (Paper Revisions)/Testing Documents/Complete Tests/Software/2.3.2.docx

TNC Testing Form (REV1)
Leaf on the Tree | DAC
Device Under Test (Testing Tree Number): | 2.3.2
Date: | 11/1/20
Person(s) Conducting Experiment: | Kobe Keopraseuth, Kaleb Leon, David Cain
Signature:
Experiment Purpose: | Test the entire DAC subsystem with an actual AX.25 packet actually used in our project.
Experiment Procedure: | Feed a known accurate AX.25 packet then use code to covert that into an analog output signal.
Equipment Settings / Software Settings (w Revision): | Current code base for DAC Sinewave.

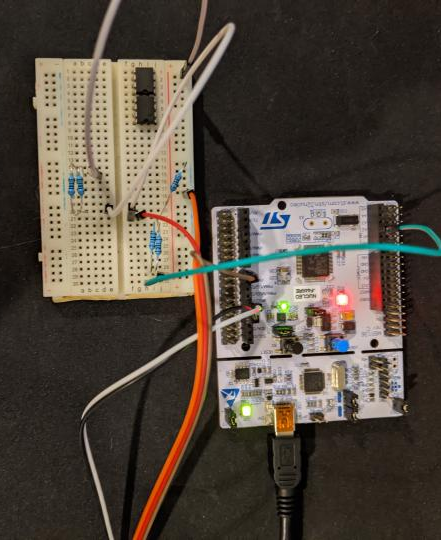
[picture p241: figure]
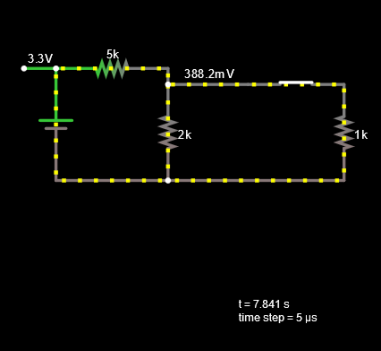
[picture p242: figure]

Testing Diagram / Picture:

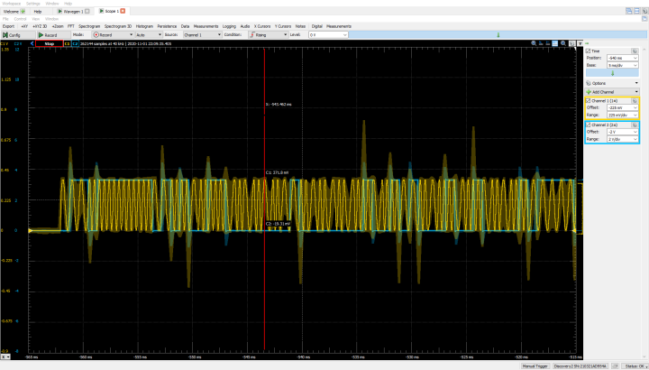
[picture p243: figure]

Data Points:
Pass / Fail: | Pass
Interpreted Notes: | Meets the accuracy we required of the output analog signal.
Recommendations for Modifications: | N/A
