MrLordLeon/TNCMCU/Design Deliverables (Paper Revisions)/Testing Documents/Complete Tests/Software/2.1.2.1.1.docx

TNC Testing Form (REV1)
Leaf on the Tree | 2.1.2.1.1
Device Under Test (Testing Tree Number): | Validation
Date: | 11/1/20
Person(s) Conducting Experiment: | Kobe Keopraseuth
Signature:
Experiment Purpose: | The purpose of this experiment is to validate that our stm32 board can detect and receive KISS packets from our computer over UART. To validate the KISS packet was properly received, the binary KISS packet will be displayed on the serial monitor and a green LED on the board should light up when the packet was successfully received.
Experiment Procedure: | Use Rizwan’s software to send a KISS packet to our microcontroller and display what we received, in binary on the serial monitor.
Equipment Settings / Software Settings (w Revision): | We will be using Rizwan’s given software to generate and send the KISS packet and visual studio’s serial monitor to output the data extraction done by our microcontroller.

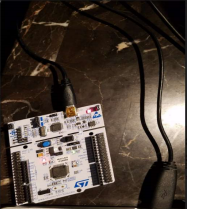
[picture p244: figure]

Testing Diagram / Picture:

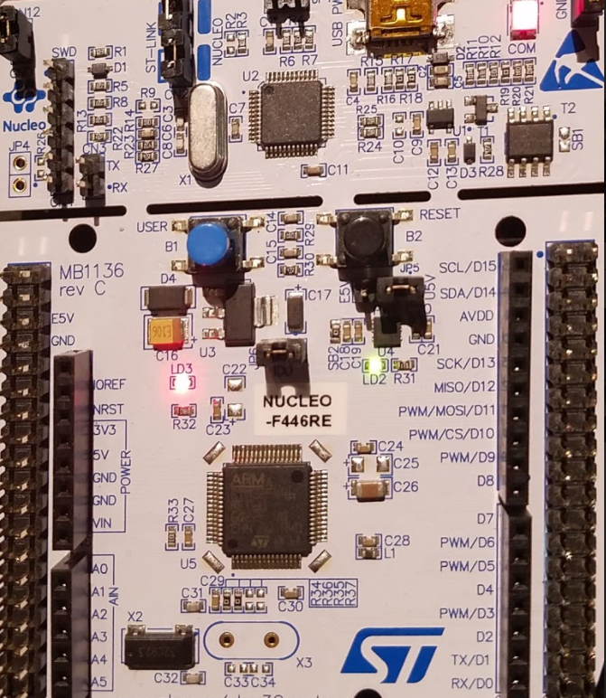
[picture p245: figure]
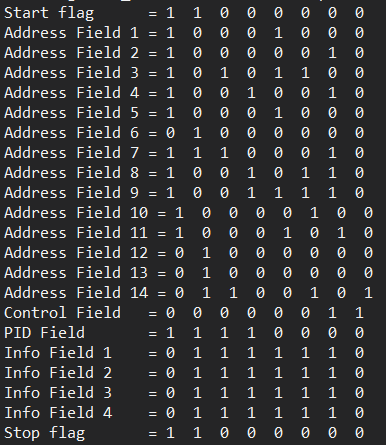
[picture p246: figure]

Data Points: | LED Lights up Transmitted HEX Packet Serial monitor
Pass / Fail: | Pass
Interpreted Notes: | As shown when a KISS packet is sent over UART, the microcontrollers LED lights up. Also the binary bit stream of the KISS packet corresponds to the HEX packet sent over UART.
Recommendations for Modifications: | None
