MrLordLeon/TNCMCU/Design Deliverables (Paper Revisions)/Testing Documents/Complete Tests/Software/2.1.1.2.1.docx

TNC Testing Form (REV1)
Leaf on the Tree | RX
Device Under Test (Testing Tree Number): | 2.1.1.2
Date: | 10/31/2020
Person(s) Conducting Experiment: | David Cain
Signature:
Experiment Purpose: | The purpose of this experiment is to ensure the microcontroller is receiving data over UART.
Experiment Procedure: | To test the data connection over UART, the microcontroller will be given a packet, and this will then printed over serial again.
Equipment Settings / Software Settings (w Revision): | The microcontroller will be running our most current version of software and I will be viewing the output using a serial monitor program called RealTerm 2.0.0.70. I will be feeding packets using the program provided to us by Rizwan.

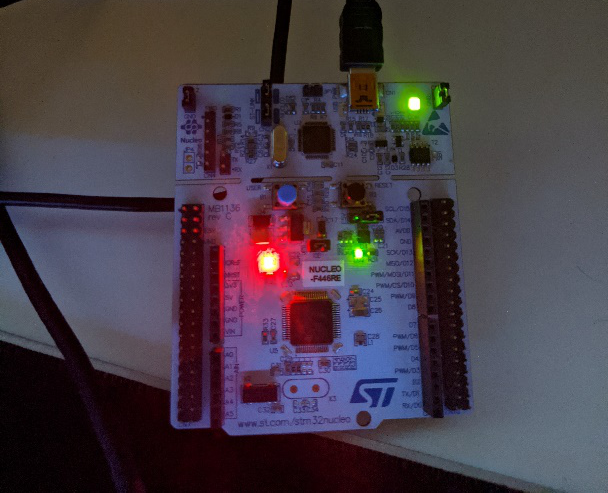
[picture p247: figure]

Testing Diagram / Picture:

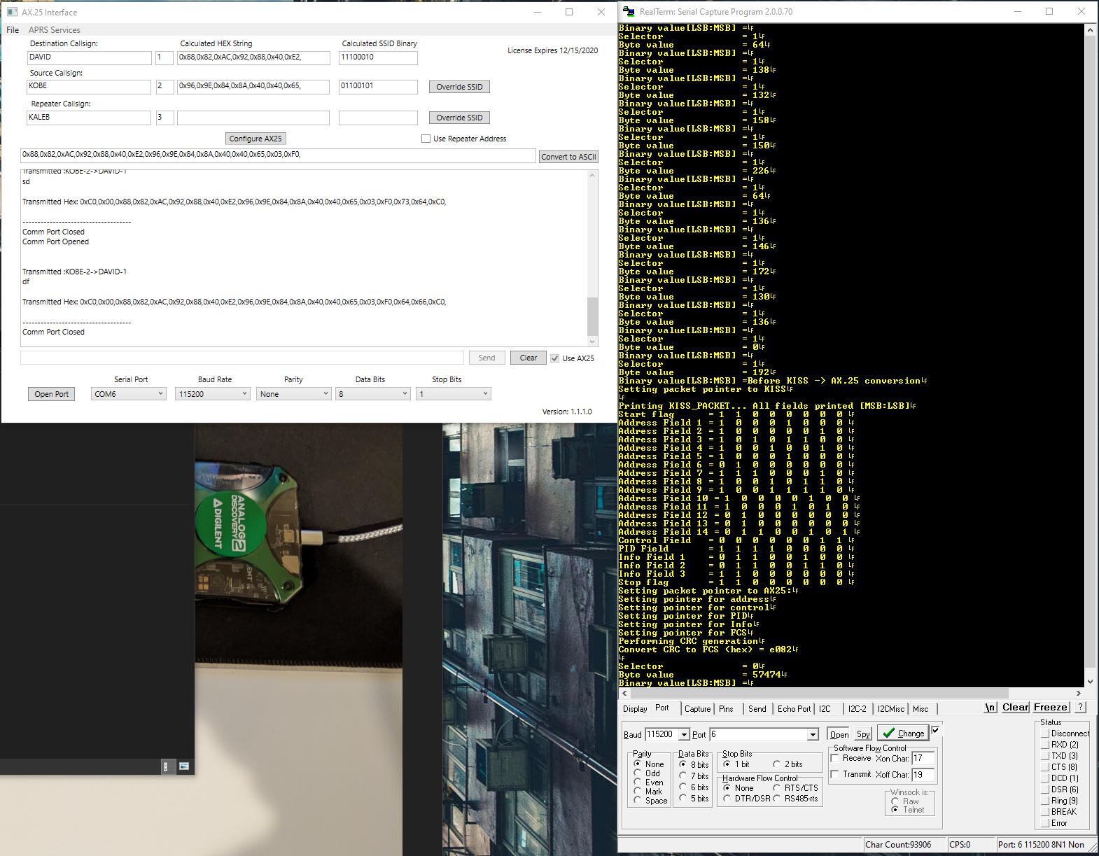
[picture p248: figure]

Data Points:
Pass / Fail: | Pass
Interpreted Notes: | The data being read over the serial monitor seems acceptable for the given packet.
Recommendations for Modifications: | None.
