MrLordLeon/TNCMCU/Design Deliverables (Paper Revisions)/Testing Documents/Complete Tests/Software/2.1.2.docx

TNC Testing Form (REV1)
Leaf on the Tree | Packet Construction
Device Under Test (Testing Tree Number): | 2.1.2
Date: | 11/1/20
Person(s) Conducting Experiment: | Kobe Keopraseuth, Kaleb Leon, David Cain
Signature:
Experiment Purpose: | Testing our mentor’s software to make sure it produces the correct KISS packets
Experiment Procedure: | Entering callsigns and data so that it can be made into a packet and then checking that packet to make sure it has the right contents
Equipment Settings / Software Settings (w Revision):

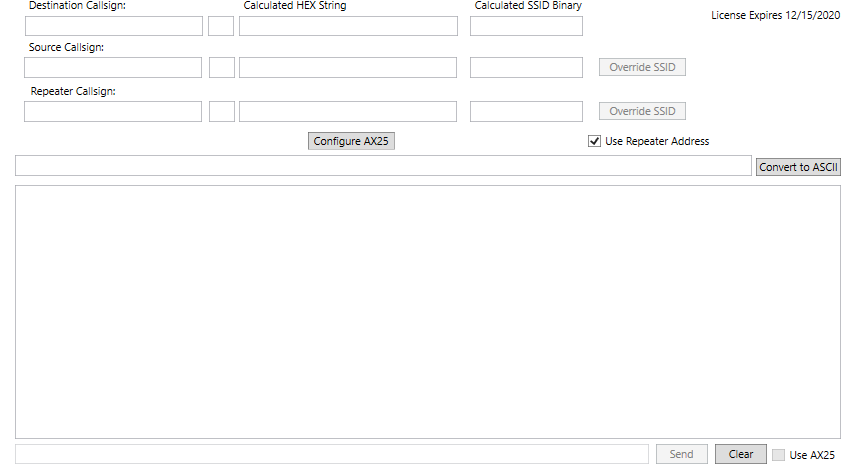
[picture p256: figure]

Testing Diagram / Picture:

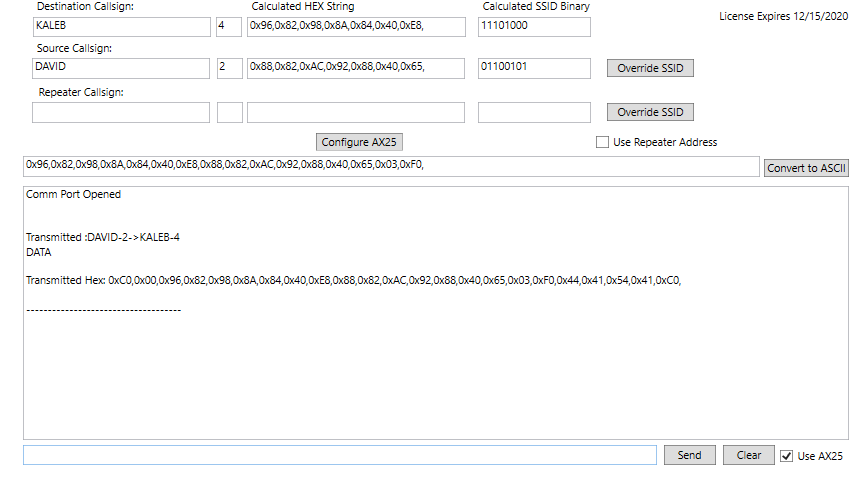
[picture p257: figure]

Data Points:
Pass / Fail: | PASS
Interpreted Notes: | The software produces the desired valid Kiss packet for testing on our software.
Recommendations for Modifications: | N/A
