MrLordLeon/TNCMCU/Design Deliverables (Paper Revisions)/Testing Documents/Complete Tests/Software/2.2.1.docx

TNC Testing Form (REV1)
Leaf on the Tree | AX.25 Protocol
Device Under Test (Testing Tree Number): | 2.2.1
Date: | 11/1/20
Person(s) Conducting Experiment: | Kobe Keopraseuth
Signature:
Experiment Purpose: | The purpose of this experiment of this experiment is to verify that our microcontroller can take in a KISS packet and format the AX.25 Packet Correctly.
Experiment Procedure: | Take in a KISS packet from computer and display the fields of the AX.25 packet. We will also show the calculated crc to show that the KISS packet for properly extracted.
Equipment Settings / Software Settings (w Revision): | Use Rizwan’s software to send a KISS packet and display the AX.25 packet on serial monitor.

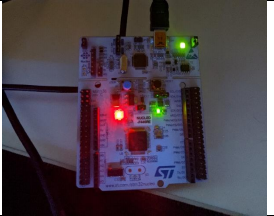
[picture p258: figure]

Testing Diagram / Picture:

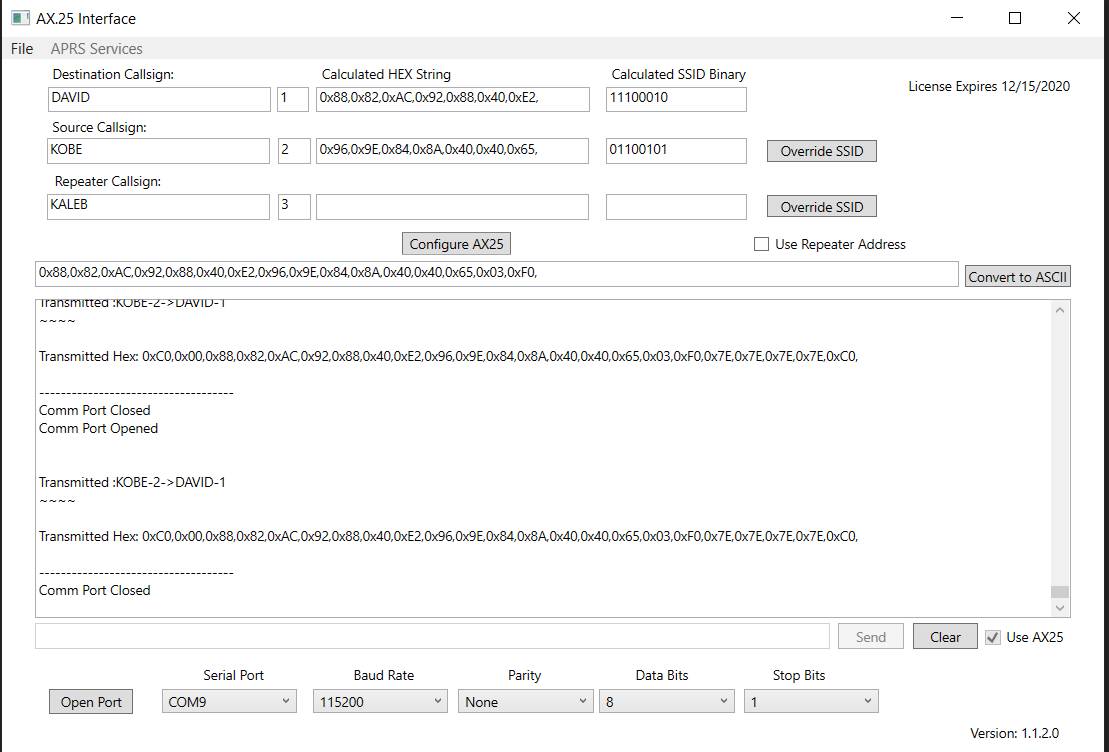
[picture p259: figure]
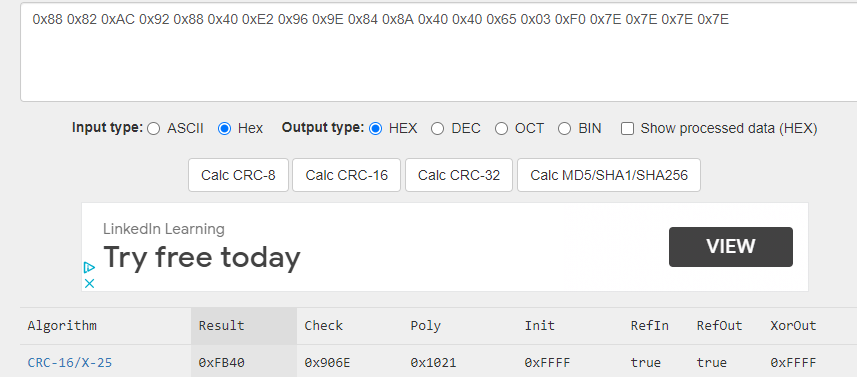
[picture p260: figure]
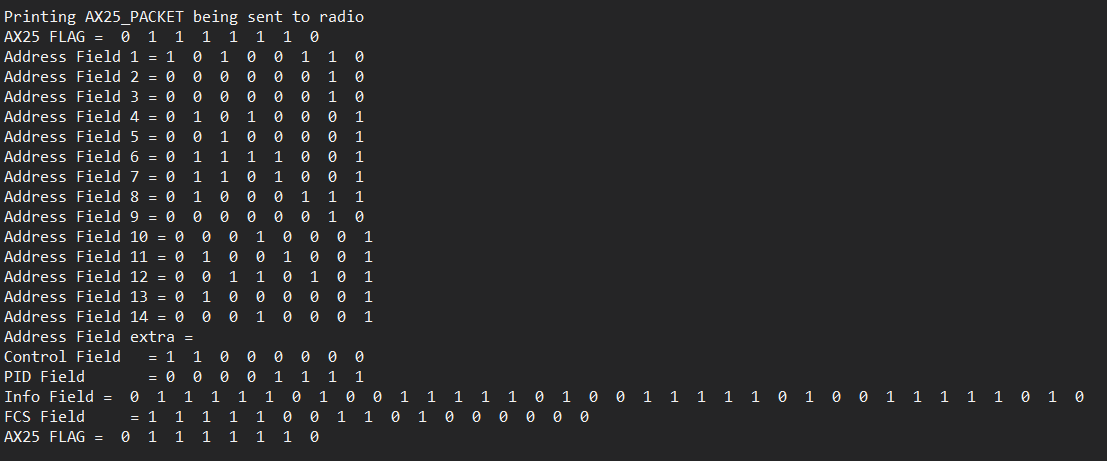
[picture p261: figure]

Data Points: | Rizwan’s software for transmitting KISS packets Bitstream output of received KISS packet Online crc calculation for the KISS packet Microcontroller’s crc calculation for KISS packet AX.25’s bit sequence when sent to radio
Pass / Fail: | Pass
Interpreted Notes: | Our microcontroller can properly extract a KISS packet and format it into AX.25, along with correctly calculating the crc for the FCS field. It is also able to place the bits to be sent to over radio in the correct order.
Recommendations for Modifications: | None
