MrLordLeon/TNCMCU/Design Deliverables (Paper Revisions)/Diagrams Links/Testing Tree.png

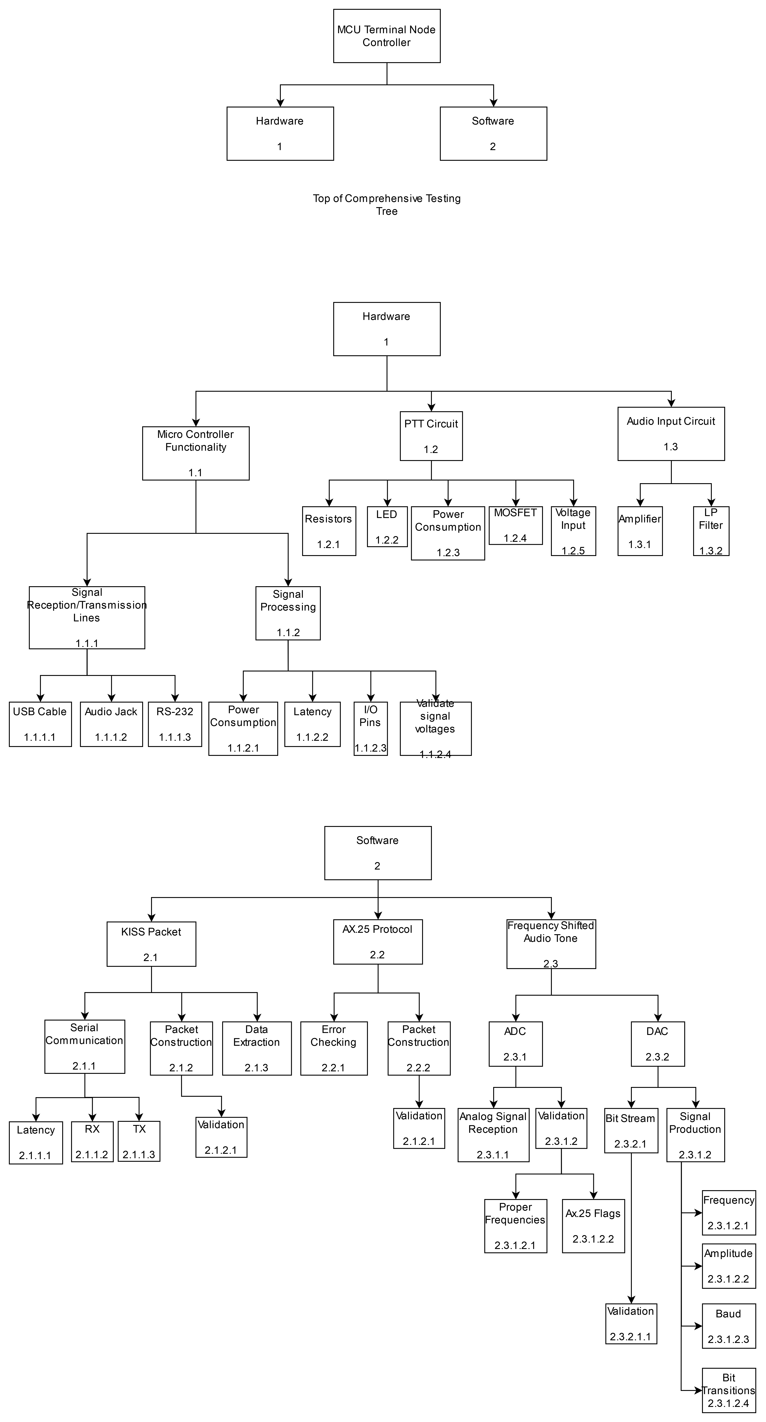
Design Deliverables (Paper Revisions)/Diagrams Links/Testing Tree.png
