MrLordLeon/TNCMCU/Design Deliverables (Paper Revisions)/Assignment 3/Table of Contents.docx

Table of Contents

I. Introduction…………………………………………………………………………………………… 1
II. Research of Work Done By Others………………………………………………………………….. 1
A. KISS MODE………………………………………………………………………………………. 1
B. HDLC (High-level-Data Link Control) Protocol…………………………………………………. 2
C. AX.25 Protocol……………………………………………………………………………………. 2
D. AFSK (Audio Frequency Shift Keying)…………………………………………………………... 2
III. Project Analysis……………………………………………………………………………………….. 2
A. Project Analysis…………………………………………………………………………………… 2
B. Alternatives and Tradeoffs Considerations……………………………………………………….. 2
C. Preliminary Design………………………………………………………………………………... 3

References………………………………………………………………………………………………………. 4

Appendix A……………………………………………………………………………………………………... 6

A. Scope of Work…………………………………………………………………………………….. 6
B. Functional Requirements………………………………………………………………………….. 6
C. Objective Tree……………………………………………………………………………………...7
D. Level 0 Functional Block Diagram………………………………………………………………... 8
E. Level 1 Functional Block Diagram………………………………………………………………... 8

Appendix B……………………………………………………………………………………………………… 9

A. Technological Analysis……………………………………………………………………………. 9
B. Time Analysis……………………………………………………………………………………... 9
C. Cost Analysis……………………………………………………………………………………… 9
D. Regulatory Considerations………………………………………………………………………… 9
E. Gantt Chart…………………………………………………………………………………………10

Appendix C……………………………………………………………………………………………………...11

A. Alternatives and Tradeoffs Analysis……………………………………………………………….11

Appendix D……………………………………………………………………………………………………...15

A. Receiving Flowchart……………………………………………………………………………….16
B. Transmitting Flowchart…………………………………………………………………………….17
C. Packet Formatting Flowchart………………………………………………………………………18
D. OSI Layered Communications Model……………………………………………………………...19
E. Failure Modes and Effect Analysis (FMEA)……………………………………………………….20
F. Wiring Schematics…………………………………………………………………………………21

Appendix E……………………………………………………………………………………………………..22
