MrLordLeon/TNCMCU/Design Deliverables (Paper Revisions)/Assignment 3/OSI model.docx

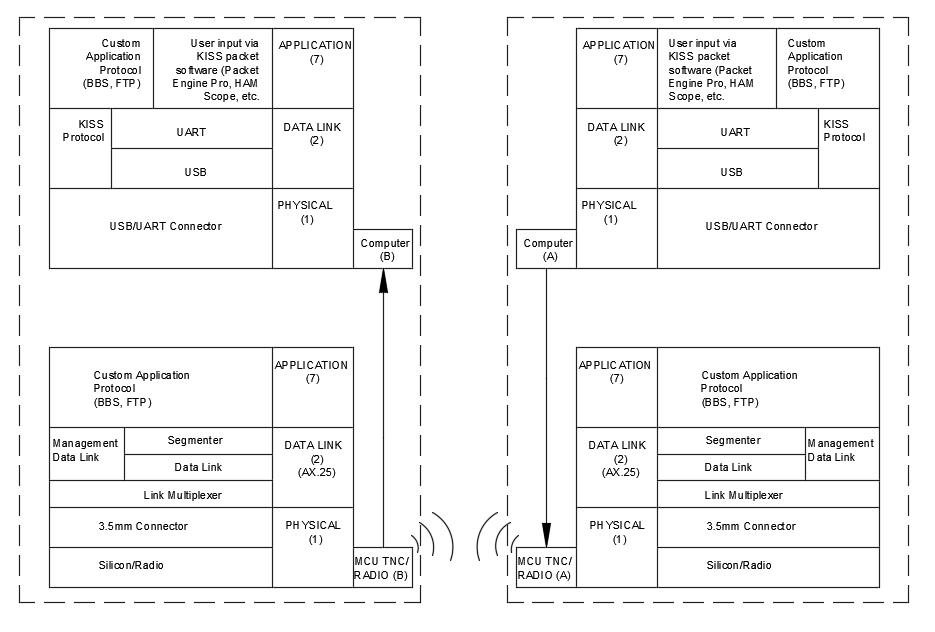
[picture p272: figure]
