MrLordLeon/TNCMCU/Design Deliverables (Paper Revisions)/Meeting Minutes/10_18_2020.pdf

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

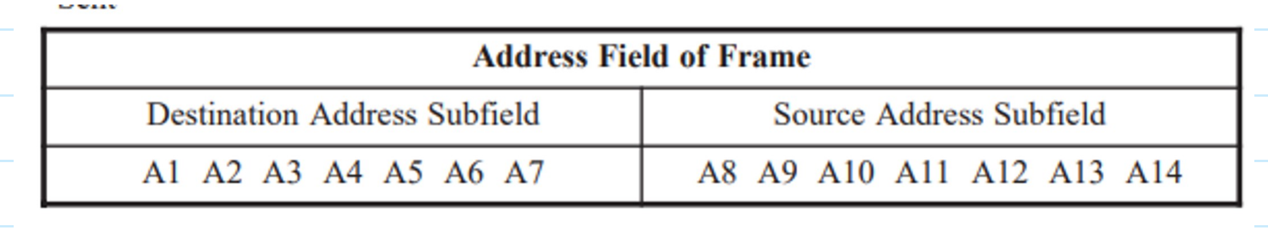
[picture p273: figure]
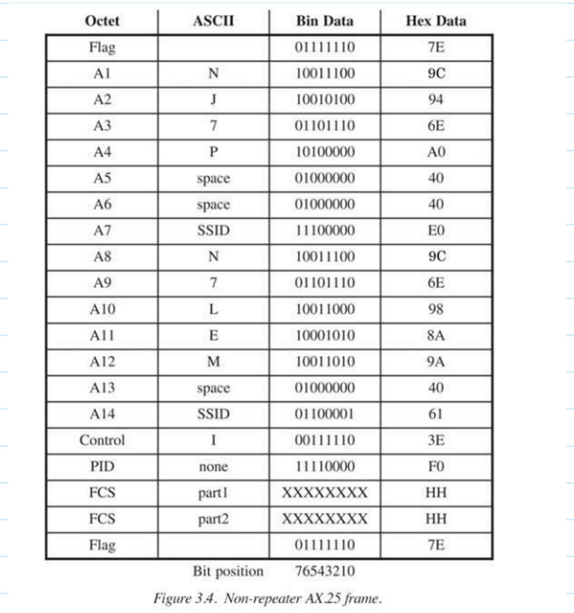
[picture p274: figure]
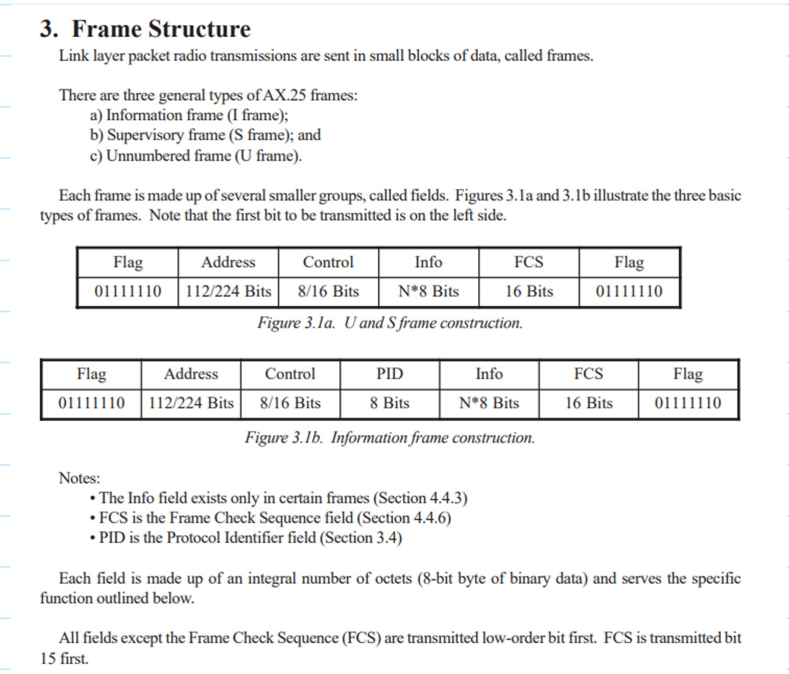
[picture p275: figure]
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
