MrLordLeon/TNCMCU/Design Deliverables (Paper Revisions)/Diagrams Links/Gantt Layout - Semester 1.png

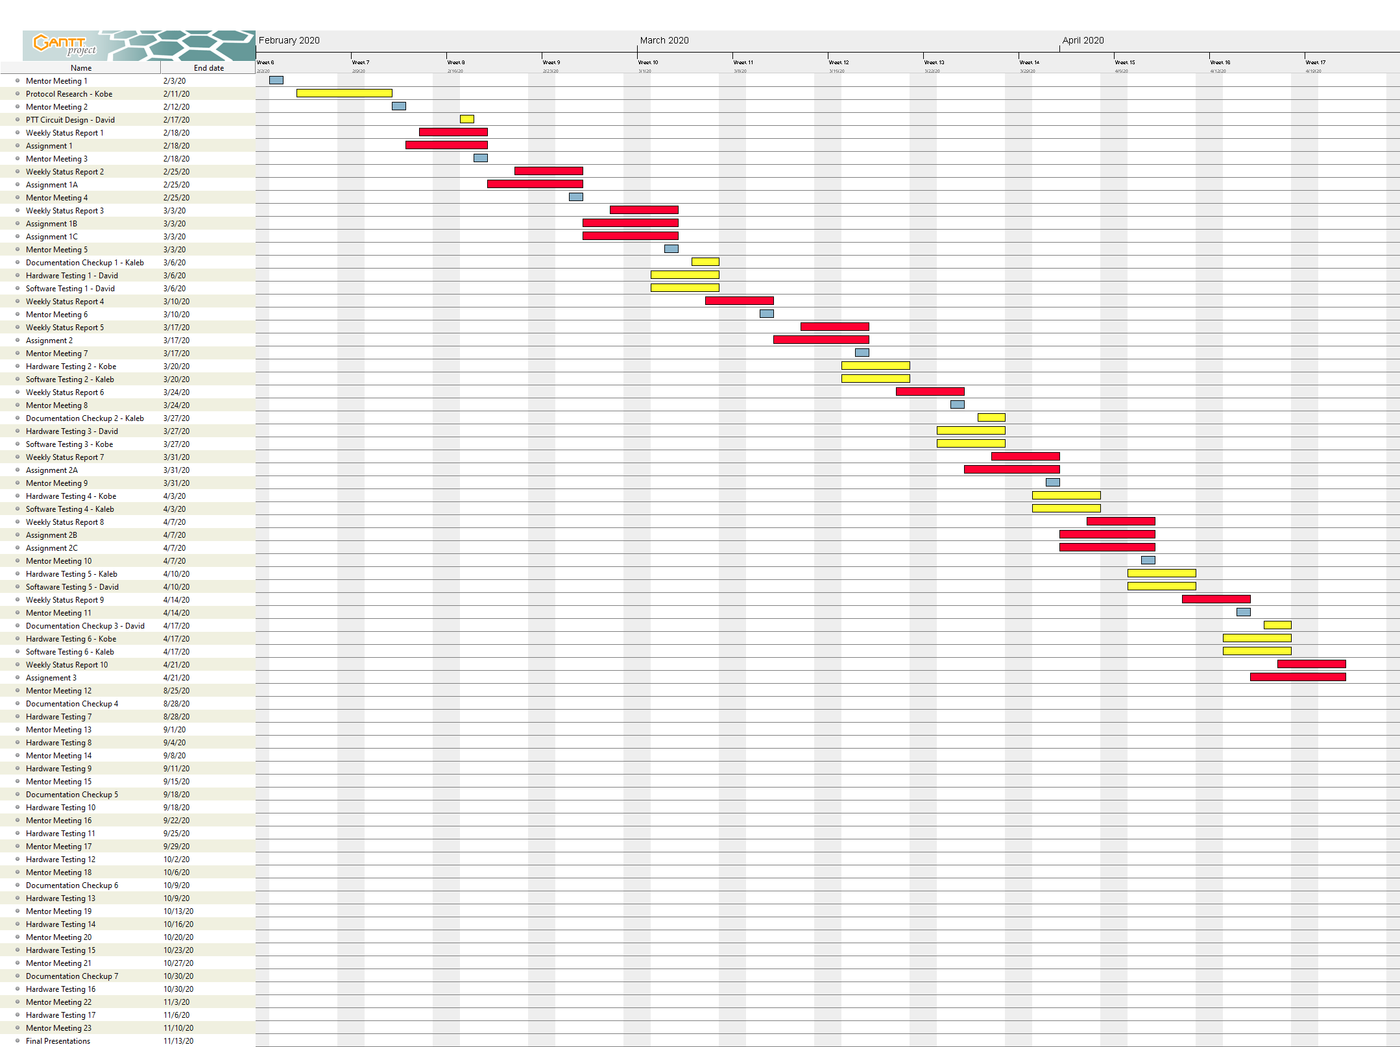
Design Deliverables (Paper Revisions)/Diagrams Links/Gantt Layout - Semester 1.png
