MrLordLeon/TNCMCU/Design Deliverables (Paper Revisions)/Diagrams Links/TNCMCU Flow Chart.png

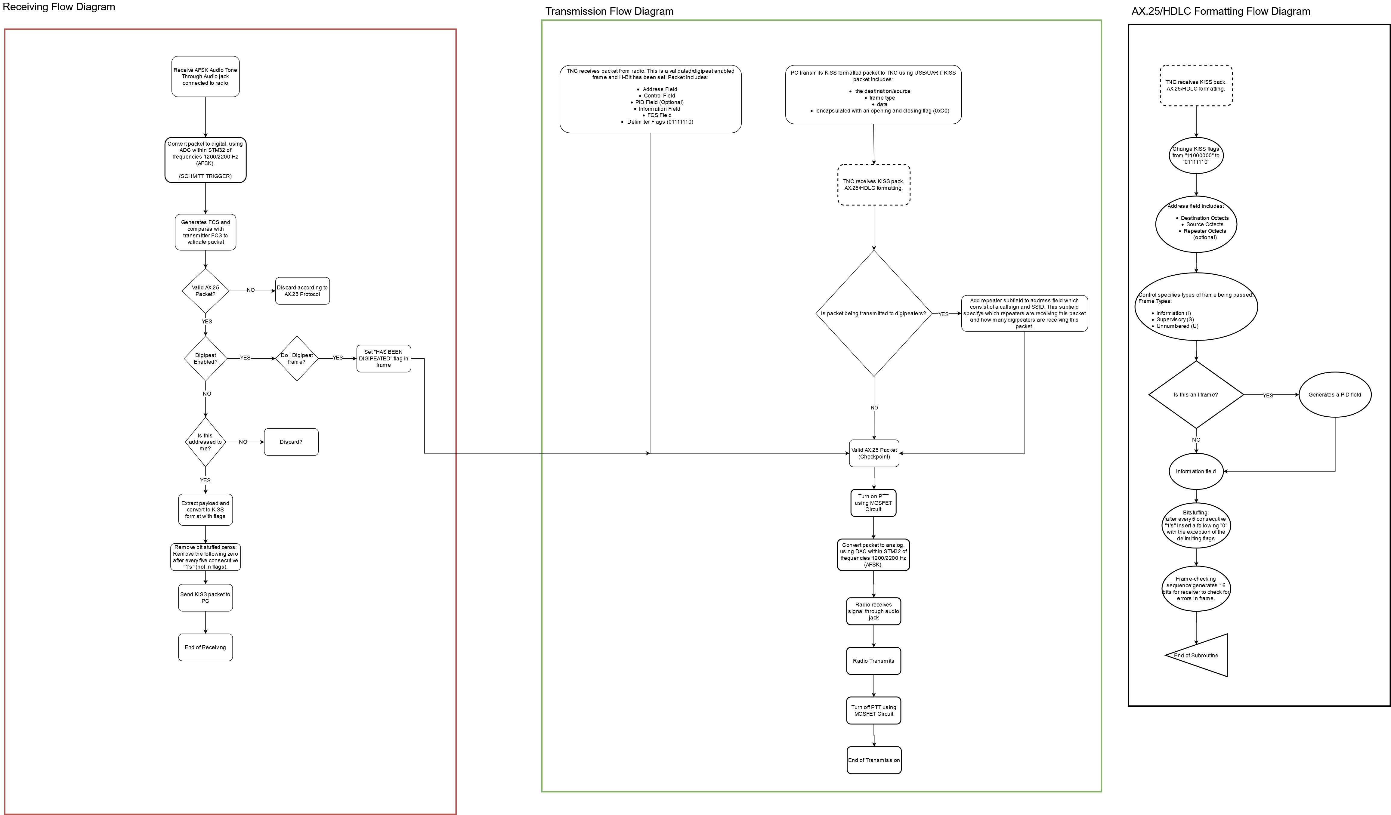
Design Deliverables (Paper Revisions)/Diagrams Links/TNCMCU Flow Chart.png
