MrLordLeon/TNCMCU/Software/Nolan Stuff/Nucleo-AX-Interface/Release/Schematic Print/SCH CAPE Nucleo Interface PCB V1R0.PDF

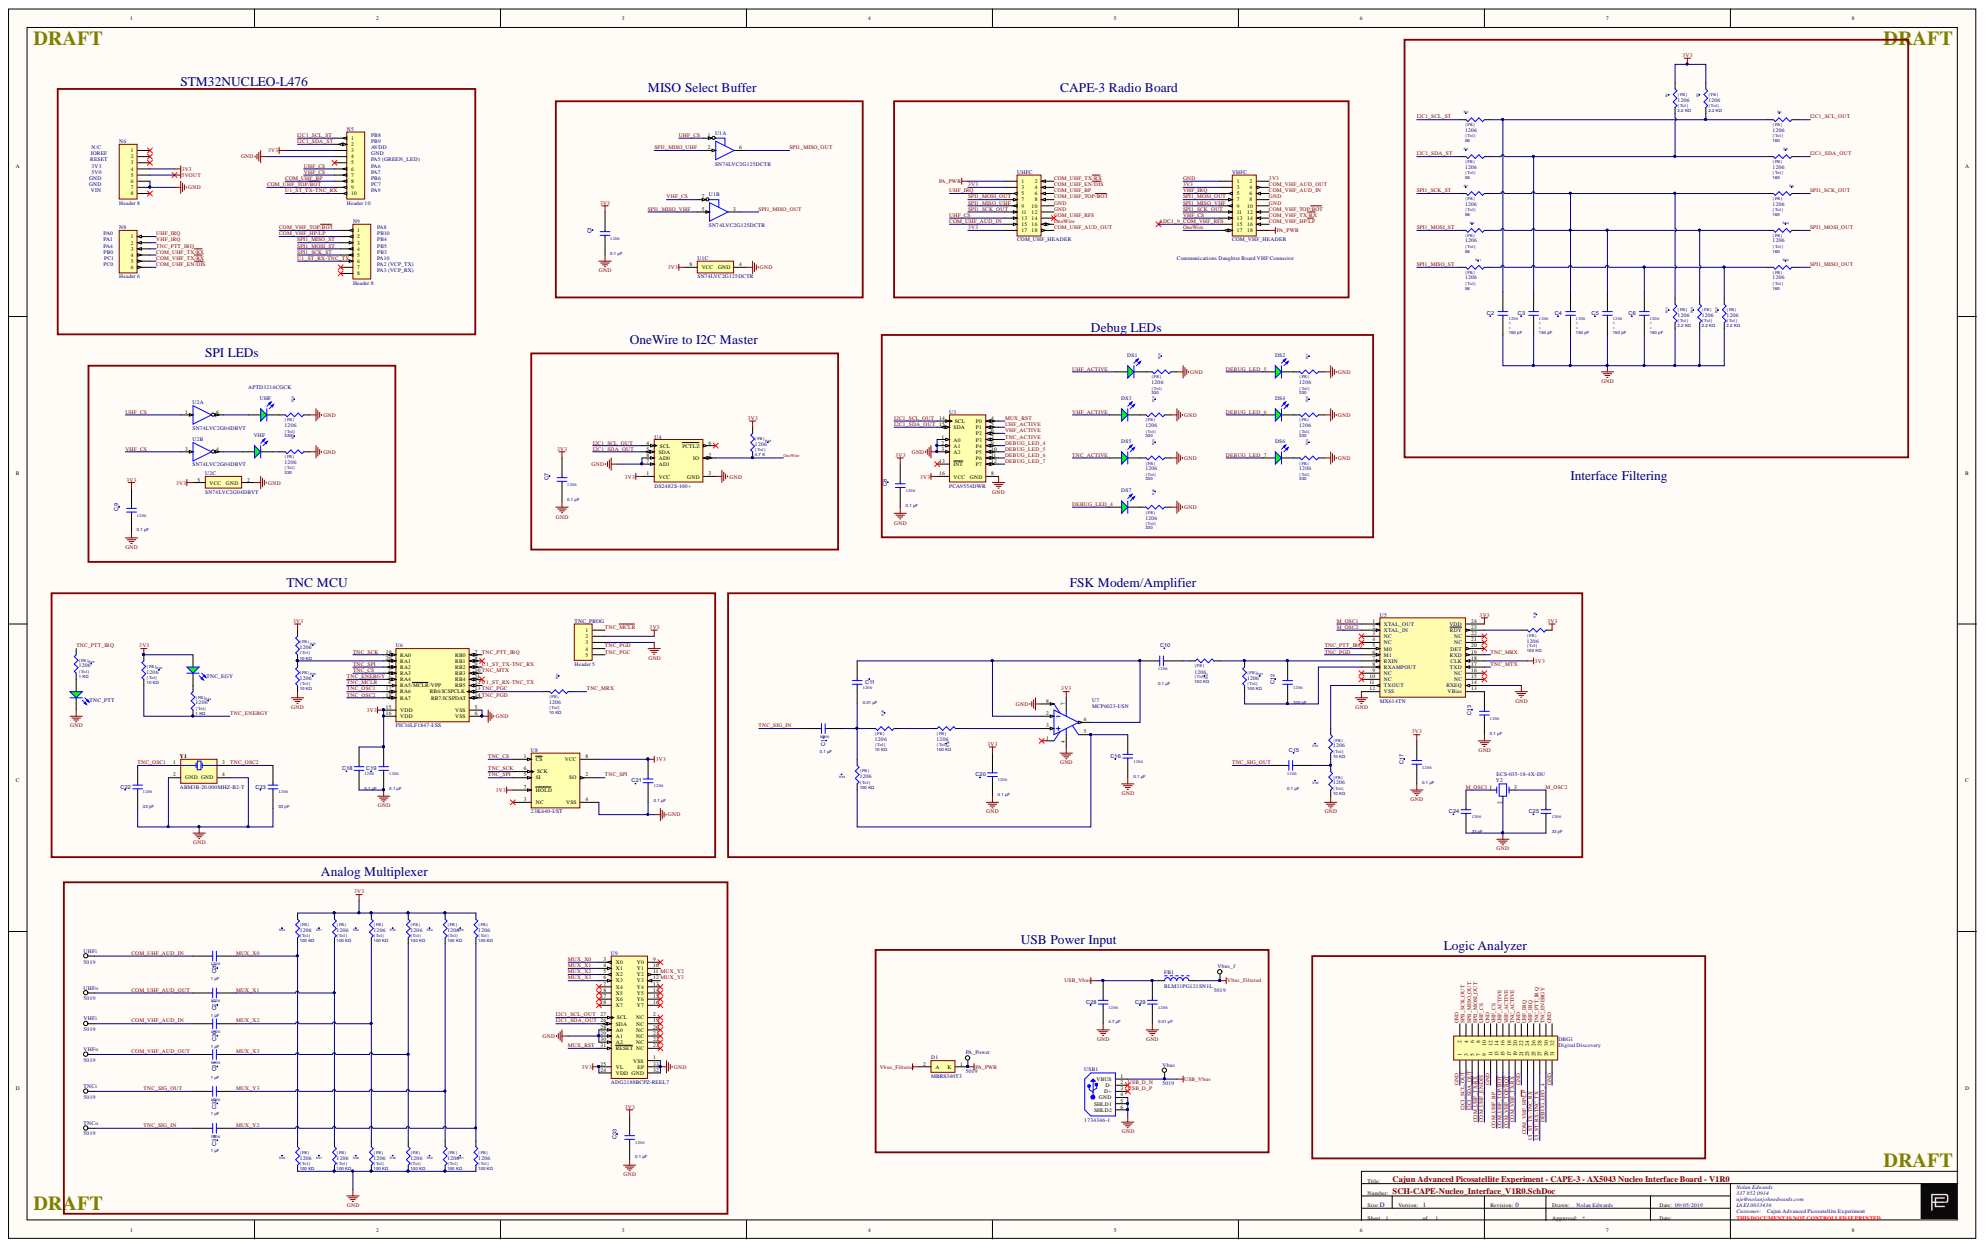
[picture p278: page 1]

Communications Daughter Board VHF Connector

Nolan Edwards
nje@nolanjohnedwards.com
Customer:
THIS DOCUMENT IS NOT CONTROLLED IF PRINTED

Cajun Advanced Picosatellite Experiment
