MrLordLeon/TNCMCU/Design Deliverables (Paper Revisions)/Meeting Minutes/2_12_2020.pdf

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

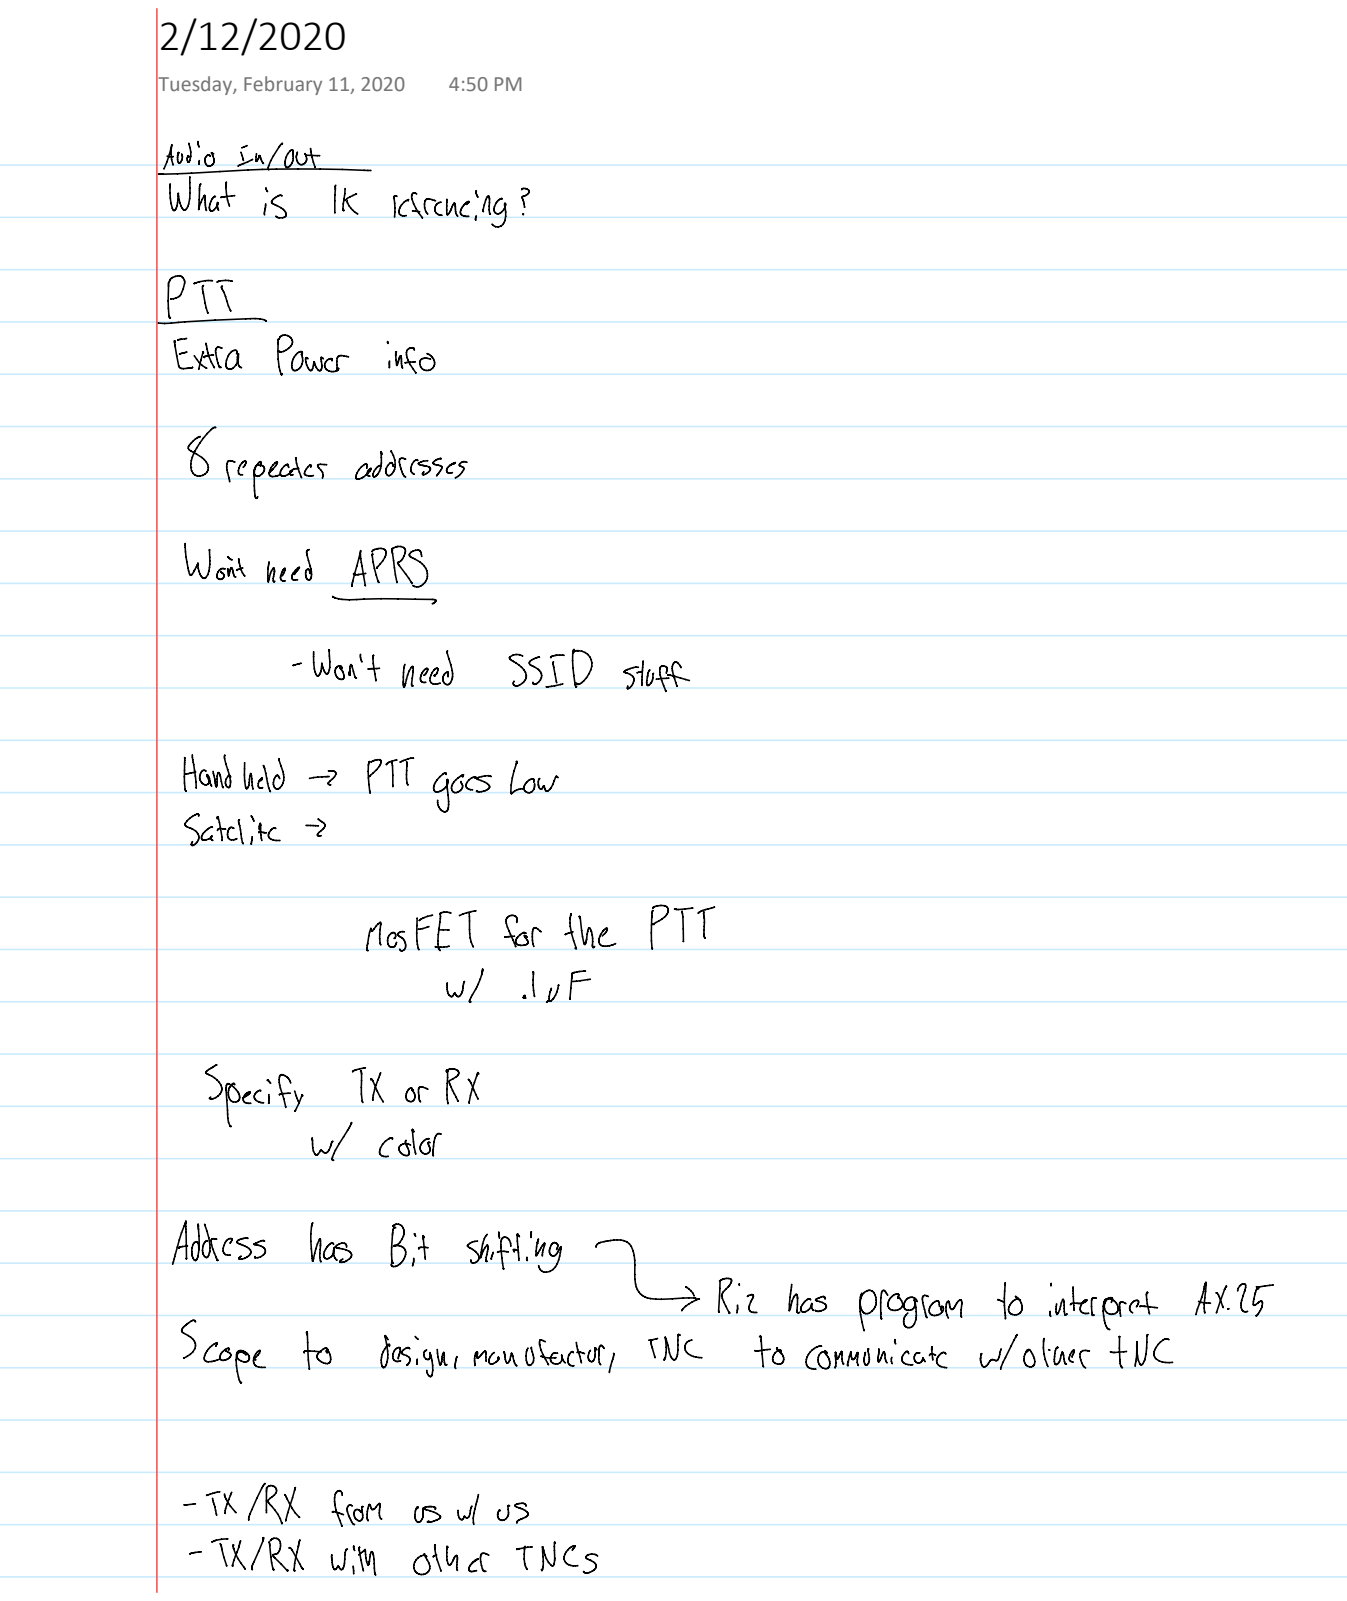
[picture p279: page 1]

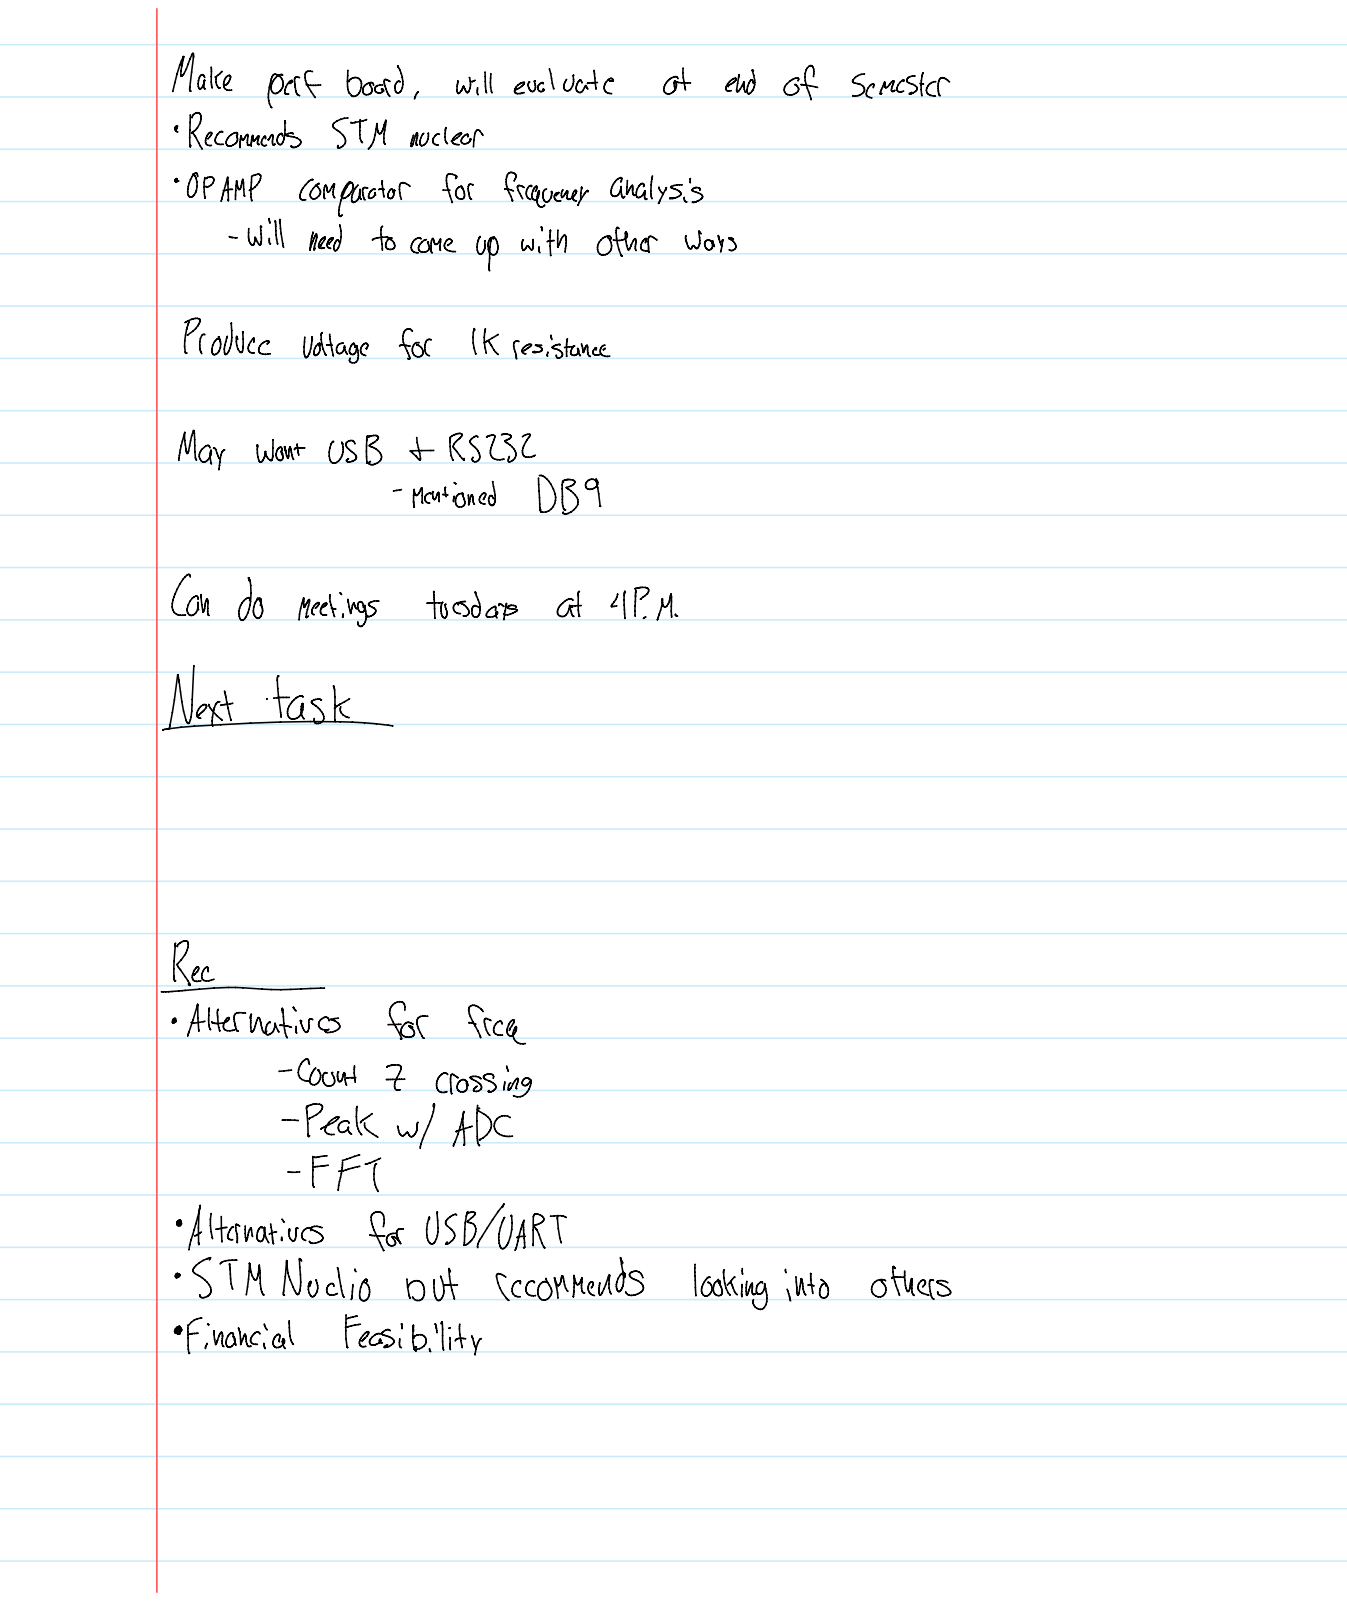
[picture p280: page 2]
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
