MrLordLeon/TNCMCU/Design Deliverables (Paper Revisions)/Meeting Minutes/2_5_2020.pdf

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

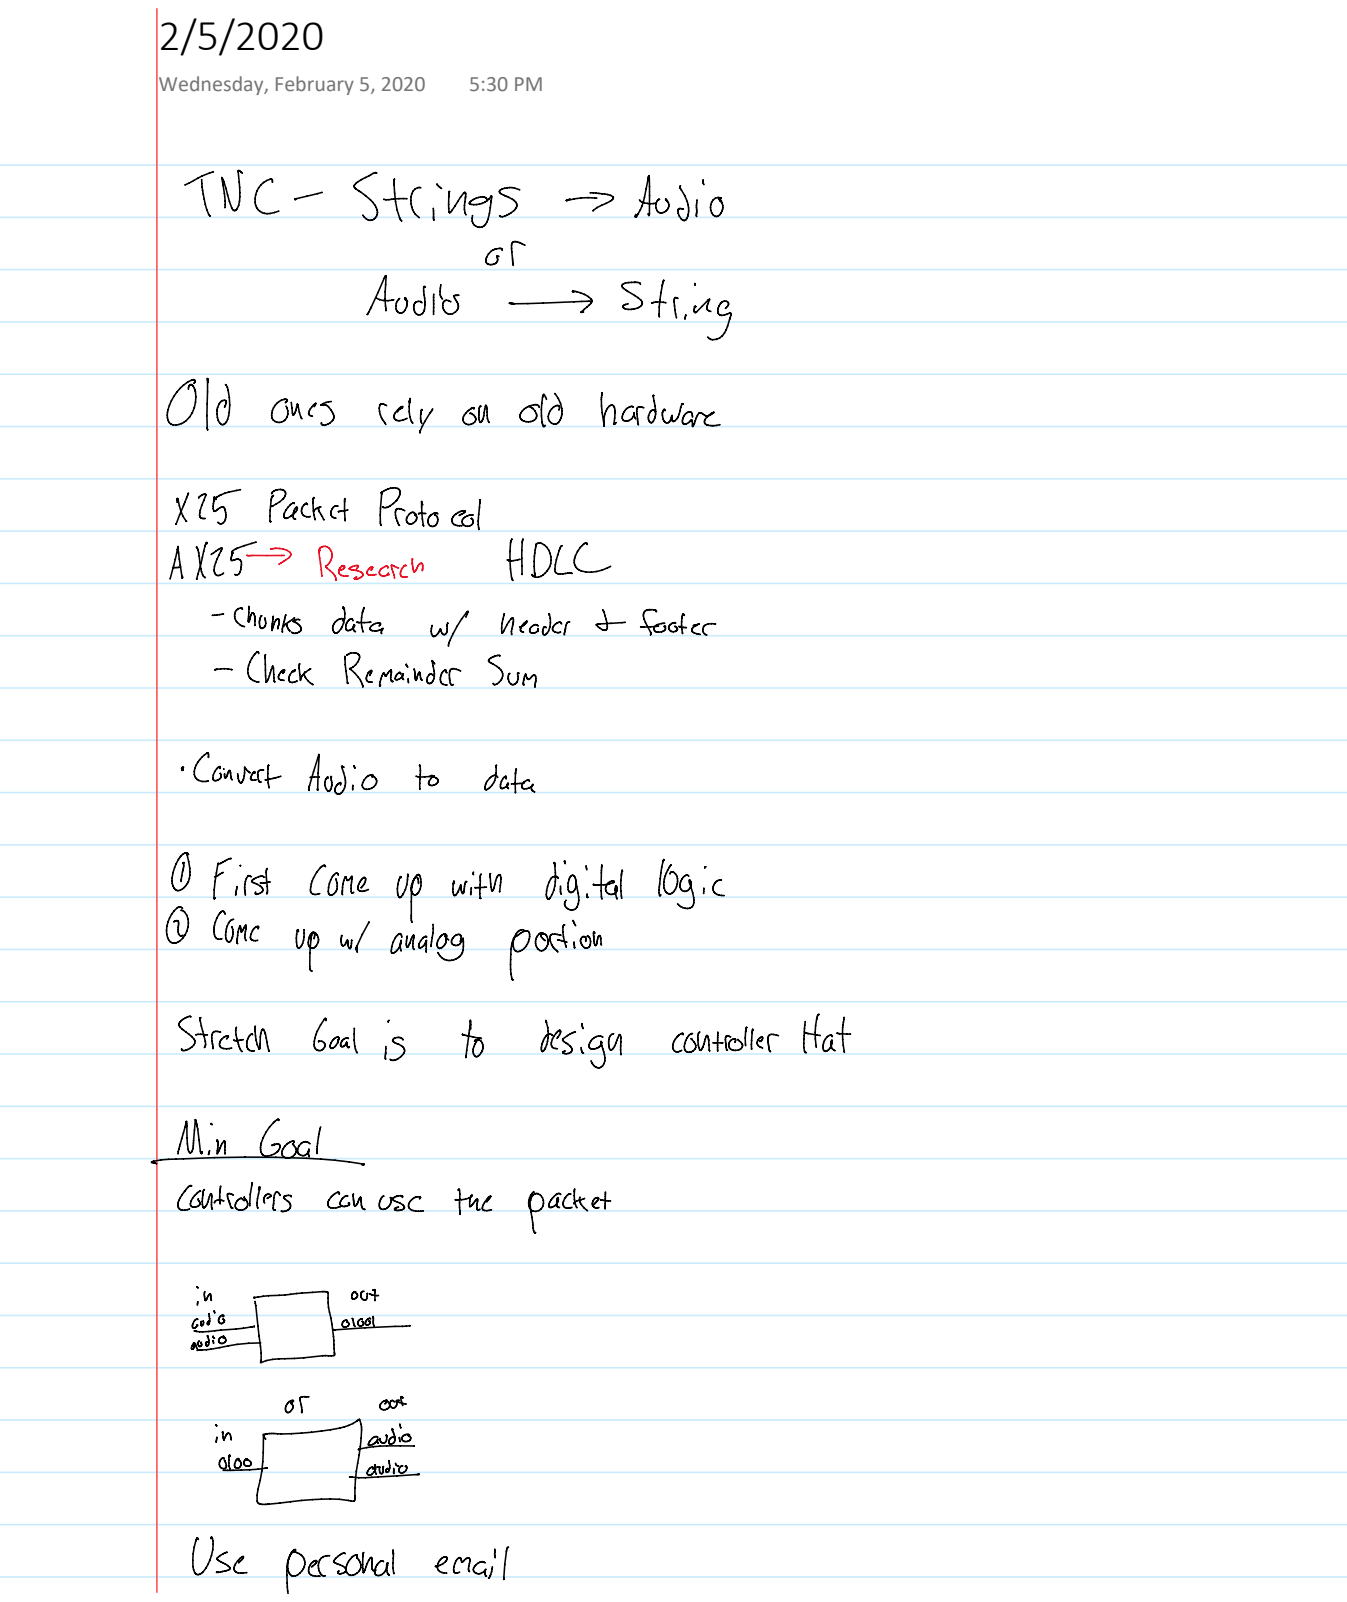
[picture p282: page 1]

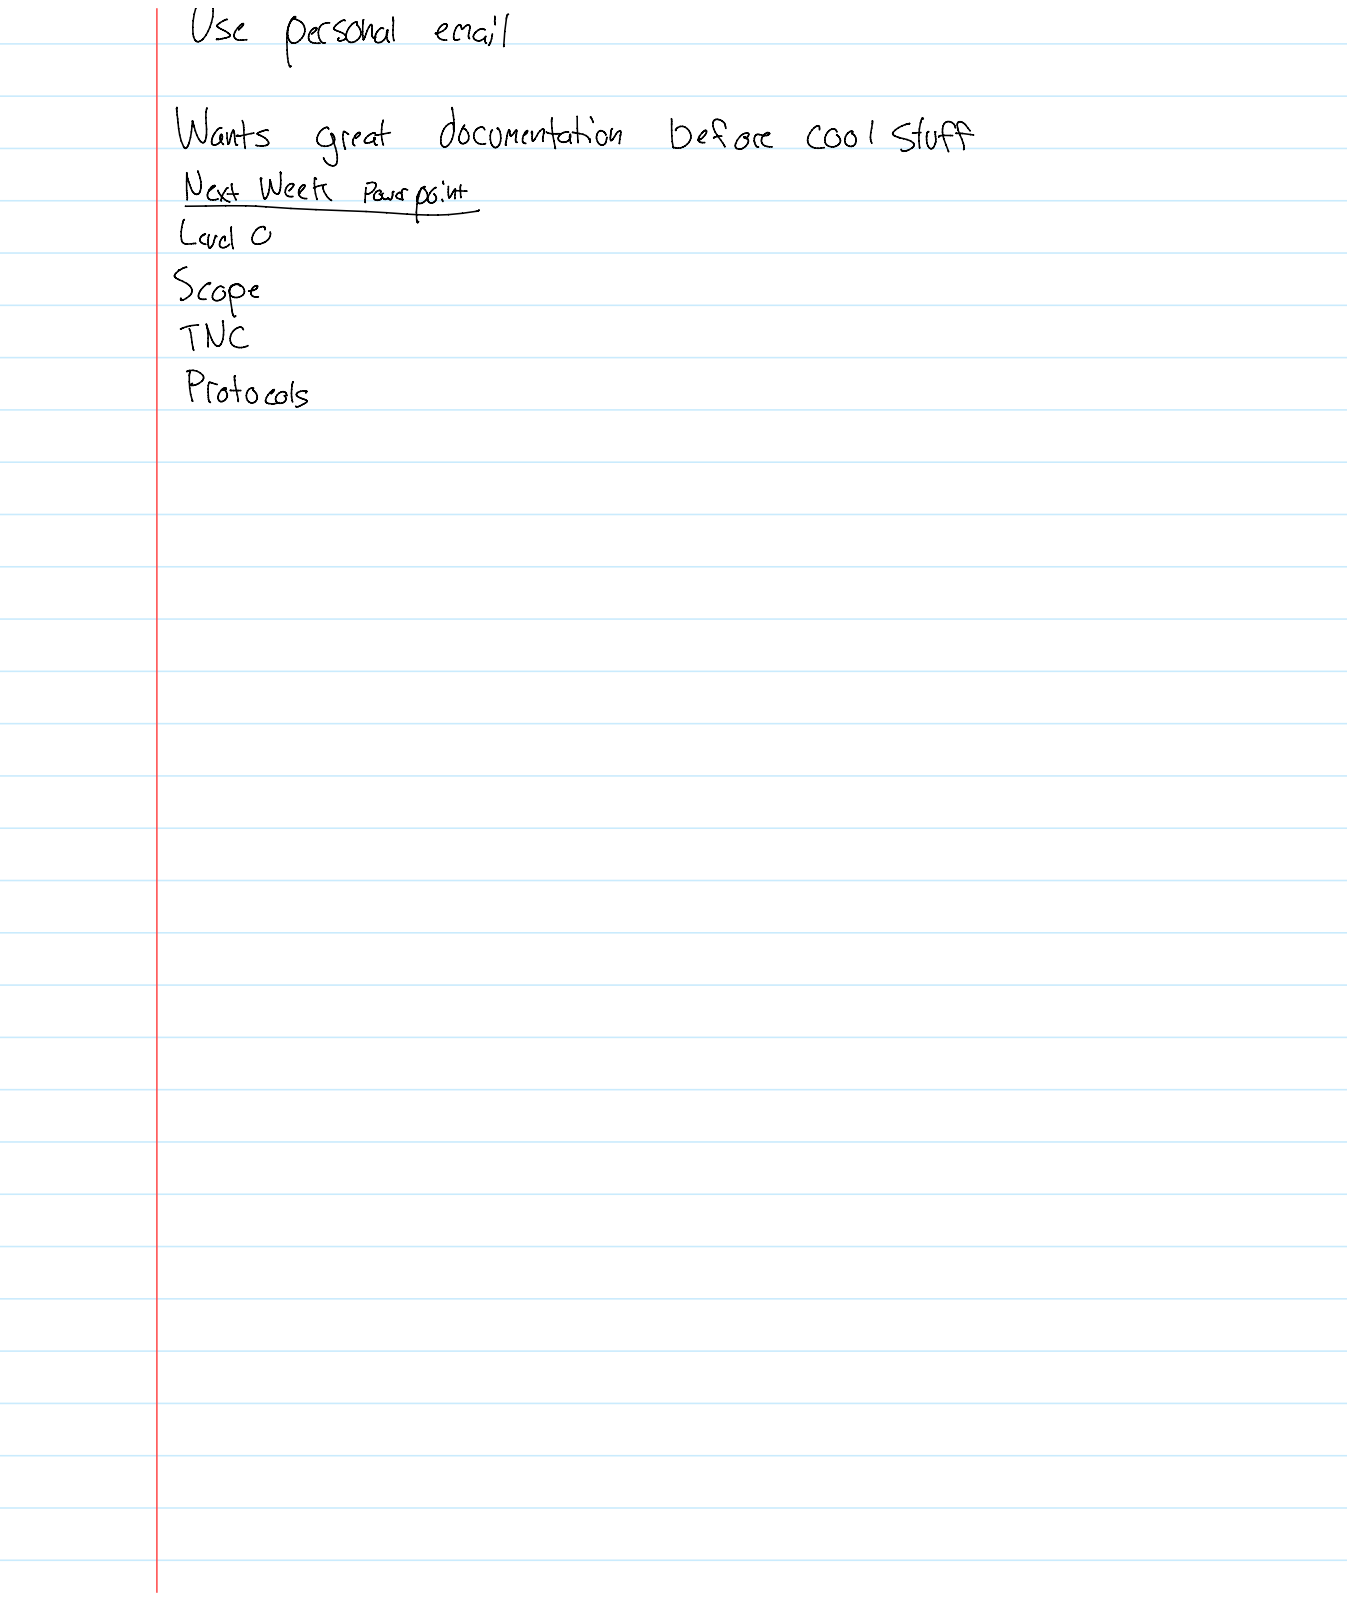
[picture p283: page 2]
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
