MrLordLeon/TNCMCU/Design Deliverables (Paper Revisions)/Meeting Minutes/3_10_2020.pdf

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

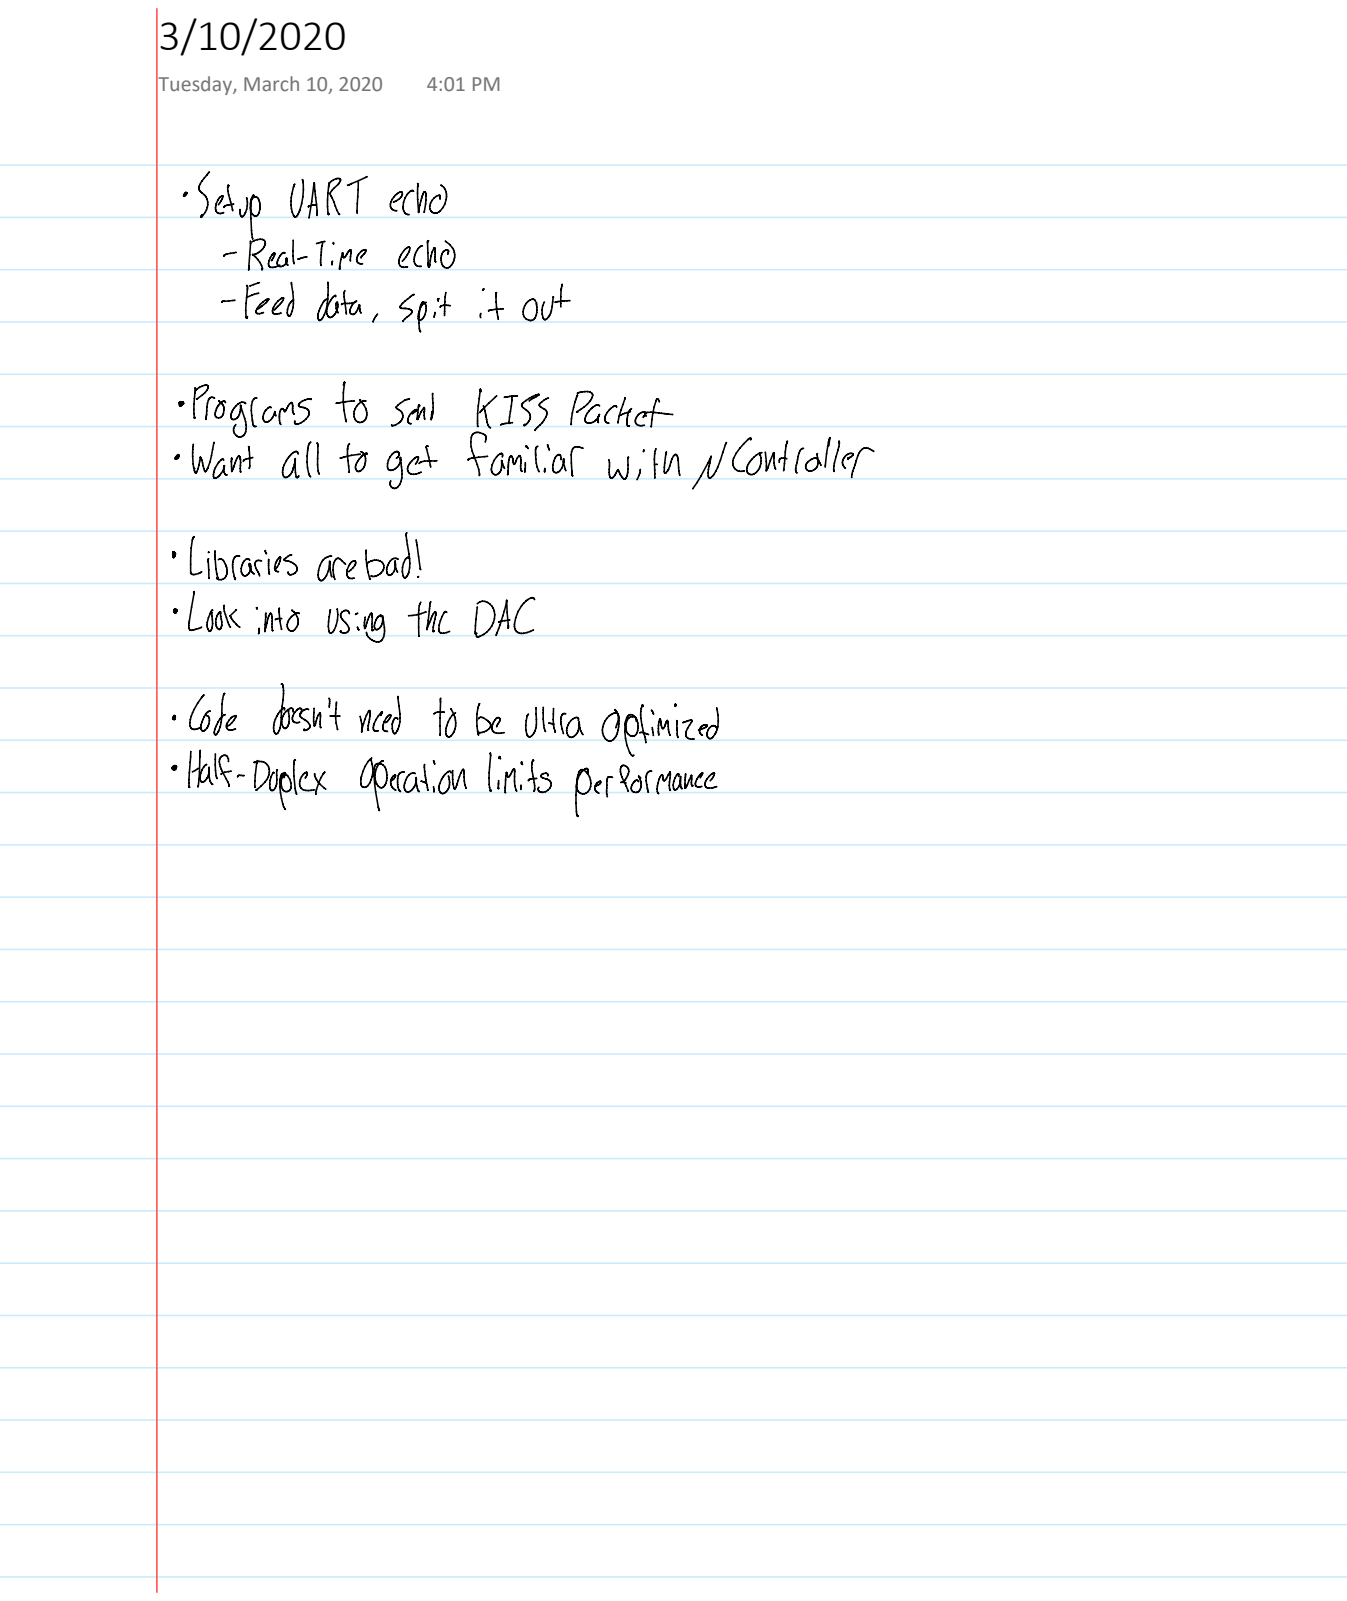
[picture p284: page 1]
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
