MrLordLeon/TNCMCU/Design Deliverables (Paper Revisions)/Meeting Minutes/8_18_2020.pdf

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

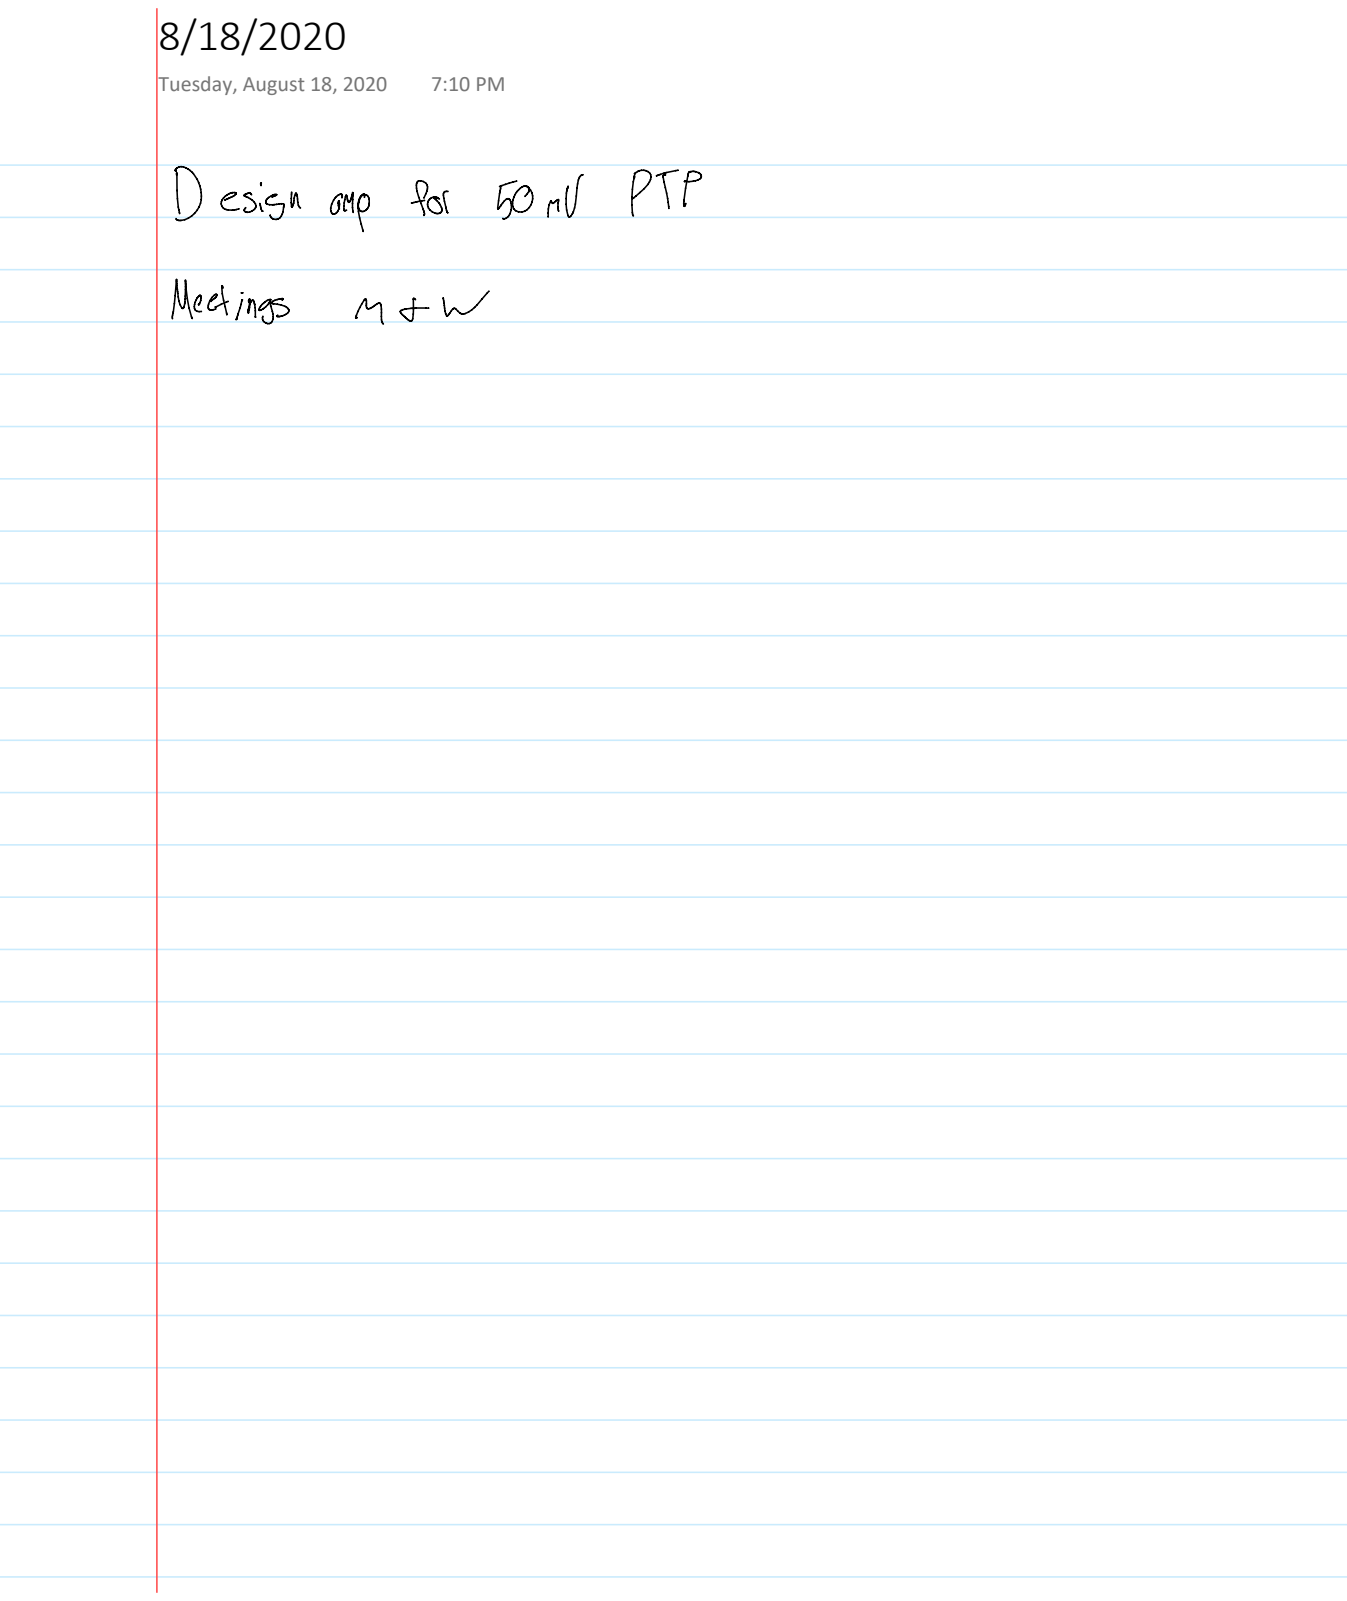
[picture p285: page 1]
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
