MrLordLeon/TNCMCU/Schematic/Ltspice/PTT circuit/PTT_Mosfet.asc

led: diode
M1: nmos; Si7336ADP
R1: res; 10k
R2: res; 10k
R4: res; 1000
V1: voltage; 15
V2: voltage; 0
Named nets: 0, Vd
.tran 100ms
