MrLordLeon/TNCMCU/Schematic/Ltspice/Rx_circuit/Rx_circuit.asc

C1: cap; 1µ
C2: cap; 1µ
C3: cap; 16n
C4: cap; 7n
Q1: npn; 2N2222
R1: res; 10k
R2: res; 10k
R3: res; 10k
R4: res; 10k
R5: res; 10k
R8: res; 10k
V1: voltage; 3.3
V2: voltage; V = (white(2e6*time)/10) + 25m*sin(2*pi*(1200*time))
Named nets: 0, Vout, Vin, Vfilter
.tran 100m
