MrLordLeon/TNCMCU/Schematic/Ltspice/Rx_circuit/Rx_circuit1.asc

C1: cap; 1µ
C2: cap; 1µ
C4: cap; .82n
Q1: npn; 2N2222
R1: res; 22k
R2: res; 13k
R3: res; 10k
R4: res; 10k
R5: res; 1k
R6: res; 25k
R8: res; 20k
V1: voltage; 3.3
V2: voltage; V = (white(2e6*time)/30)
V3: voltage; SINE(0 25m 2200)
Named nets: 0, Vout, Vin, Vfilter, Vreg
.tran 100m
