MrLordLeon/TNCMCU/Schematic/Ltspice/Rx_circuit/Rx_circuit2.asc

C1: cap; 1µ
C2: cap; 1µ
C3: cap; 1µ
C4: cap; .5n
C5: cap; 1µ
Q1: npn; 2N2222
Q2: npn; 2N2222
R1: res; 10k
R2: res; 10k
R3: res; 10k
R4: res; 10k
R5: res; 30k
R6: res; 11k
R7: res; 10k
R8: res; 30k
R9: res; 10k
V1: voltage; 3.3
V2: voltage; V = (white(2e6*time)/30)
V3: voltage; SINE(0 25m 2200)
Named nets: 0, V1, Vin, V2, Vout, Vreg
.tran 100m
