MrLordLeon/TNCMCU/Schematic/Ltspice/Rx_circuit/Rx_circuit3.asc

C1: cap; 1µ
C2: cap; 1µ
C3: cap; 1µ
C4: cap; 3.9n
C5: cap; 1µ
Q1: npn; 2N2222
Q2: npn; 2N2222
R1: res; 10k
R2: res; 10k
R3: res; 10k
R4: res; 10k
R5: res; 11k
R6: res; 10k
R7: res; 10k
R8: res; 10k
R9: res; 10k
R10: res; 150k
R11: res; 550k
V1: voltage; 3.3
V2: voltage; V = (white(2e6*time)/20)
V3: voltage; SINE(0 25m 2200)
Named nets: 0, V1, Vin, V2, Vout, Vreg
.tran 100m
