MrLordLeon/TNCMCU/(list of files, drawings)

Other design files:
Design Deliverables (Paper Revisions)/Assignment 2/Preliminary Design/BreadboardVer.fzz
Fritzing Schematics/Breadboard Schematic/BreadboardVer.fzz
Schematic/Fritzing Schematics/Breadboard Schematic/BreadboardVer.fzz
Software/Nolan Stuff/Nucleo-AX-Interface/CAPE-Nucleo_Interface_PCB/CAPE-Nucleo_Interface_PCB.PrjPcb
Software/Nolan Stuff/Nucleo-AX-Interface/CAPE-Nucleo_Interface_PCB/Layout/PCB-CAPE-Nucleo_Interface_V1R0.PcbDoc
Software/Nolan Stuff/Nucleo-AX-Interface/CAPE-Nucleo_Interface_PCB/Schematic/SCH-CAPE-Nucleo_Interface_V1R0.SchDoc
