MrLordLeon/TNCMCU/Schematic/EAGLE/MCUTNC/MCUTNC.sch

## EAGLE design Schematic/EAGLE/MCUTNC/MCUTNC.sch (2020-04-20)

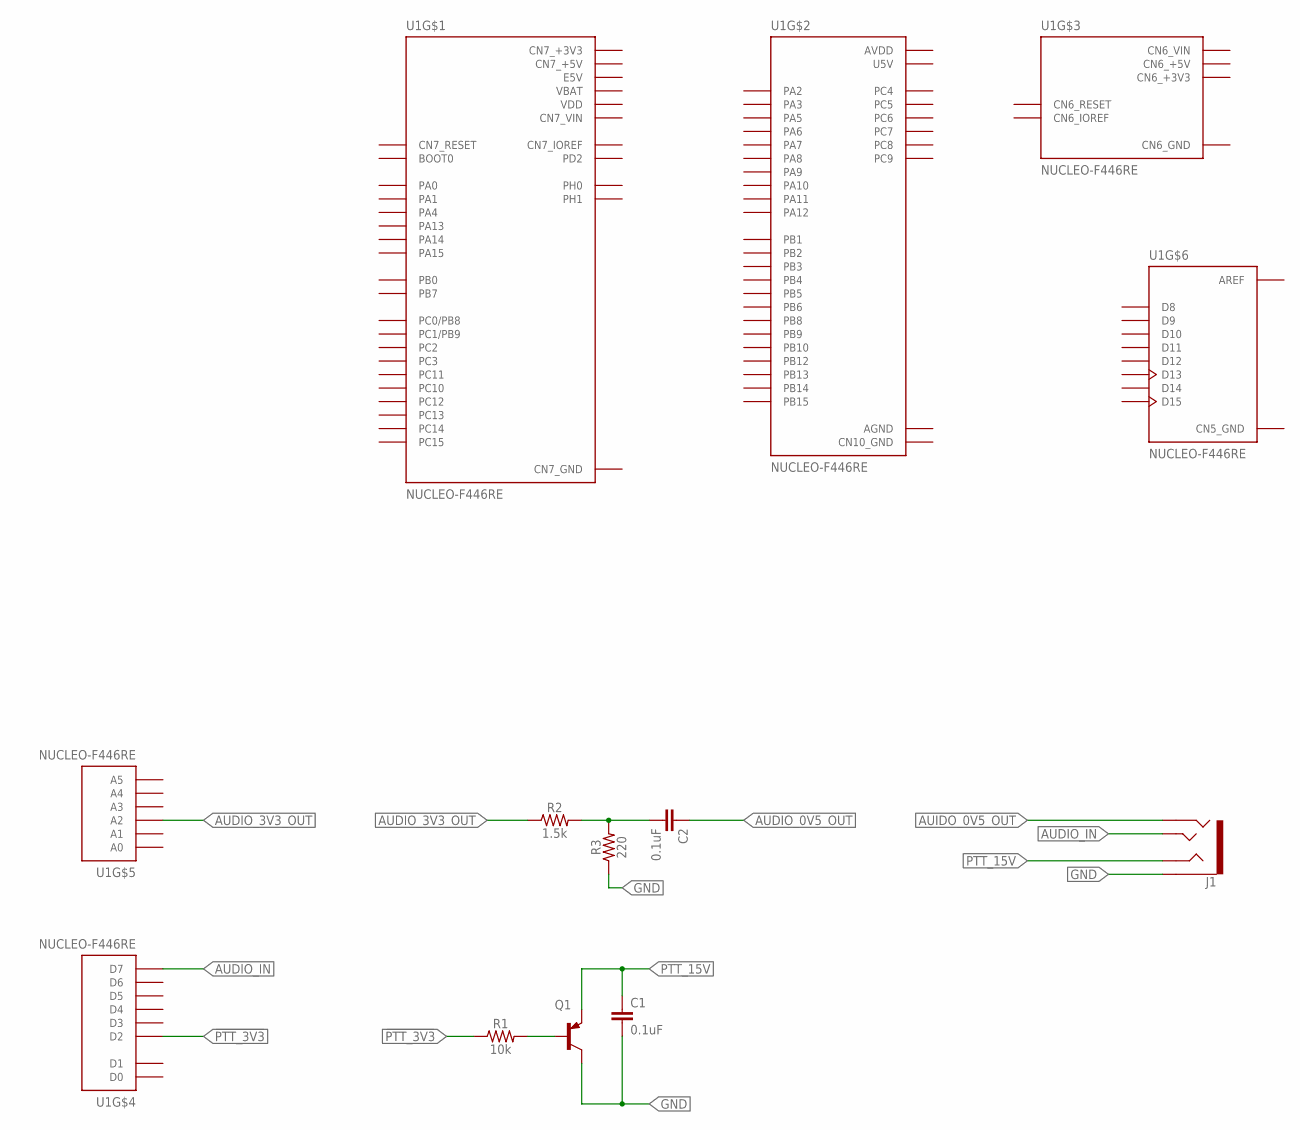
[picture p286: schematic MCUTNC.sch]

Parts:
C1, C2: 0.1uF; CAP-PTH-SMALL-KIT
J1: AUDIO_JACK_TRRSSMD_RA; AUDIO_JACK_3.5MM_TRRS_SMD_RA
Q1: MPSA56-TO92; TO92-CBE
R1: 10k; AXIAL-0.3
R2: 1.5k; AXIAL-0.3
R3: 220; AXIAL-0.3
U1: NUCLEO-F446RE; MODULE_NUCLEO-F446RE

Connections:
!PTT_3V3!: R1.P$1 (1), U1.CN9_3 (D2)
AUDIO_0V5_OUT: C2.1
AUDIO_3V3_OUT: R2.P$1 (1), U1.CN8_3 (A2)
AUDIO_IN: J1.TIP, U1.CN9_8 (D7)
AUIDO_0V5_OUT: J1.RING2
GND: C1.2, J1.EARTH, Q1.C, R3.P$1 (1)
unnamed: Q1.B, R1.P$2 (2)
unnamed: C2.2, R2.P$2 (2), R3.P$2 (2)
PTT_15V: C1.1, J1.RING1, Q1.E
