MrLordLeon/TNCMCU/Software/Nolan Stuff/Clock Recovery/Core/Src/main.c

/**
  ******************************************************************************
  * @file           : main.c
  * @brief          : Main program body
  ******************************************************************************
  ** This notice applies to any and all portions of this file
  * that are not between comment pairs USER CODE BEGIN and
  * USER CODE END. Other portions of this file, whether 
  * inserted by the user or by software development tools
  * are owned by their respective copyright owners.
  *
  * COPYRIGHT(c) 2020 STMicroelectronics
  *
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
  ******************************************************************************
  */
/* Includes ------------------------------------------------------------------*/
#include "main.h"
#include "stm32l4xx_hal.h"
#include "tim.h"
#include "usart.h"
#include "gpio.h"


/* USER CODE BEGIN PV */

/* USER CODE END PV */

void SystemClock_Config(void);
static void MX_NVIC_Init(void);

/* USER CODE BEGIN PFP */

/* USER CODE END PFP */

/**
  * @brief  The application entry point.
  *
  * @retval None
  */
int main(void)
{
  /* MCU Configuration----------------------------------------------------------*/

  /* Reset of all peripherals, Initializes the Flash interface and the Systick. */
  HAL_Init();

  /* Configure the system clock */
  SystemClock_Config();

  /* Initialize all configured peripherals */
  MX_GPIO_Init();
  MX_USART2_UART_Init();
  MX_TIM2_Init();

  /* Initialize interrupts */
  MX_NVIC_Init();
  /* USER CODE BEGIN 2 */


	HAL_TIM_IC_Start_IT(&htim2, TIM_CHANNEL_4);		// start input capture on channel 4 in interrupt mode(on the STM32Nucleo-L432KC, this is PA3, which is mapped to the pin labeled A2)
	HAL_TIM_OC_Start_IT(&htim2, TIM_CHANNEL_2);		// start output compare on channel 2 in interrupt mode (on the STM32Nucleo-L432KC, this is PA1, which is mapped to the pin labeled A1)


	uint32_t blink_timer = 0;
  /* USER CODE END 2 */

  /* Infinite loop */
  /* USER CODE BEGIN WHILE */
	while (1)
	{

		if ((HAL_GetTick() - blink_timer) > 500)
		{
			blink_timer = HAL_GetTick();
			HAL_GPIO_TogglePin(LD3_GPIO_Port, LD3_Pin);		// blink LED to indicate that we are still alive
		}

		HAL_Delay(1);
		char array[100];
		sprintf(array, "Beginning AFSK transmission\n");
		HAL_UART_Transmit(&huart2, array, strlen(array), 10);

		//return false;

  /* USER CODE END WHILE */

  /* USER CODE BEGIN 3 */

	}
  /* USER CODE END 3 */

}

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
