MrLordLeon/TNCMCU/Software/Nolan Stuff/Clock Recovery/tnc432_1.ioc

Mcu.UserName=STM32L432KCUx
PA0.GPIO_Label=MCO [High speed clock in]
PA0.Signal=RCC_CK_IN
PA1.GPIO_Label=A1_OC
PA1.Signal=S_TIM2_CH2
PA10.GPIO_Label=D0
PA10.Signal=GPIO_Output
PA11.GPIO_Label=D10
PA11.Signal=GPIO_Output
PA12.GPIO_Label=D2
PA12.Signal=GPIO_Input
PA2.GPIO_Label=VCP_TX
PA2.Signal=USART2_TX
PA3.GPIO_Label=A2_IC
PA3.Signal=S_TIM2_CH4
PA4.GPIO_Label=A3
PA4.Signal=GPIO_Output
PA6.GPIO_Label=A5
PA6.Signal=GPIO_Output
PA7.GPIO_Label=A6
PA7.Signal=GPIO_Output
PA8.GPIO_Label=D9
PA8.Signal=GPIO_Output
PA9.GPIO_Label=D1
PA9.Signal=GPIO_Output
PB0.GPIO_Label=D3
PB0.Signal=GPIO_Output
PB1.GPIO_Label=D6
PB1.Signal=GPIO_Output
PB5.GPIO_Label=D11
PB5.Signal=GPIO_Output
PB6.GPIO_Label=D5
PB6.Signal=GPIO_Output
PB7.GPIO_Label=D4
PB7.Signal=GPIO_Output
