MrLordLeon/TNCMCU/Software/Code Playground/DAC_SINEWAVE/Core/Src/debug.h

/*
 * debug.h
 *
 *  Created on: Nov 1, 2020
 *      Author: monke
 */

#ifndef SRC_DEBUG_H_
#define SRC_DEBUG_H_

#include "main.h"
#include "AX.25.h"

//Printing Packets
//****************************************************************************************************************
void print_AX25();

void print_outAX25();

void print_KISS();
//****************************************************************************************************************

//Direct testing on subsystems
//****************************************************************************************************************
void test_remove_bitstuffing();

//****************************************************************************************************************

#endif /* SRC_DEBUG_H_ */
