MrLordLeon/TNCMCU/(commit log)

2020-03-03 Create BOM 3_3_2020.xlsx
    [BOM 3_3_2020.xlsx]
2020-03-03 Adding early TX/RX flow chart
2020-03-04 Edited BOM and setting coding folder
    [BOM 3_3_2020.xlsx]
2020-03-11 Adding my test code for the STM32
2020-03-17 Adding fritzing schematics
    This includes the program as well the schematic to include with assignment 2
    [3_16_20.fzz, 555TouchSwitch.fzz, 7Segment_direct.fzz, Amplification.fzz, AnalogInputFSR.fzz, AnalogInputOutput.fzz, AnalogInputPot.fzz, AnalogInputThermistor.fzz]
2020-03-18 I've added a lot. I've also tried to add files as HTML that will load the webpage for you
    [BOM 3_3_2020.xlsx, BreadboardVer.fzz]
2020-03-19 Create TNCMCU Flow Chart.png
2020-03-19 Flowchart 2
2020-03-19 Flow chart update
2020-03-23 wE GOT THEM BOARDS BABEE :100: :100:
2020-03-24 Got a PWM thingy working!
2020-03-24 nOW IT REACTS TO BUTTON :black_square_button:
2020-04-01 Update FLOW CHART.docx
2020-04-20 Making a schematic
    [BOM 3_3_2020.xlsx, BreadboardVer.fzz, Eagle_BOM.xlsx, MCUTNC.sch]
2020-04-20 dumb temp files
    [MCUTNC.sch]
2020-04-20 Wiring Assembly in Assignment 3
2020-04-20 Assembly instructions
2020-08-02 Weird bug when toggling modes. Not sure why
    [main.c, main.h]
2020-08-04 Beginning mode switch debugging
2020-08-05 new adc
2020-08-18 This is the sauce
    [data.csv, sine.csv]
2020-09-01 FSK bitstream reading is officially implemented
    [data.csv, sine.csv]
2020-09-01 Start/end flag capability added
    [data.csv]
2020-09-02 Just some testing
    [data.csv]
2020-09-09 Working integer accelerator
    [data.csv]
2020-09-20 Buffer filling code
    [data.csv]
2020-09-20 Updating bitstream code
    [data.csv]
2020-09-20 Create Reference Sheet.xlsx
    [Reference Sheet.xlsx]
2020-09-26 Trying to make this dang packet radio, packet
    [data.csv]
2020-09-28 Create BOM 9_21_2020.xlsx
    [BOM 9_21_2020.xlsx]
2020-10-04 BEAM ME UP
    [Reference Sheet.xlsx]
2020-10-12 Added KISS_Transmitting (to PC over UART)
2020-10-16 we got uart packets bois
2020-10-17 Got a good flow for recieving AX.25
2020-10-17 ltspice schematics
2020-10-17 voltage divider for Rx_Circuit
2020-10-18 Renamed Folder
    [BOM 3_3_2020.xlsx, BOM 9_21_2020.xlsx, BreadboardVer.fzz, Eagle_BOM.xlsx]
2020-10-23 plz sync so I can fix this frequency counter code
    [main.c]
2020-10-24 gosh dang microcontroller
    [data.csv]
2020-10-28 Adding Nolan's file
    [CAPE-Nucleo_Interface_PCB.PrjPcb, CAPE-Nucleo_Interface_PCB.xls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]
2020-11-01 bit stuffing correct I think
    [AX.25.h]
2020-11-01 adding the clock code. Does not currently work.
2020-11-02 Deliverable 5 Stuff added
    [BOM 3_3_2020.xlsx, BOM 9_21_2020.xlsx, Eagle_BOM.xlsx]
2020-11-03 Working on some clock recovery
    [CAPE-Nucleo_Interface_PCB.PrjPcb, CAPE-Nucleo_Interface_PCB.xls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]
2020-11-06 Working on importing the NRZI interrupts
2020-11-10 sync before switch
2020-11-10 alright so frequency reading is correct again :airplane:
    [AX.25.h, debug.h, interrupt_services.h, main.c, main.h]
2020-11-11 DAC and ADC work!
2020-11-12 testing adc frequency reader that doesn't work
    [main.c, main.h]
2020-11-12 adc code
2020-11-12 adc still not fucking working
